SHAMIKO-project/SHAMIKO-board/docs/manual/images/PowerSeq.pdf

0ms | 8ms | 22ms

+1.0V FPGA Logic

+1.8V FPGA VCC AUX

+3.3V FPGA IO
