SHAMIKO-project/SHAMIKO-board/docs/manual/images/Clock.pdf

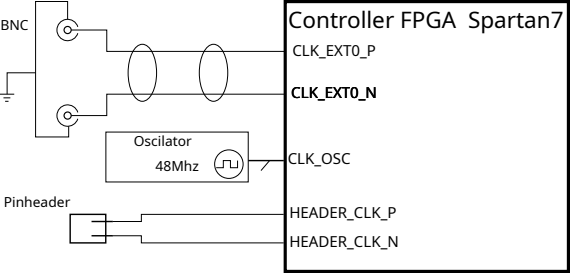
[picture p2: figure]
CLK_OSC; HEADER_CLK_P HEADER_CLK_N; Controller FPGA Spartan7; 48Mhz; Oscilator; BNC; Pinheader; CLK_EXT0_NCLK_EXT0_N CLK_EXT0_N; CLK_EXT0_P
