SHAMIKO-project/SHAMIKO-board/docs/manual/images/LT3071.pdf

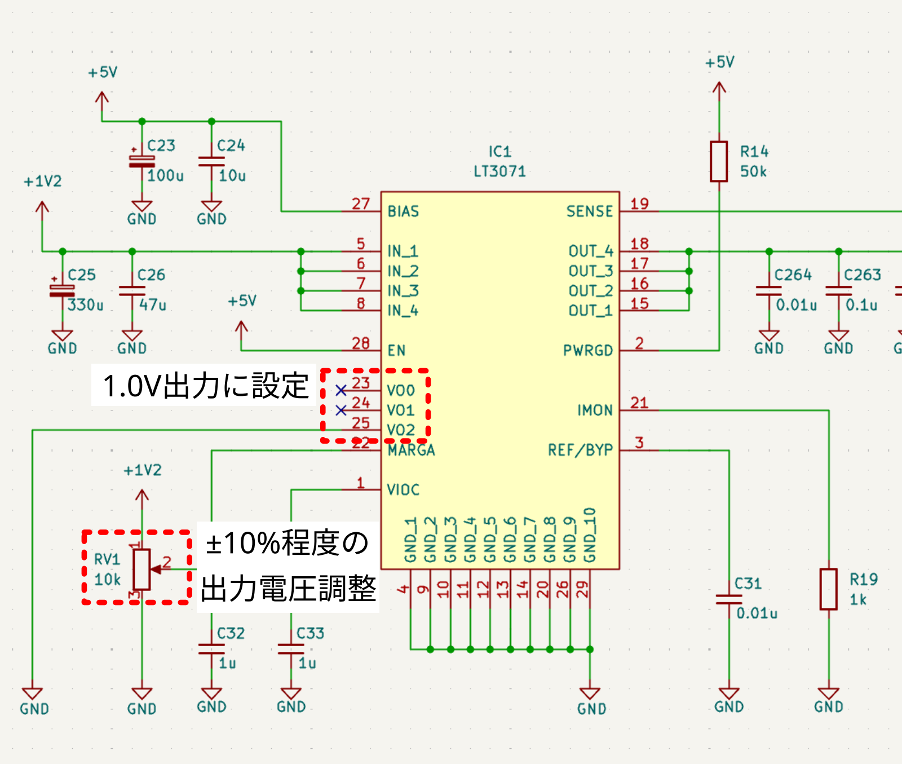
[picture p3: page 1]

1.0V出力に設定

±10%程度の
出力電圧調整
