SHAMIKO-project/SHAMIKO-board/docs/manual/images/System.pdf

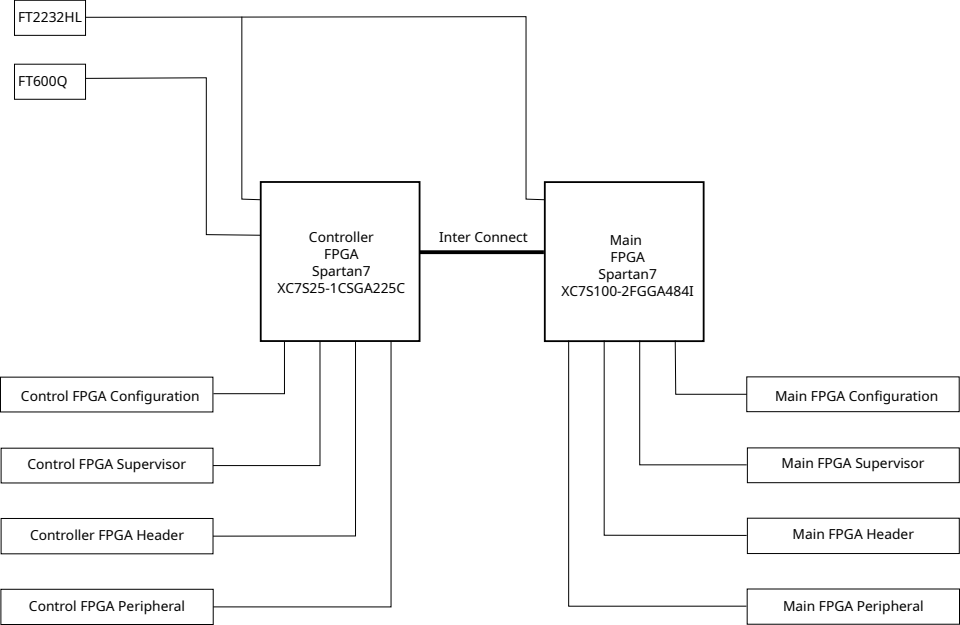
[picture p4: figure]
Controller FPGA Spartan7 XC7S25-1CSGA225C; Control FPGA Configuration; Control FPGA Supervisor; Controller FPGA Header; Control FPGA Peripheral; Main FPGA Configuration; Main FPGA Supervisor; Main FPGA Header; Main FPGA Peripheral; Main FPGA Spartan7 XC7S100-2FGGA484I; Inter Connect
