SHAMIKO-project/SHAMIKO-board/docs/manual/images/USB.pdf

# USB2

USB3 | FT600 | MainFPGA Controller
FPGA

~200 MB/s

~40 MB/s

FT2232 | ~40 MB/s
