SHAMIKO-project/SHAMIKO-board/docs/schematic.pdf

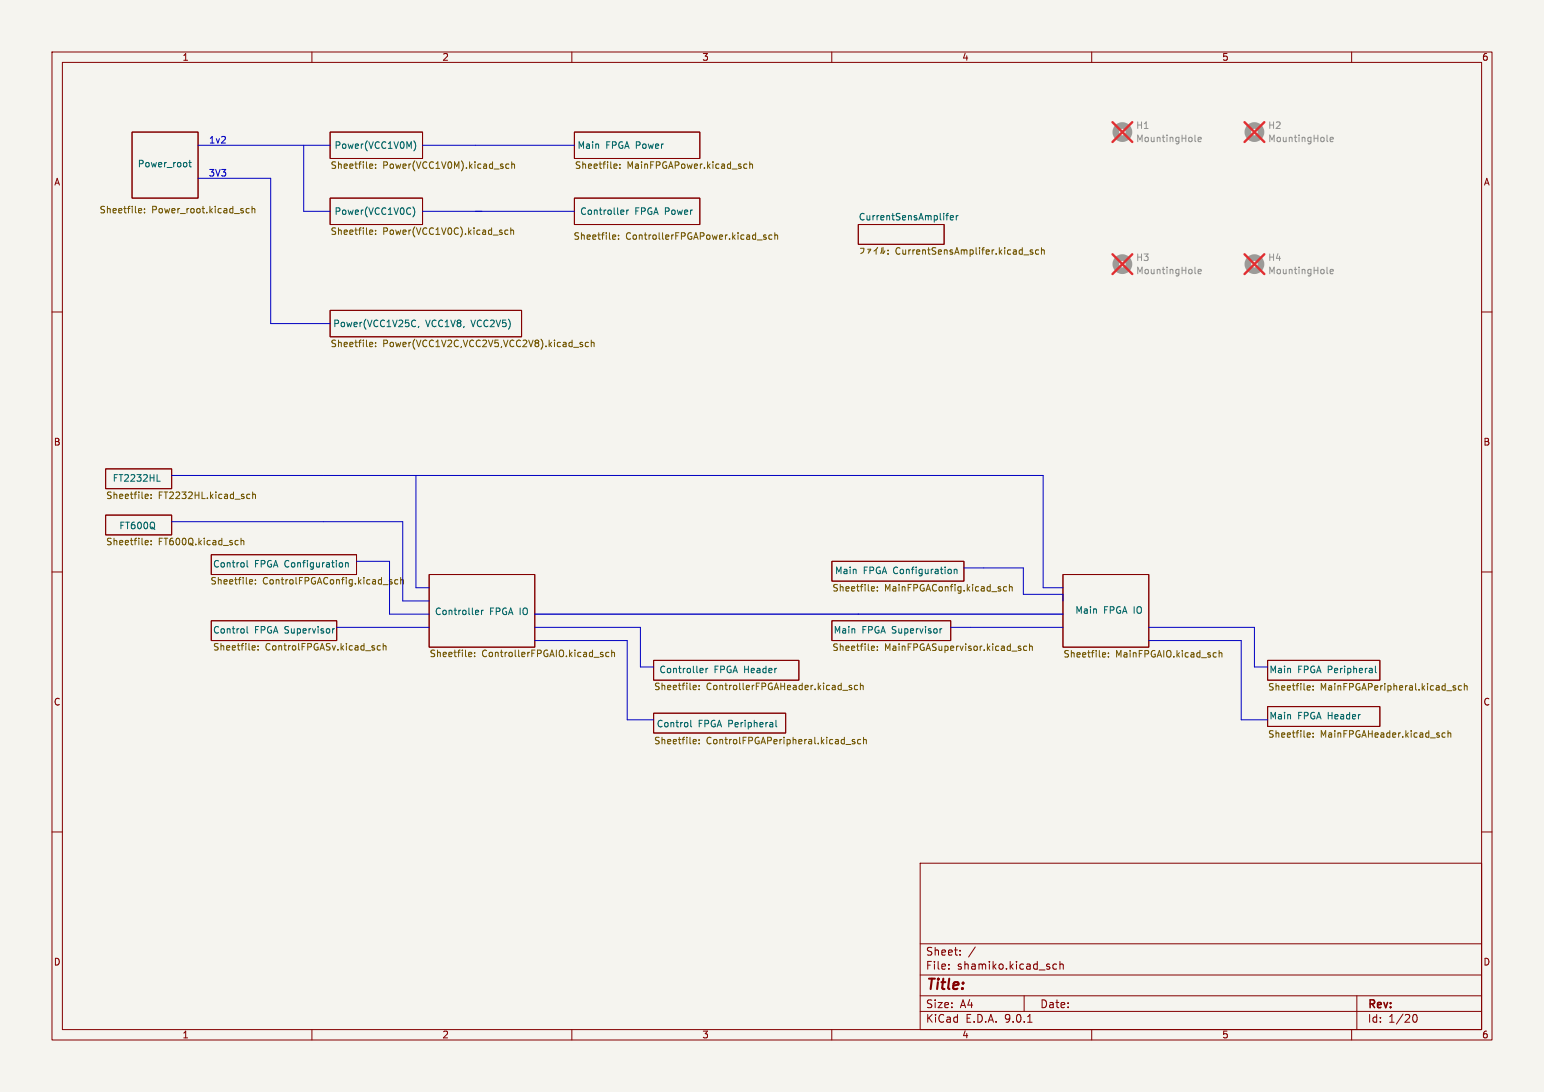
[picture p5: page 1]

Id: 1/20 Title: File: shamiko.kicad_sch Sheet: /

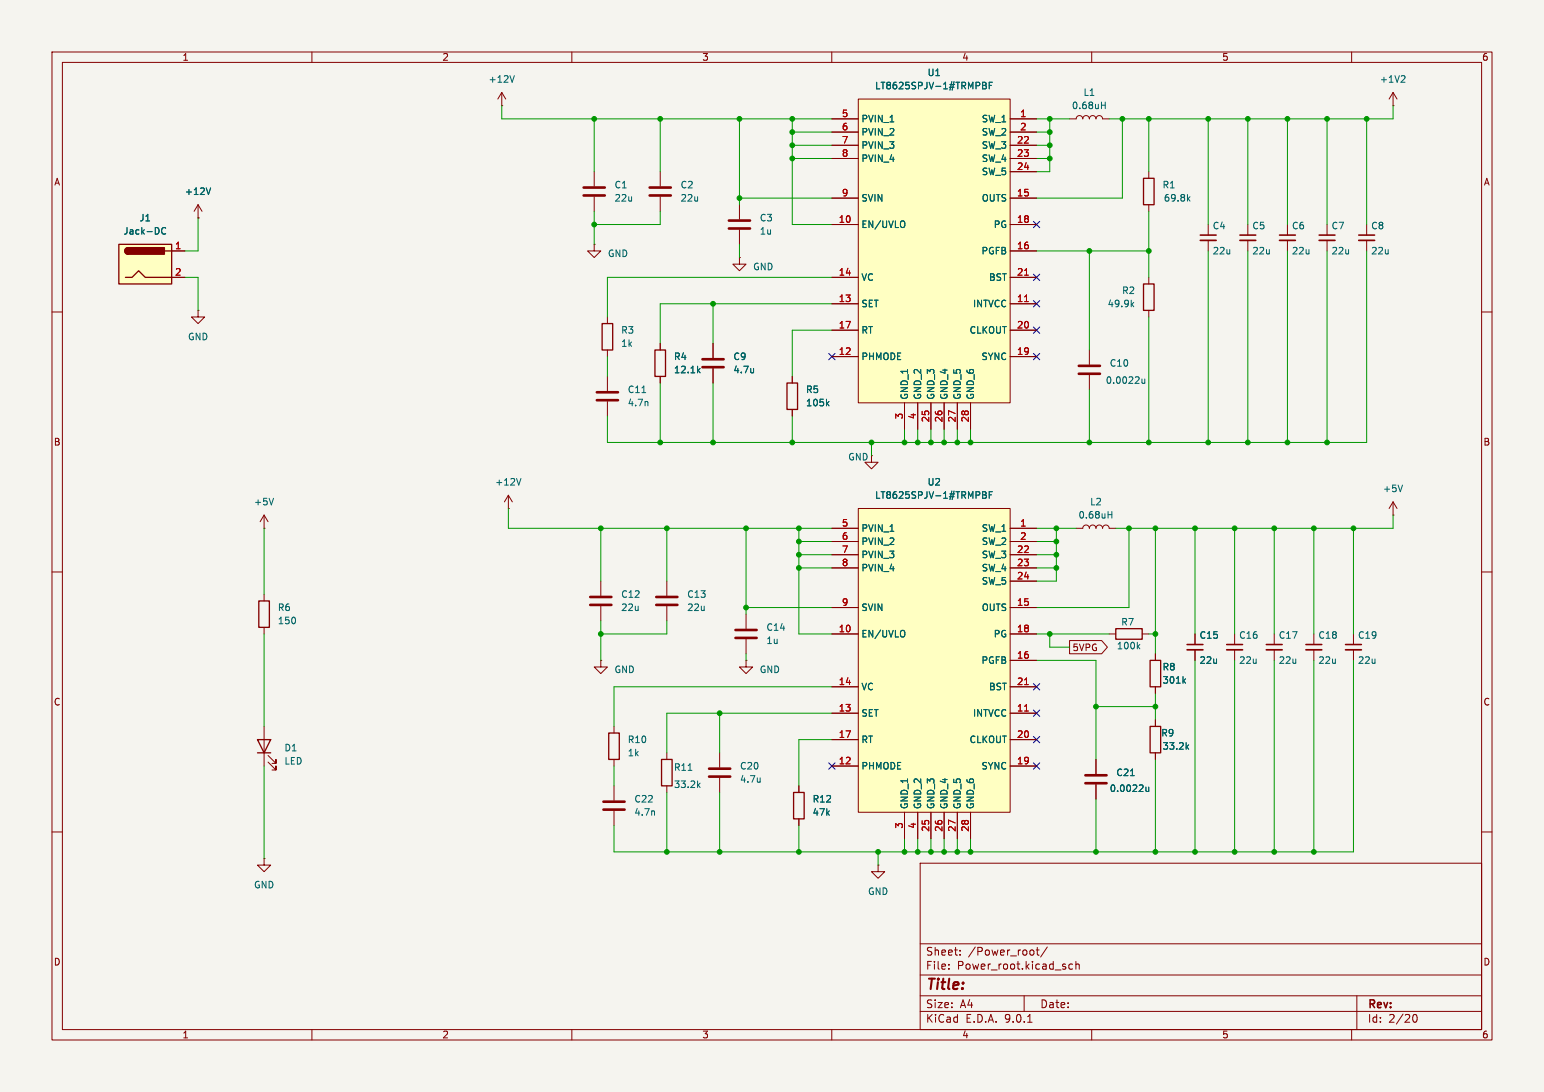
[picture p6: page 2]

Id: 2/20 Title: File: Power_root.kicad_sch Sheet: /Power_root/

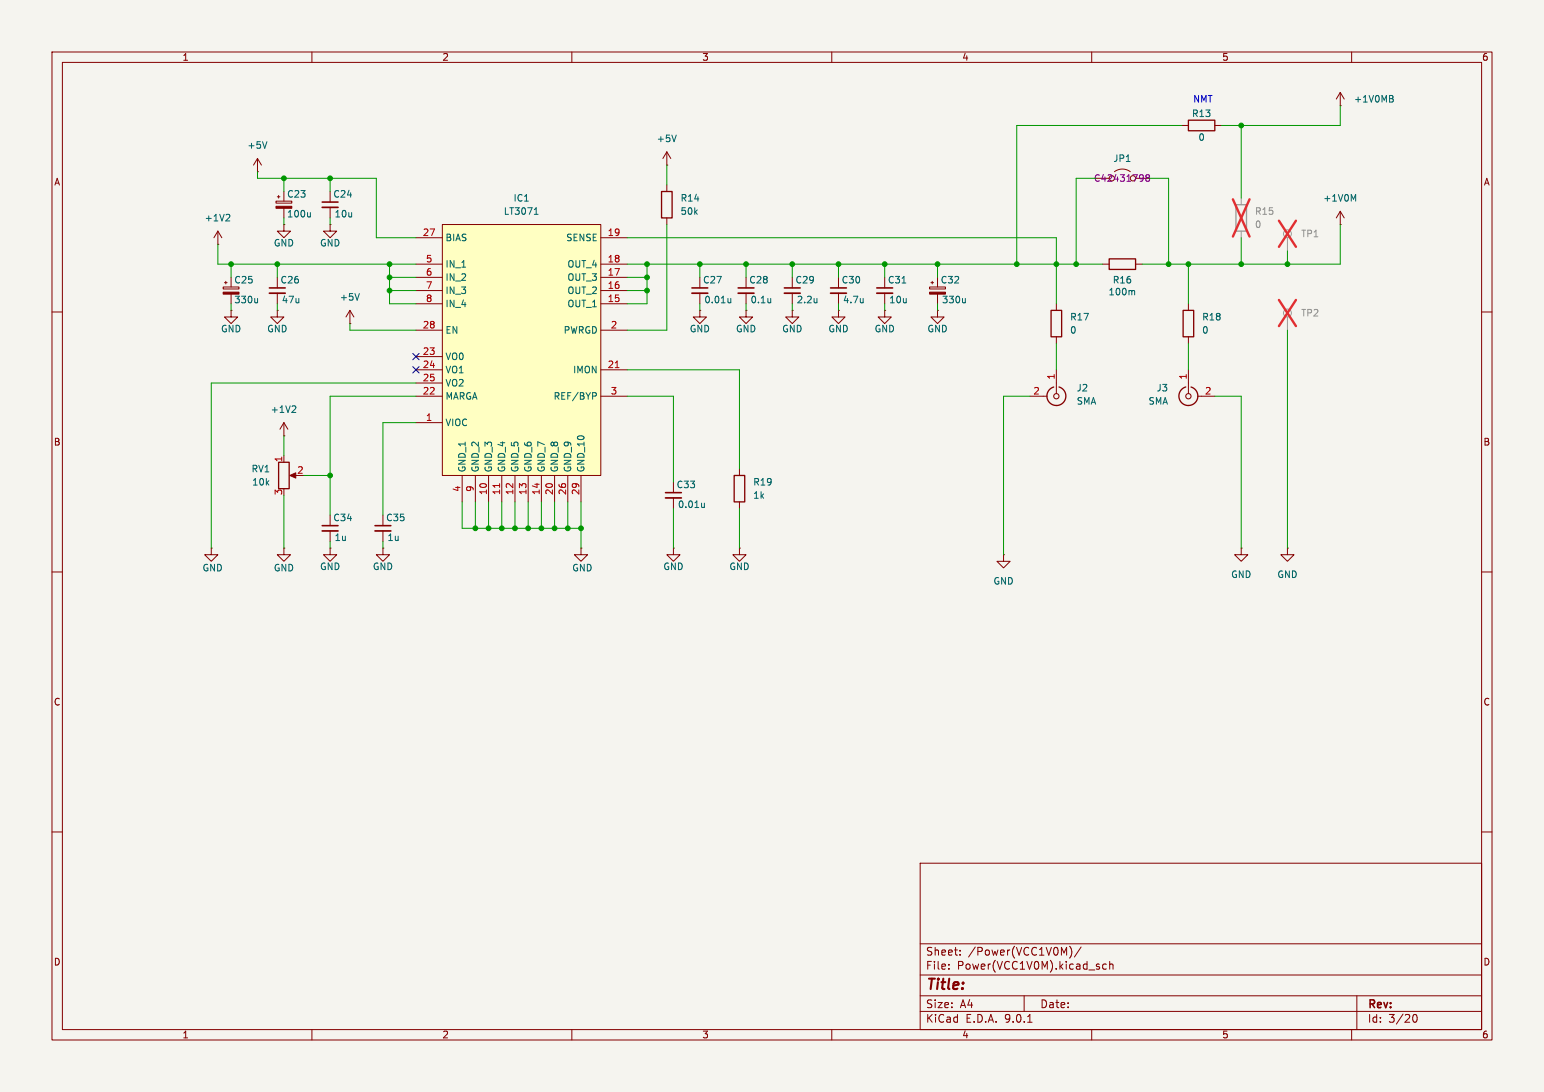
[picture p7: page 3]

Id: 3/20 Title: File: Power(VCC1V0M).kicad_sch Sheet: /Power(VCC1V0M)/

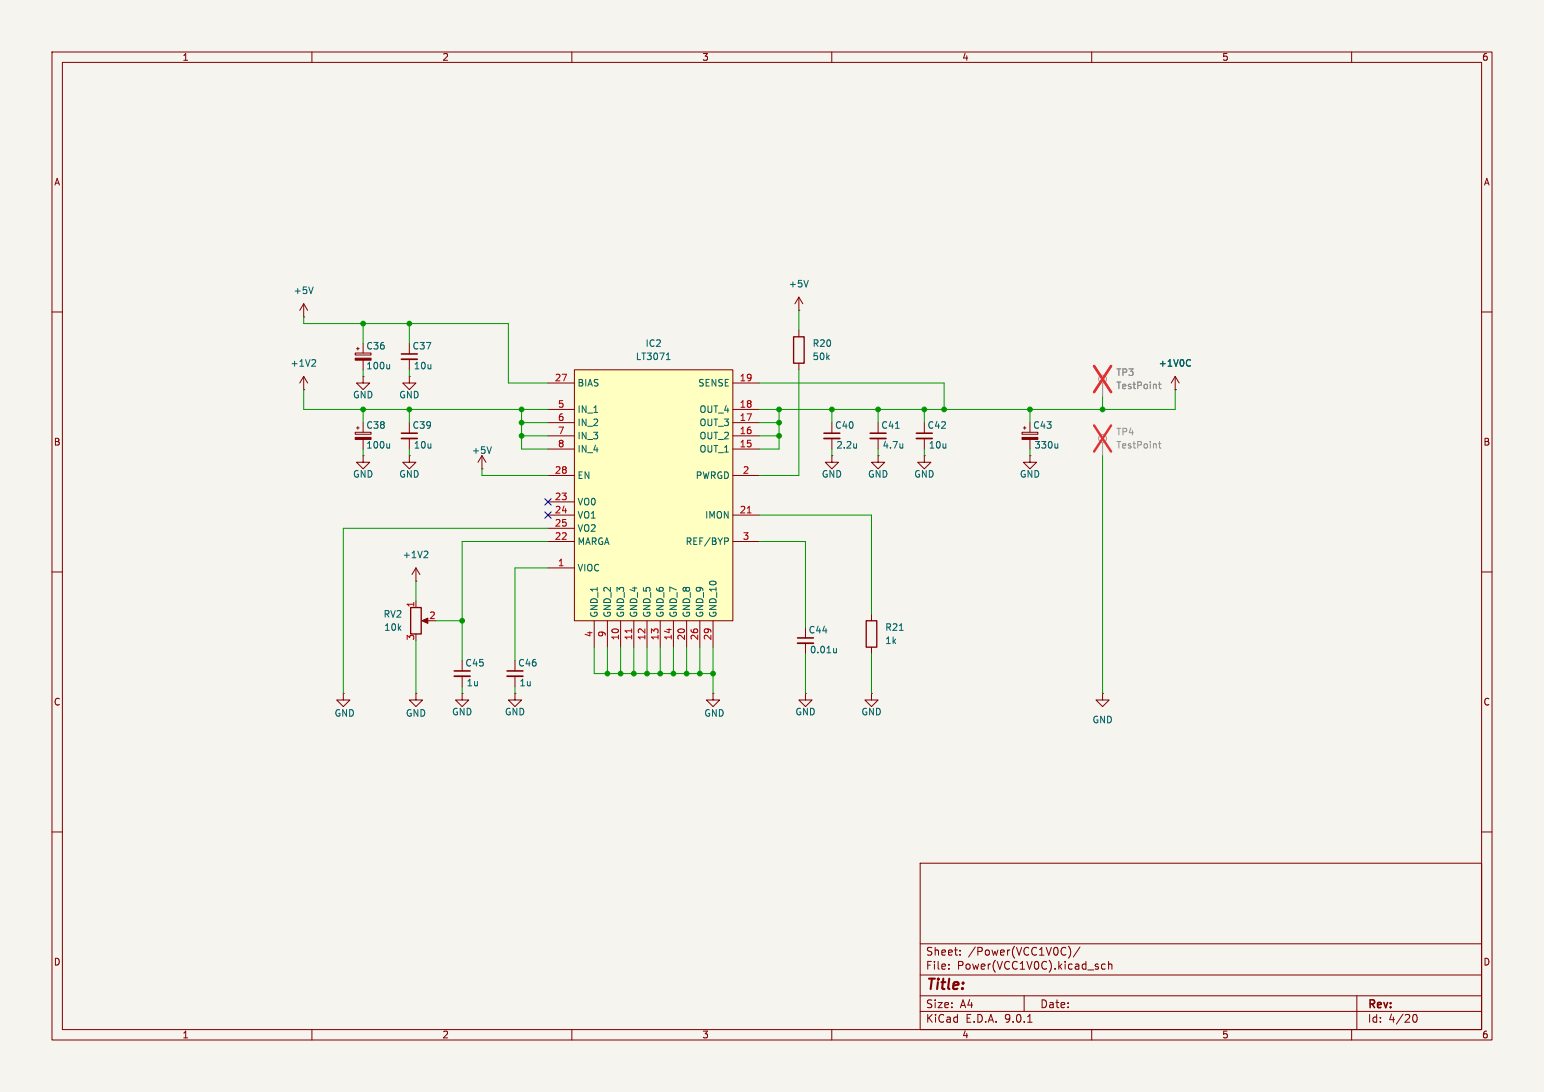
[picture p8: page 4]

Id: 4/20 Title: File: Power(VCC1V0C).kicad_sch Sheet: /Power(VCC1V0C)/ C44

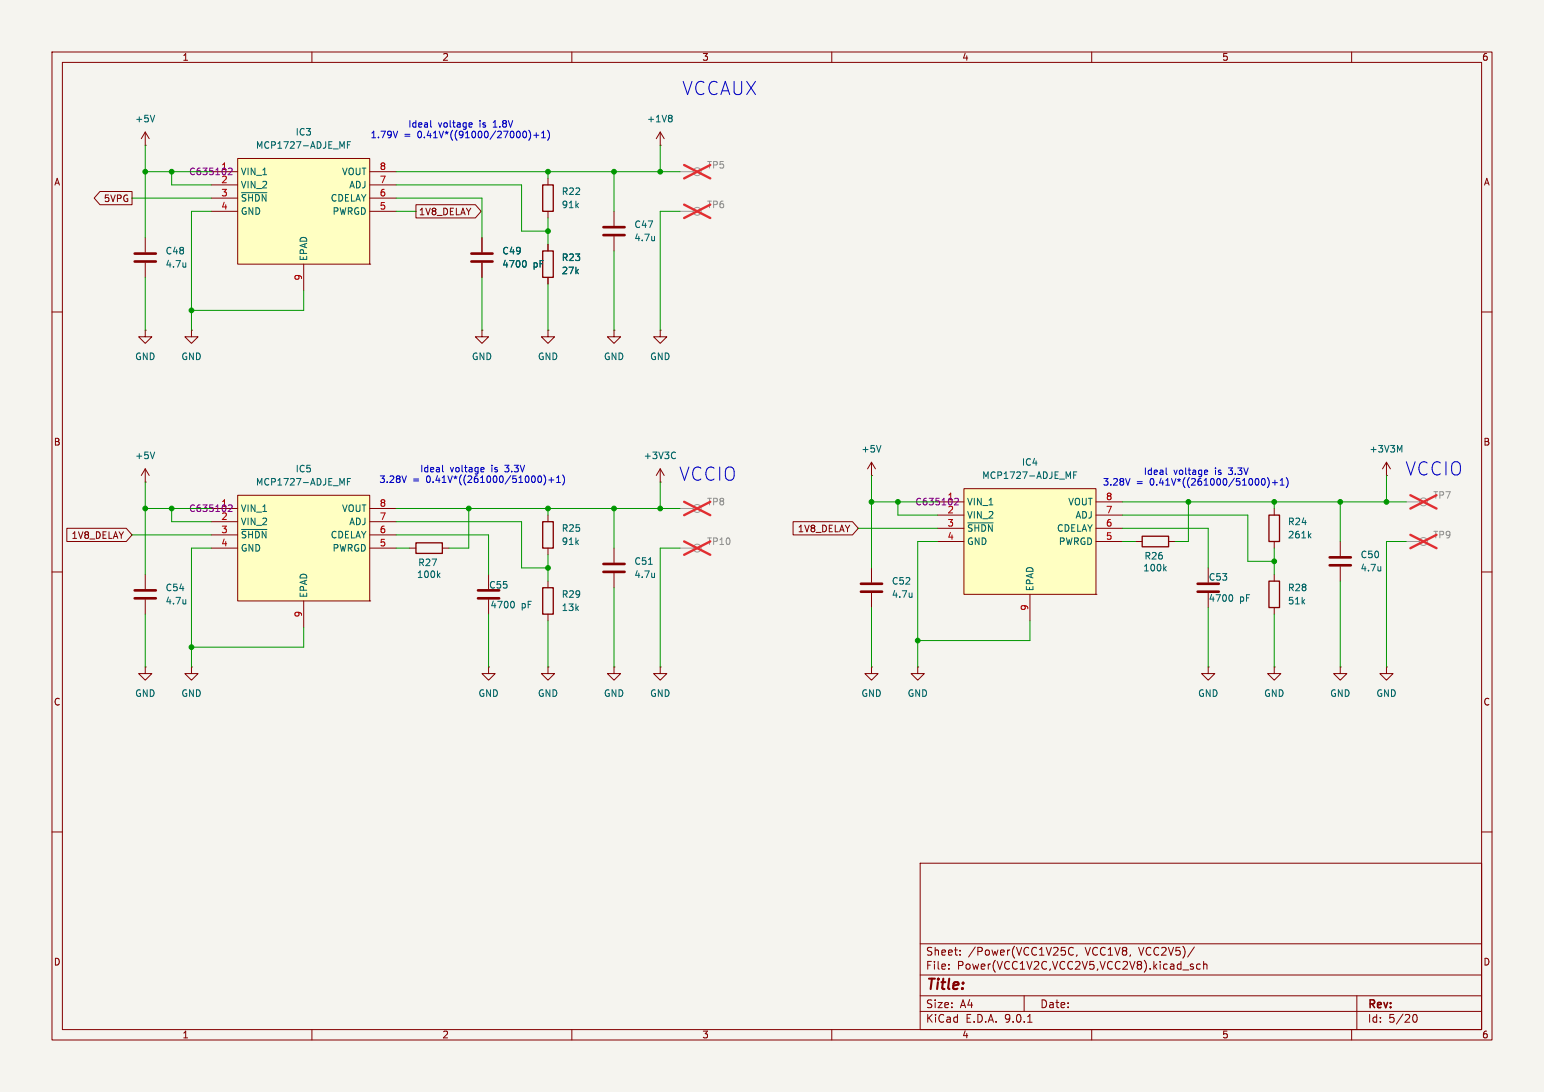
[picture p9: page 5]

9 VOUT 8 ADJ 7 CDELAY 6 PWRGD 5

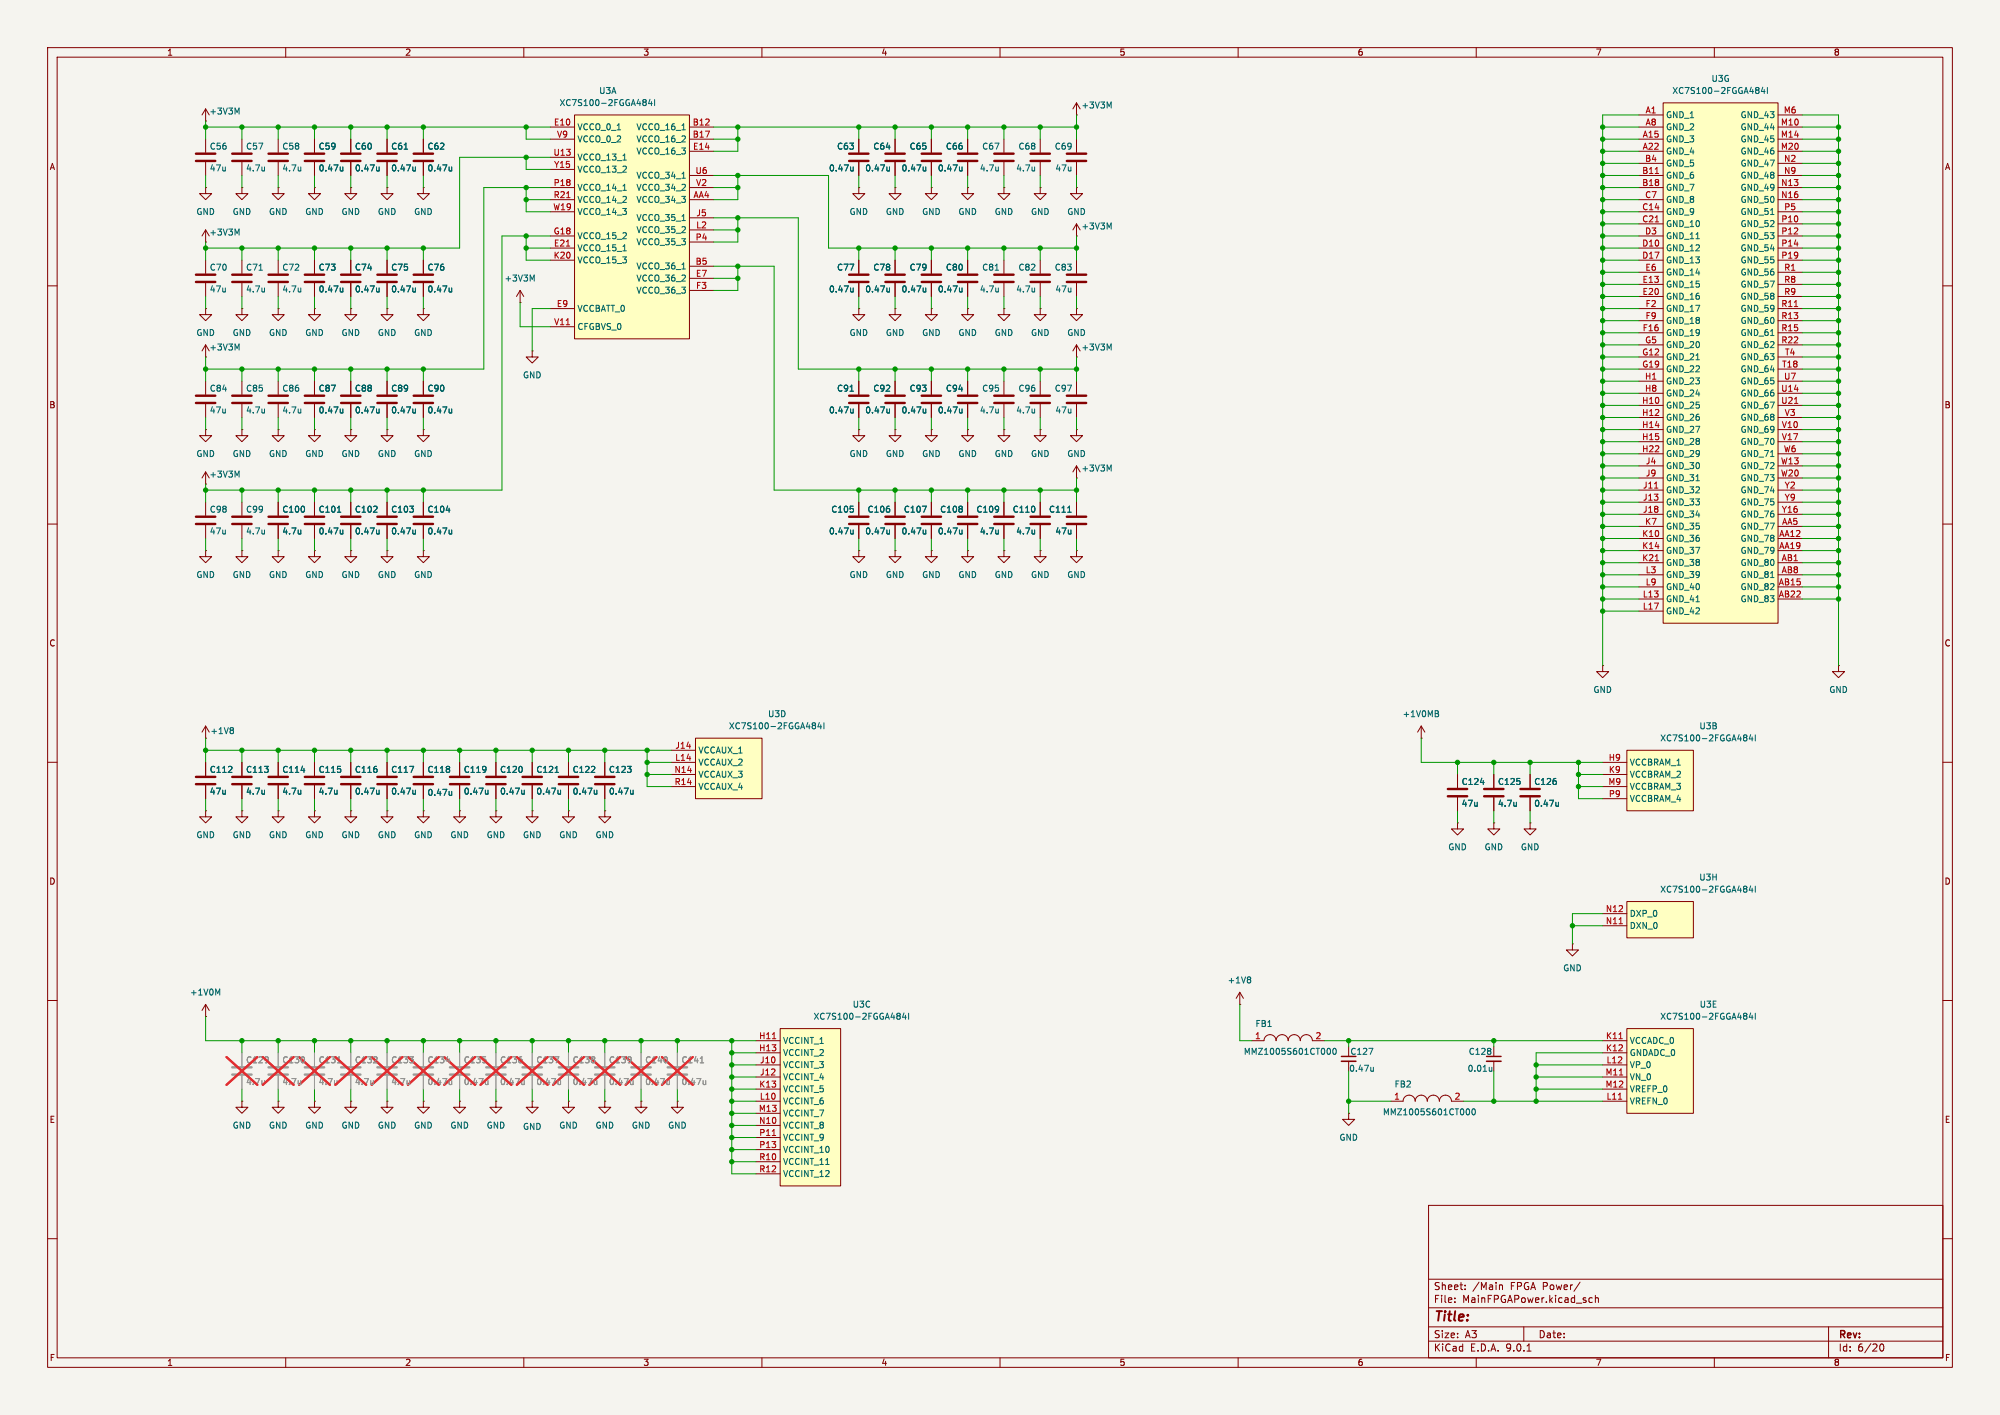
[picture p10: page 6]

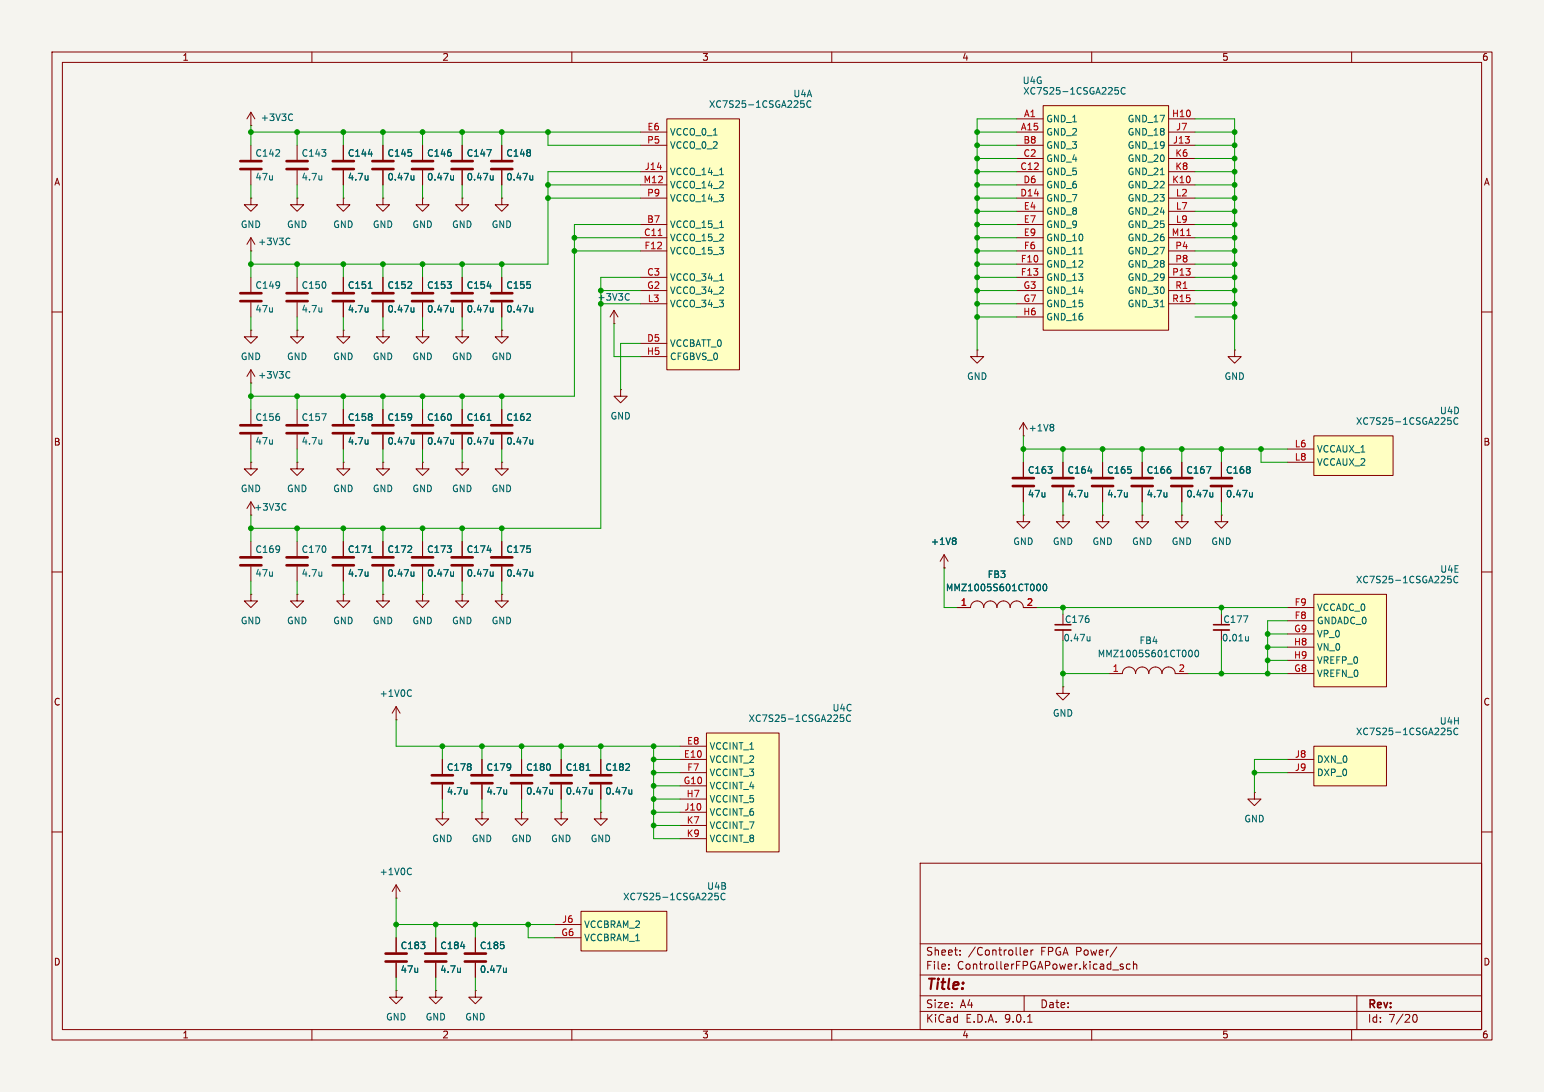
[picture p11: page 7]

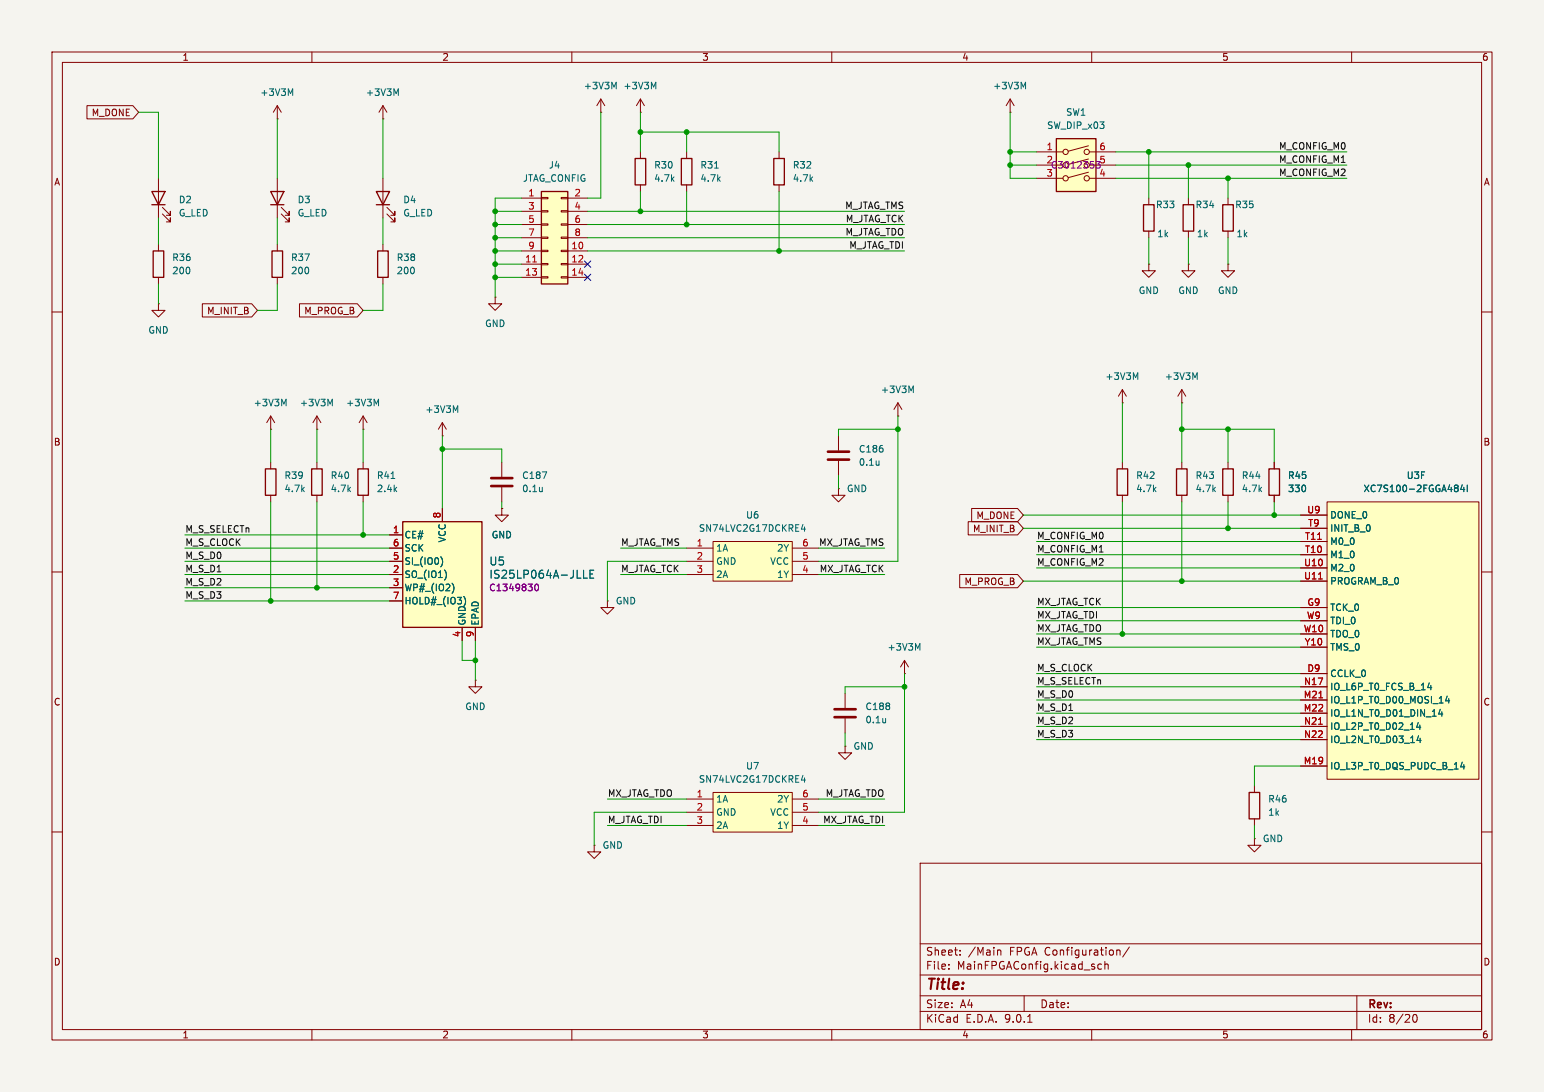
[picture p12: page 8]

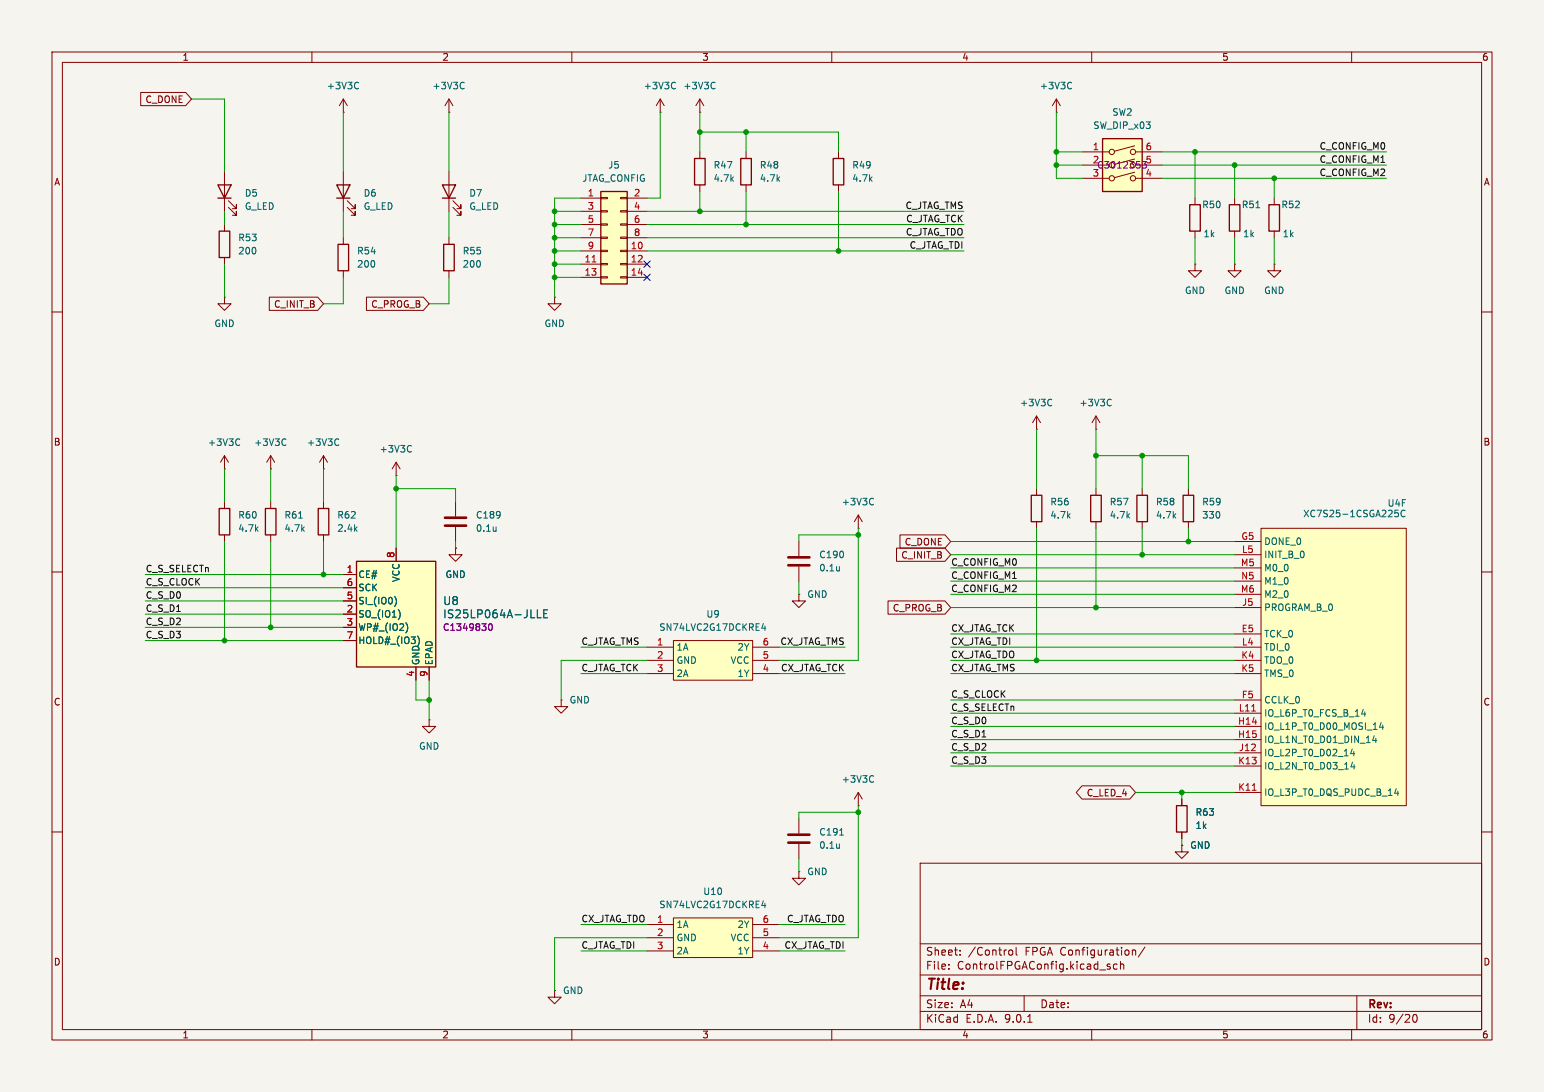
[picture p13: page 9]

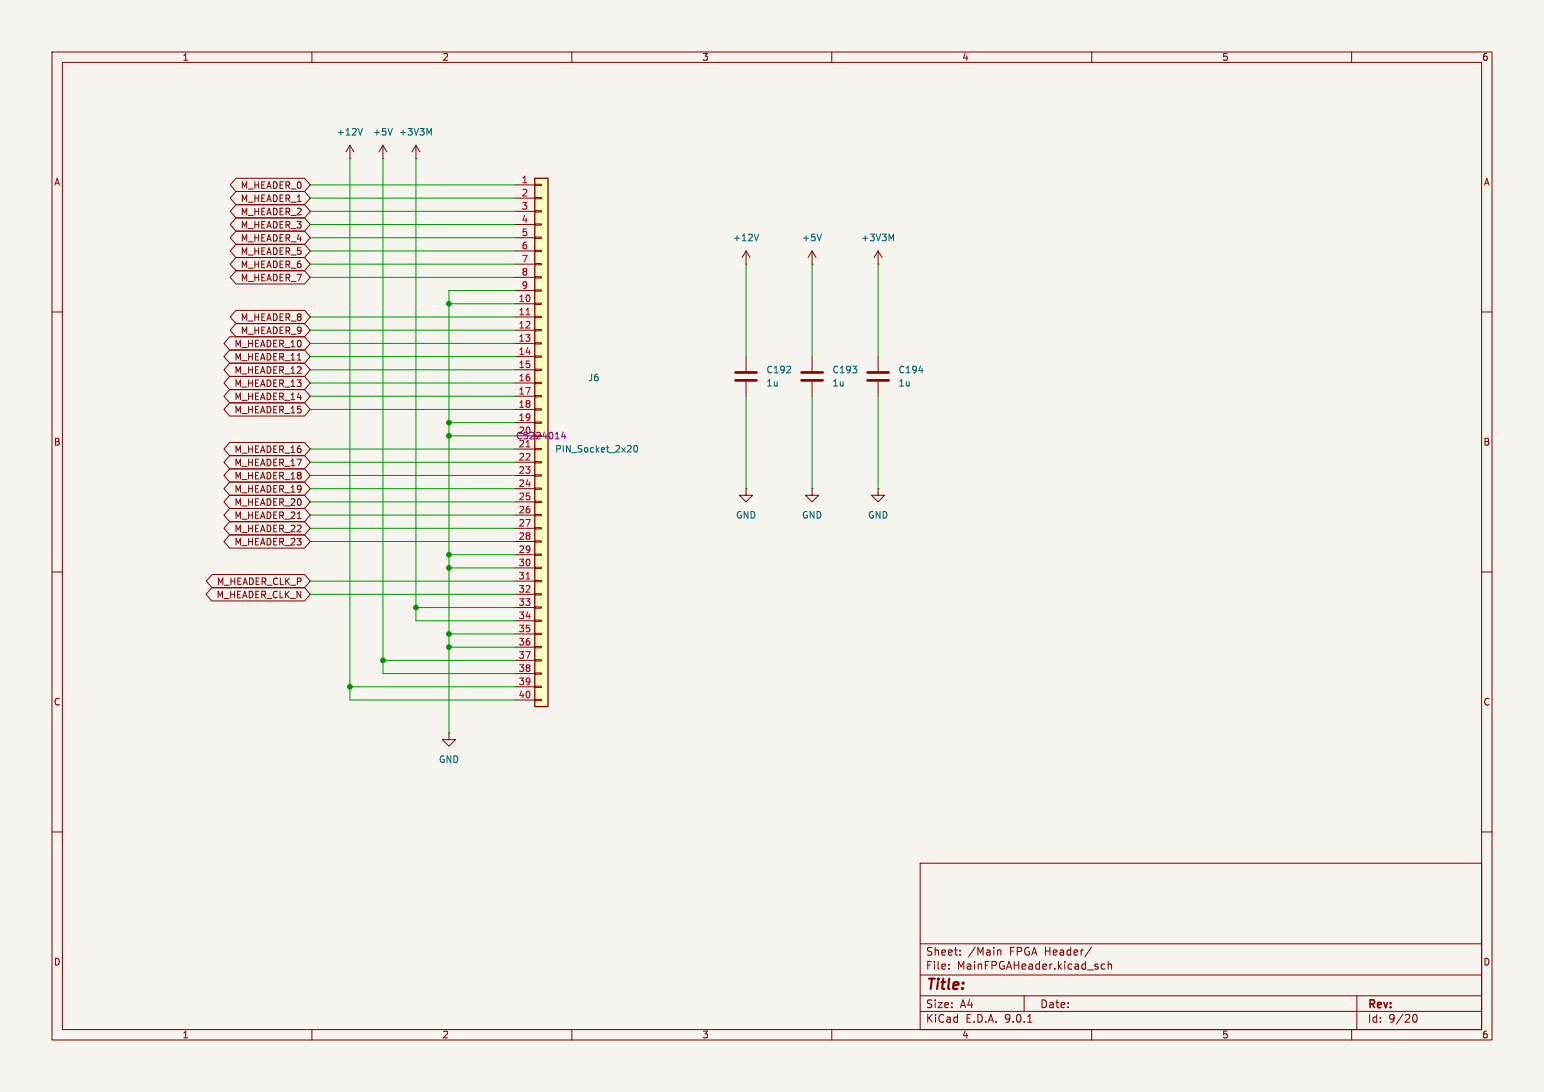
[picture p14: page 10]

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
26 | J6 PIN_Socket_2x20 C5224014 GND

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
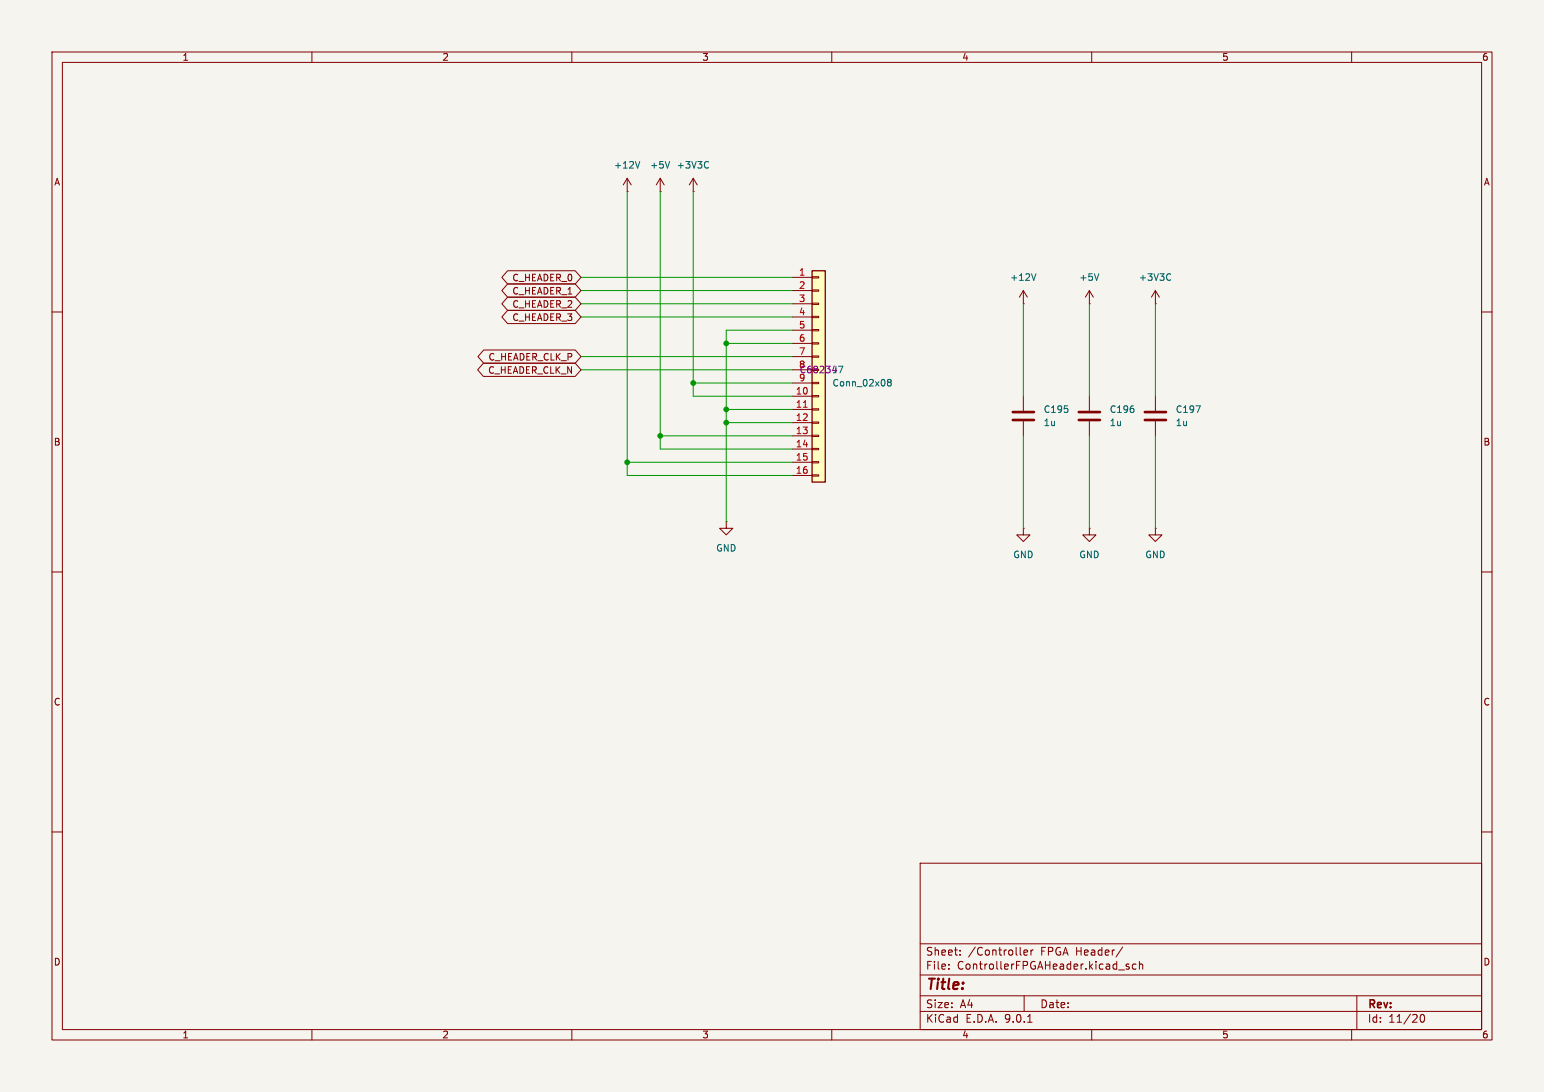
[picture p15: page 11]

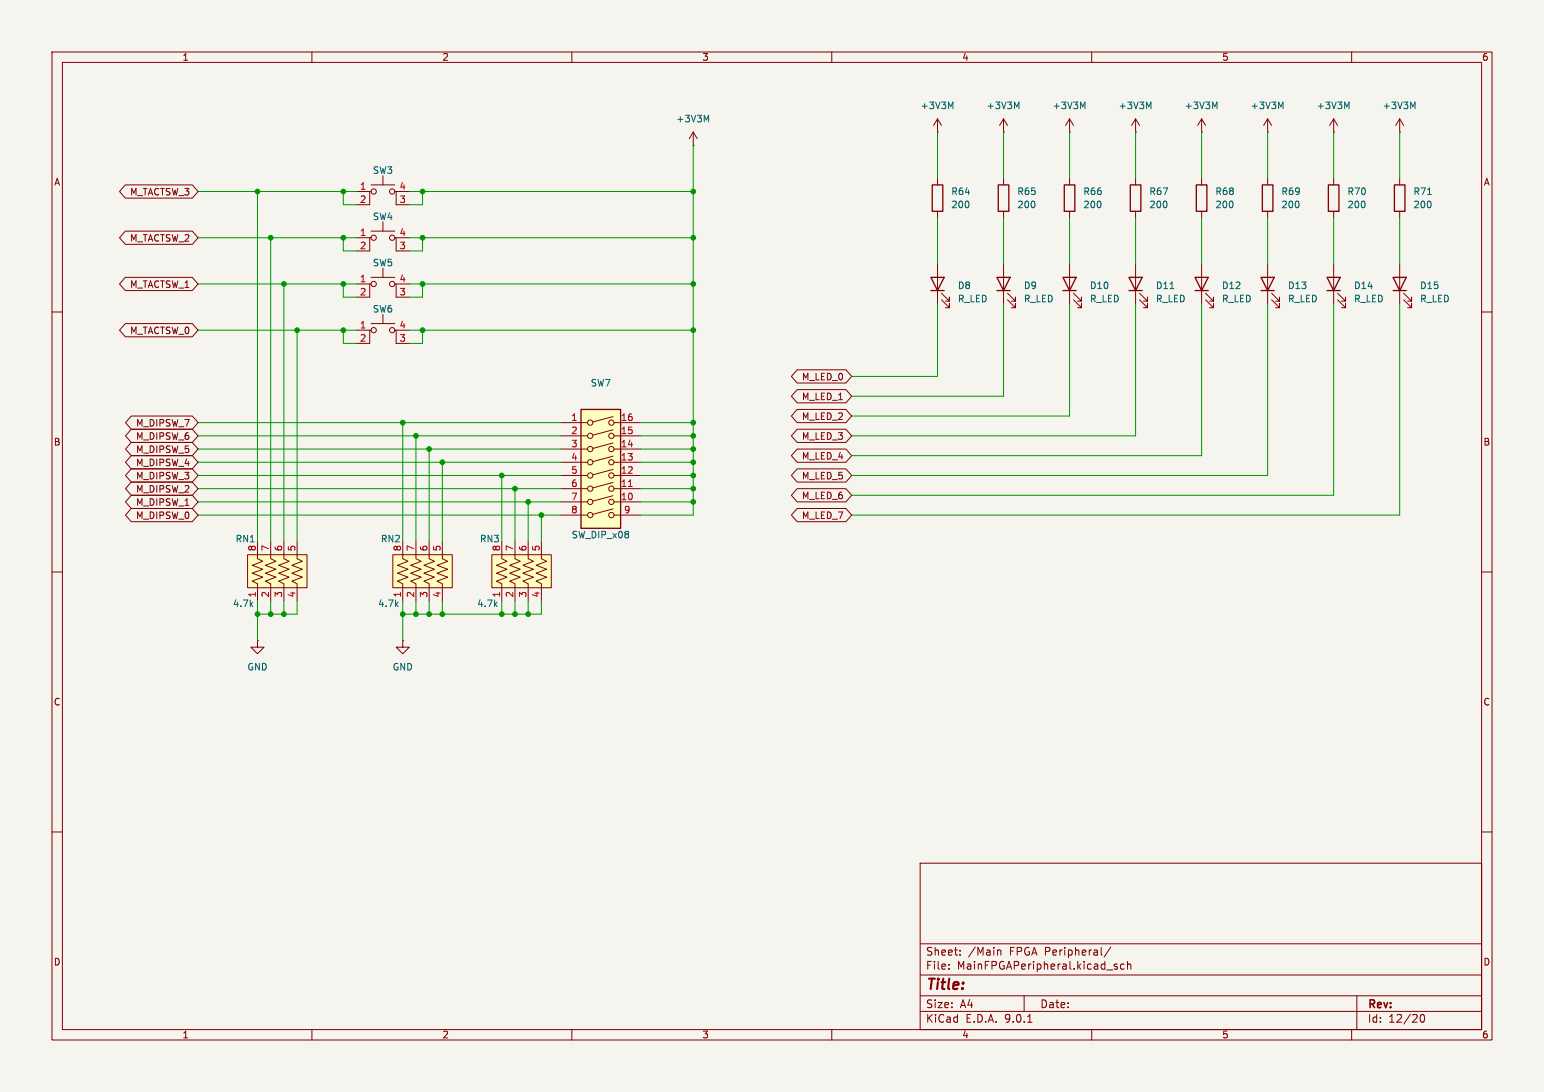
[picture p16: page 12]

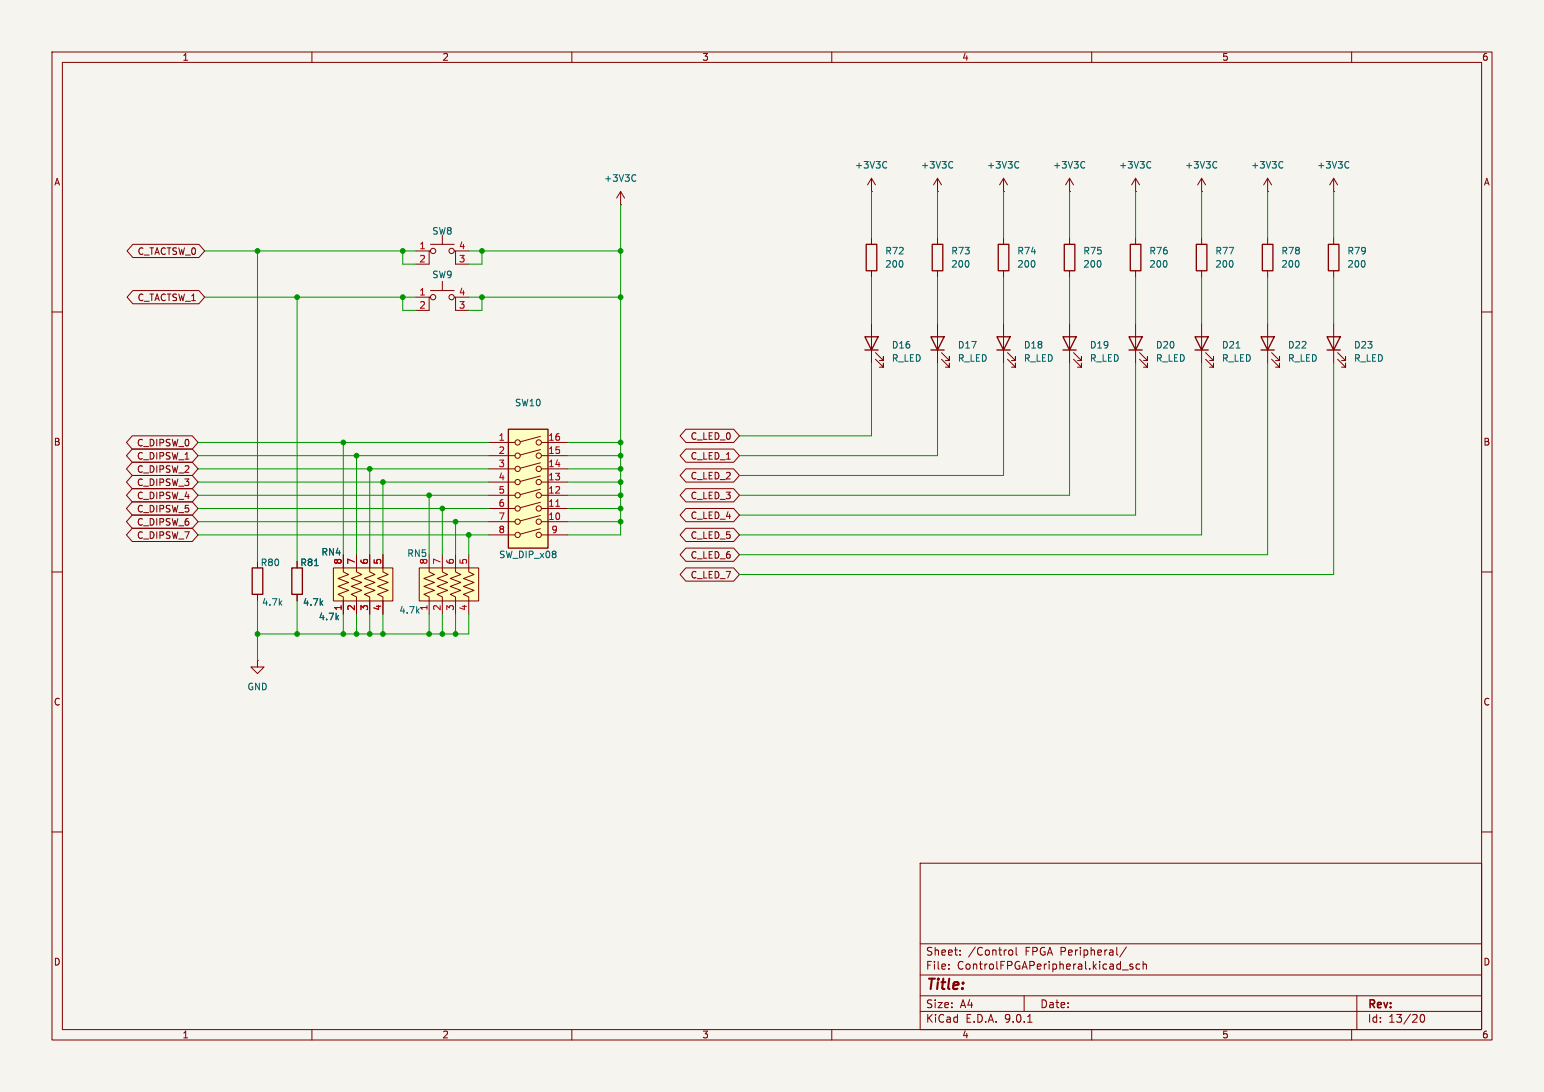
[picture p17: page 13]

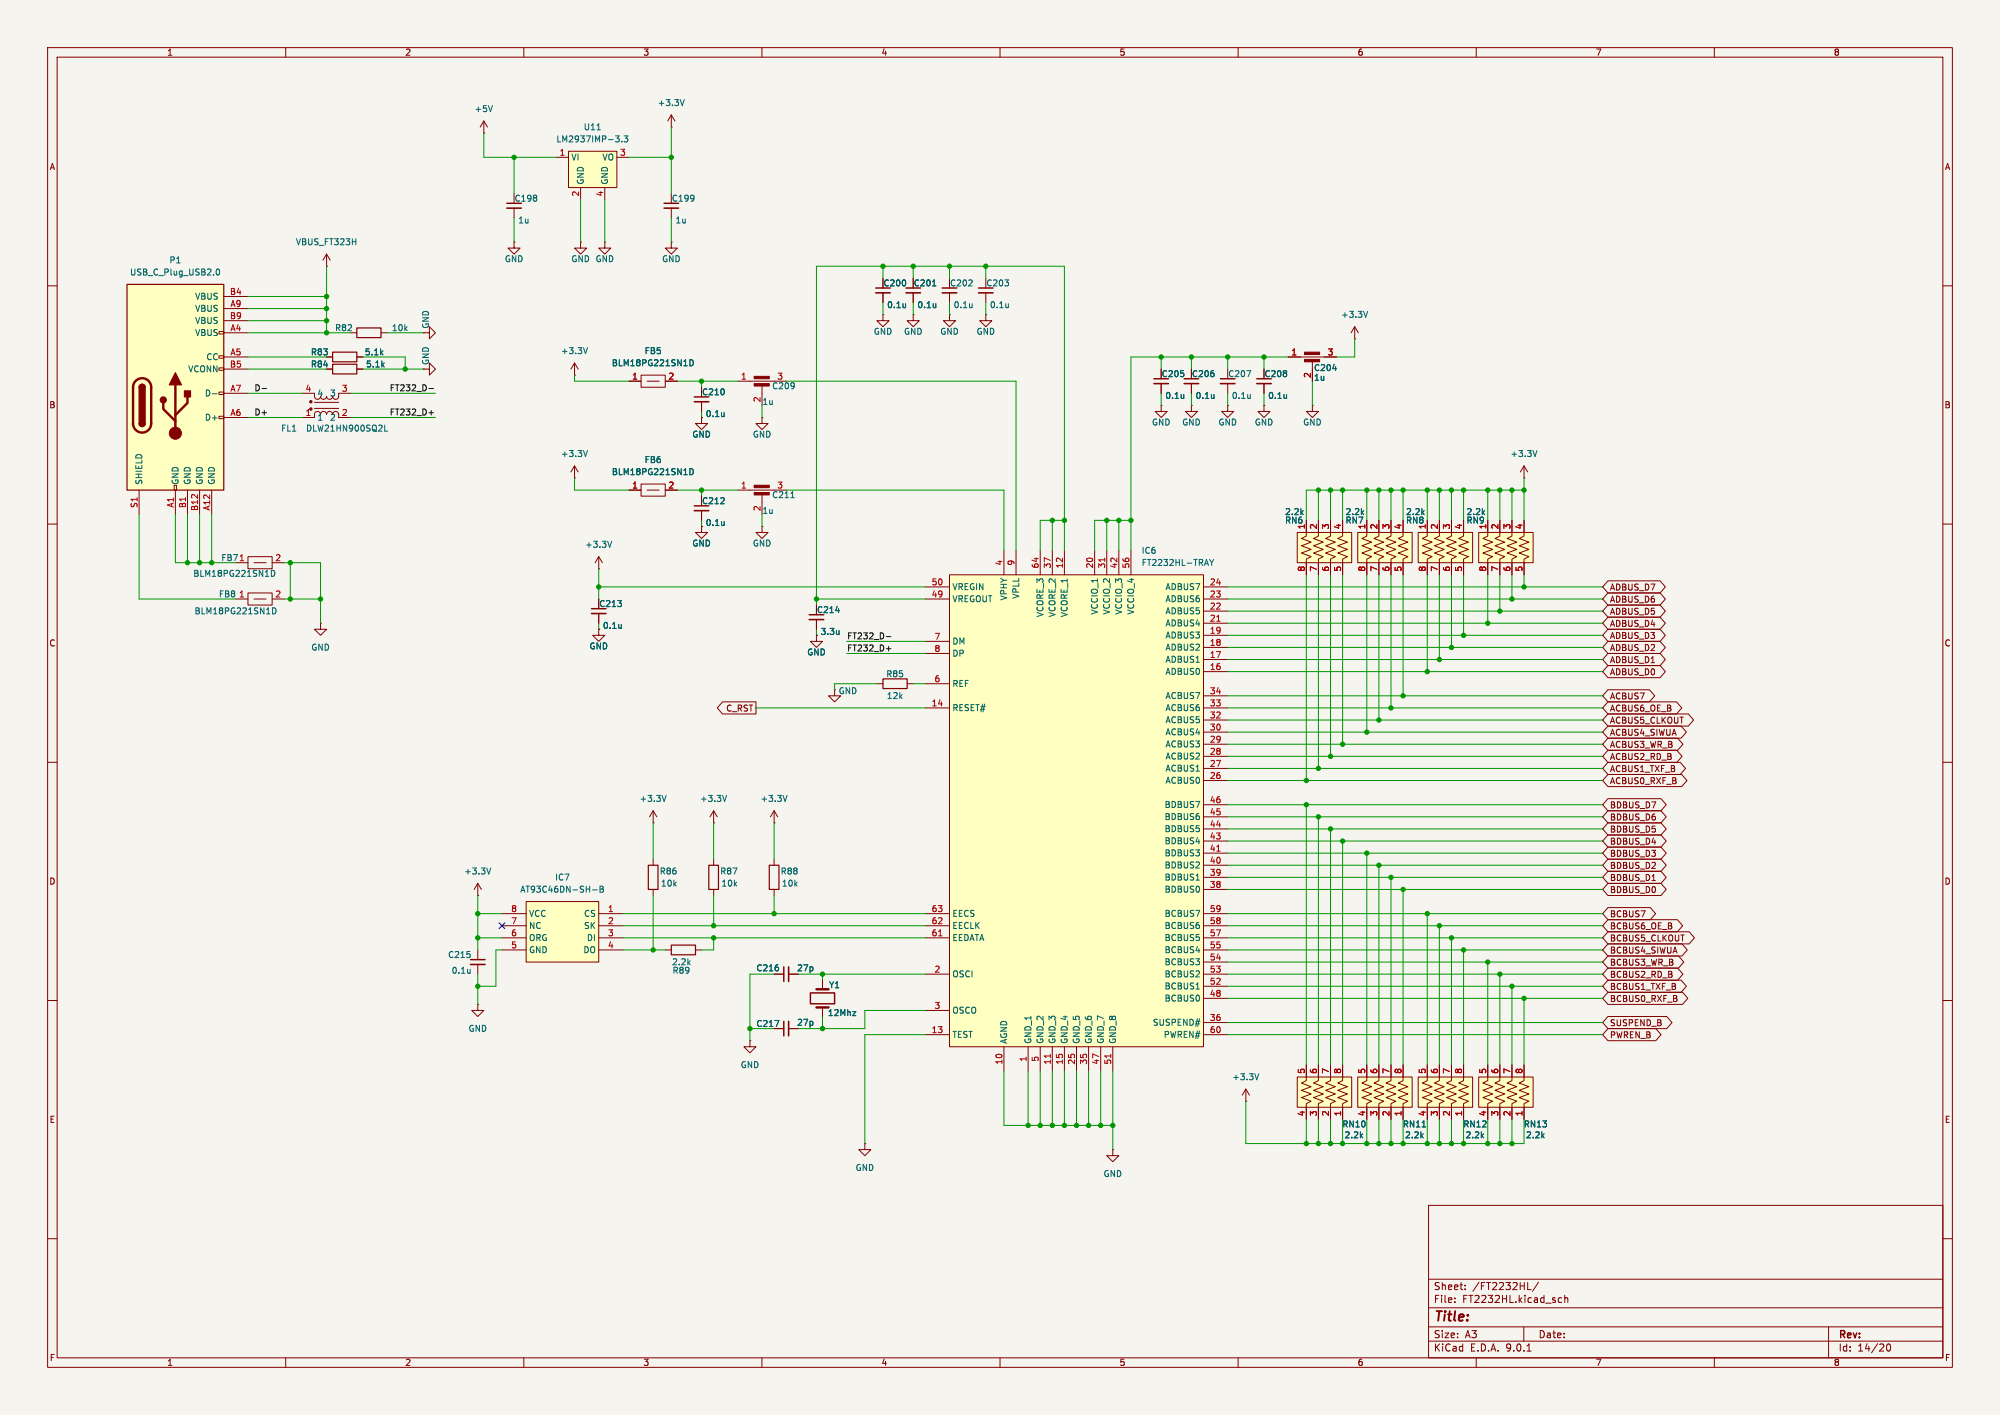
[picture p18: page 14]

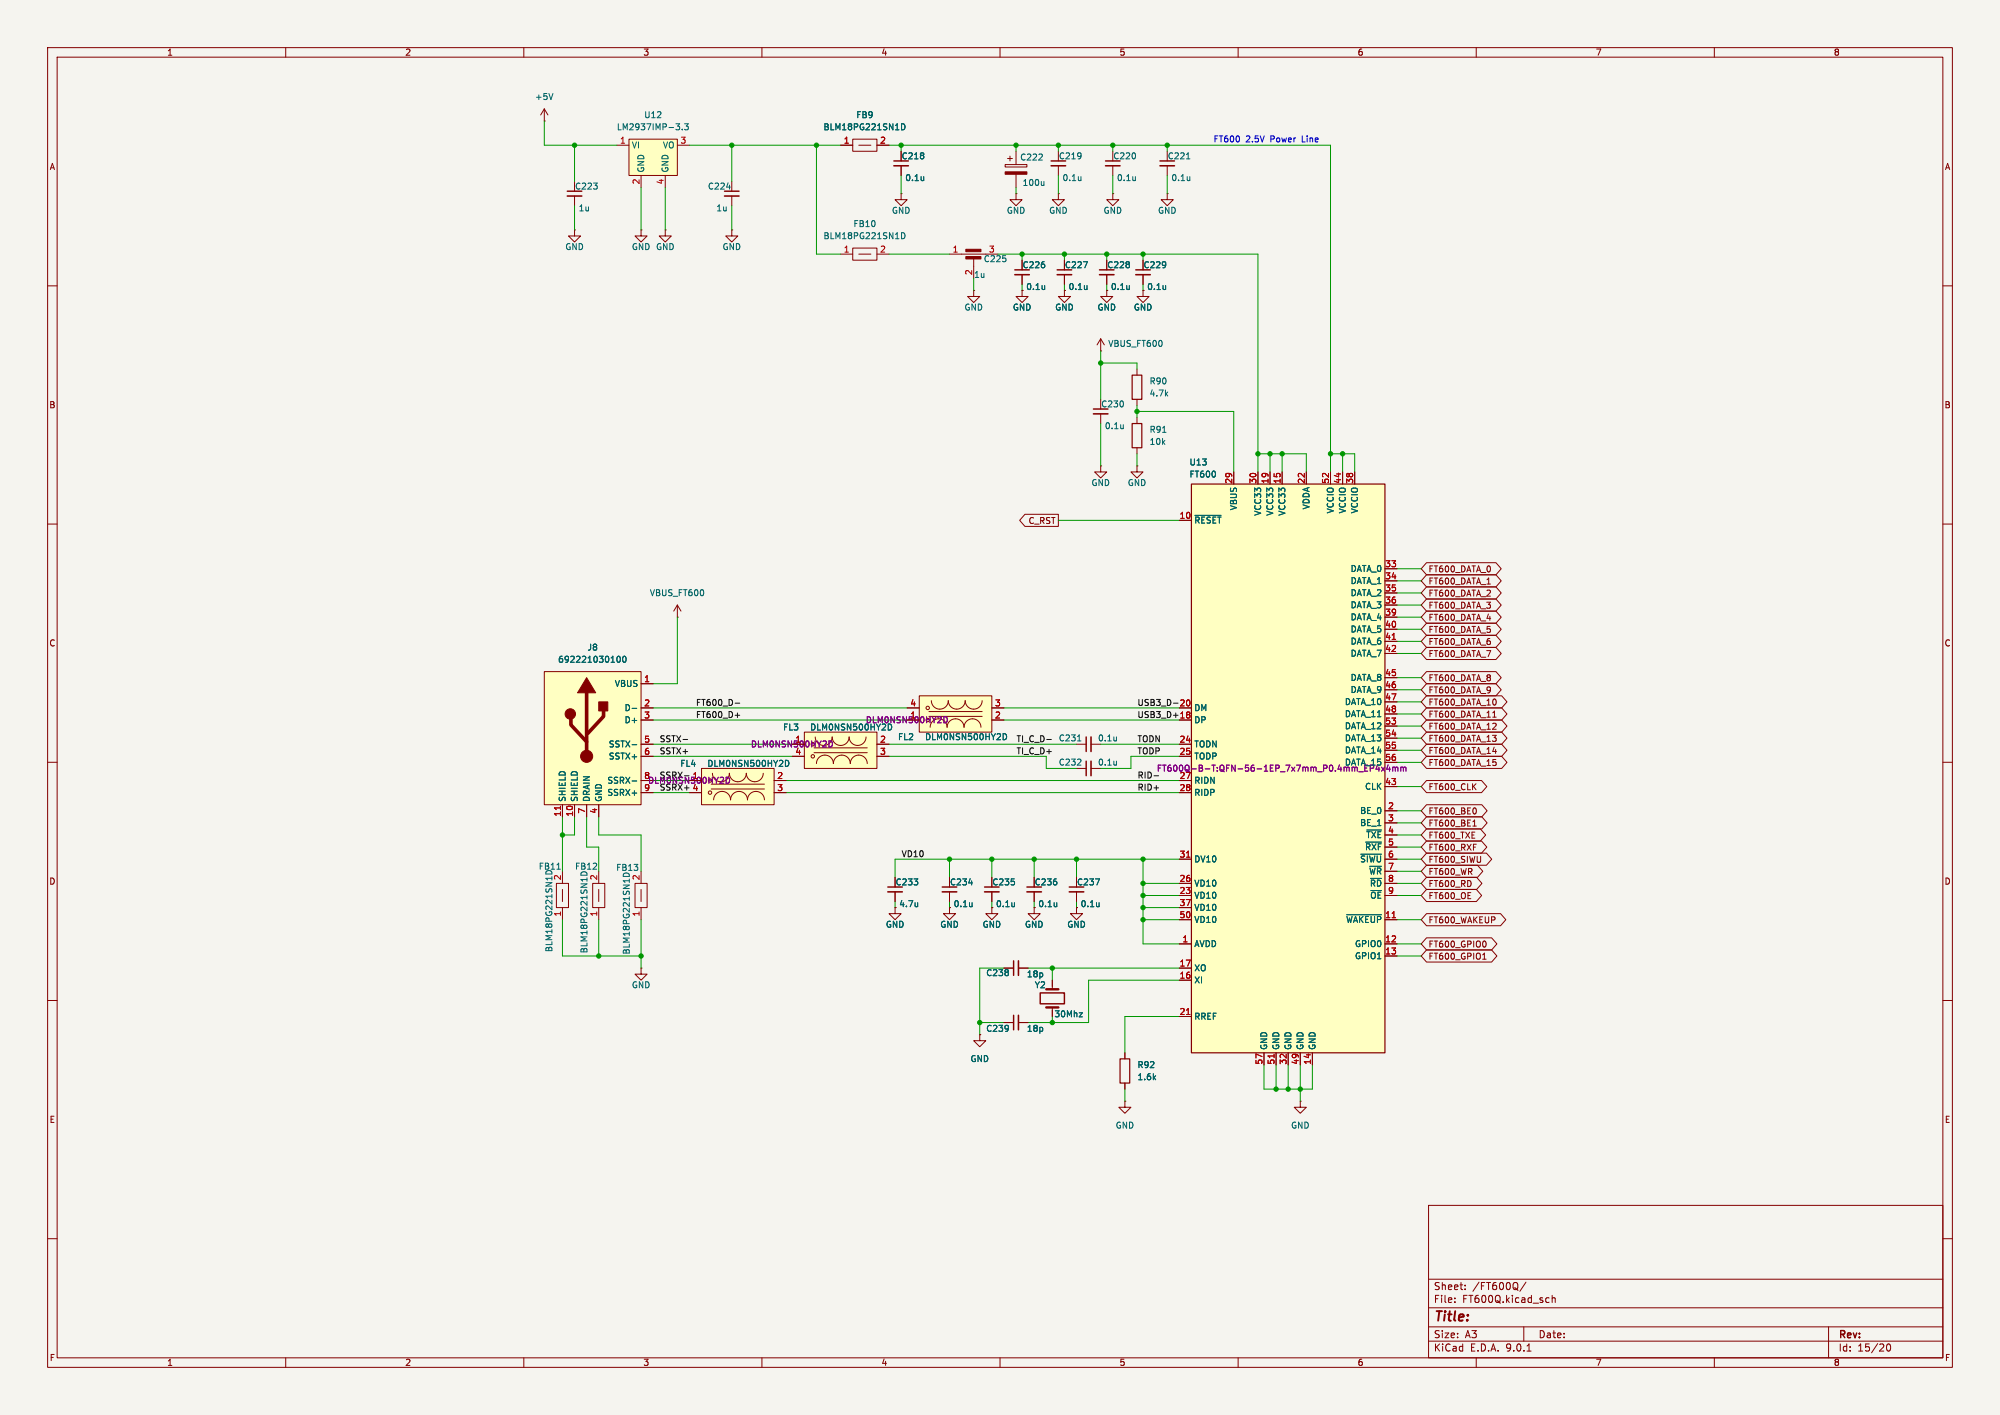
[picture p19: page 15]

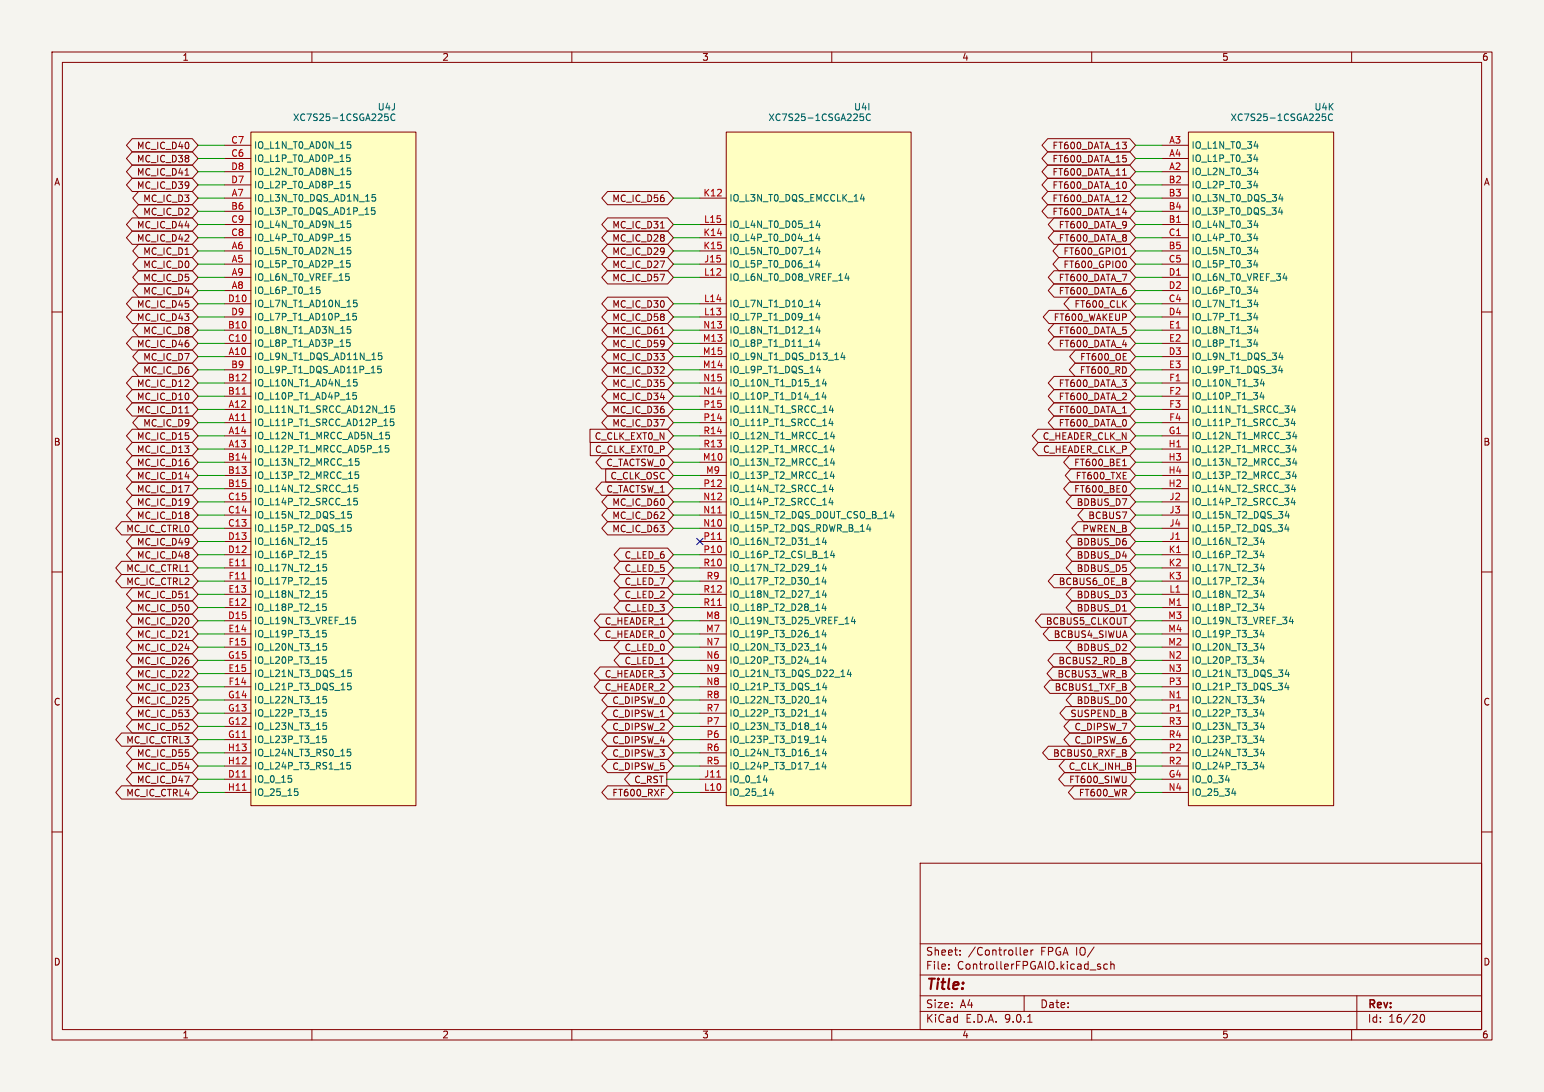
[picture p20: page 16]

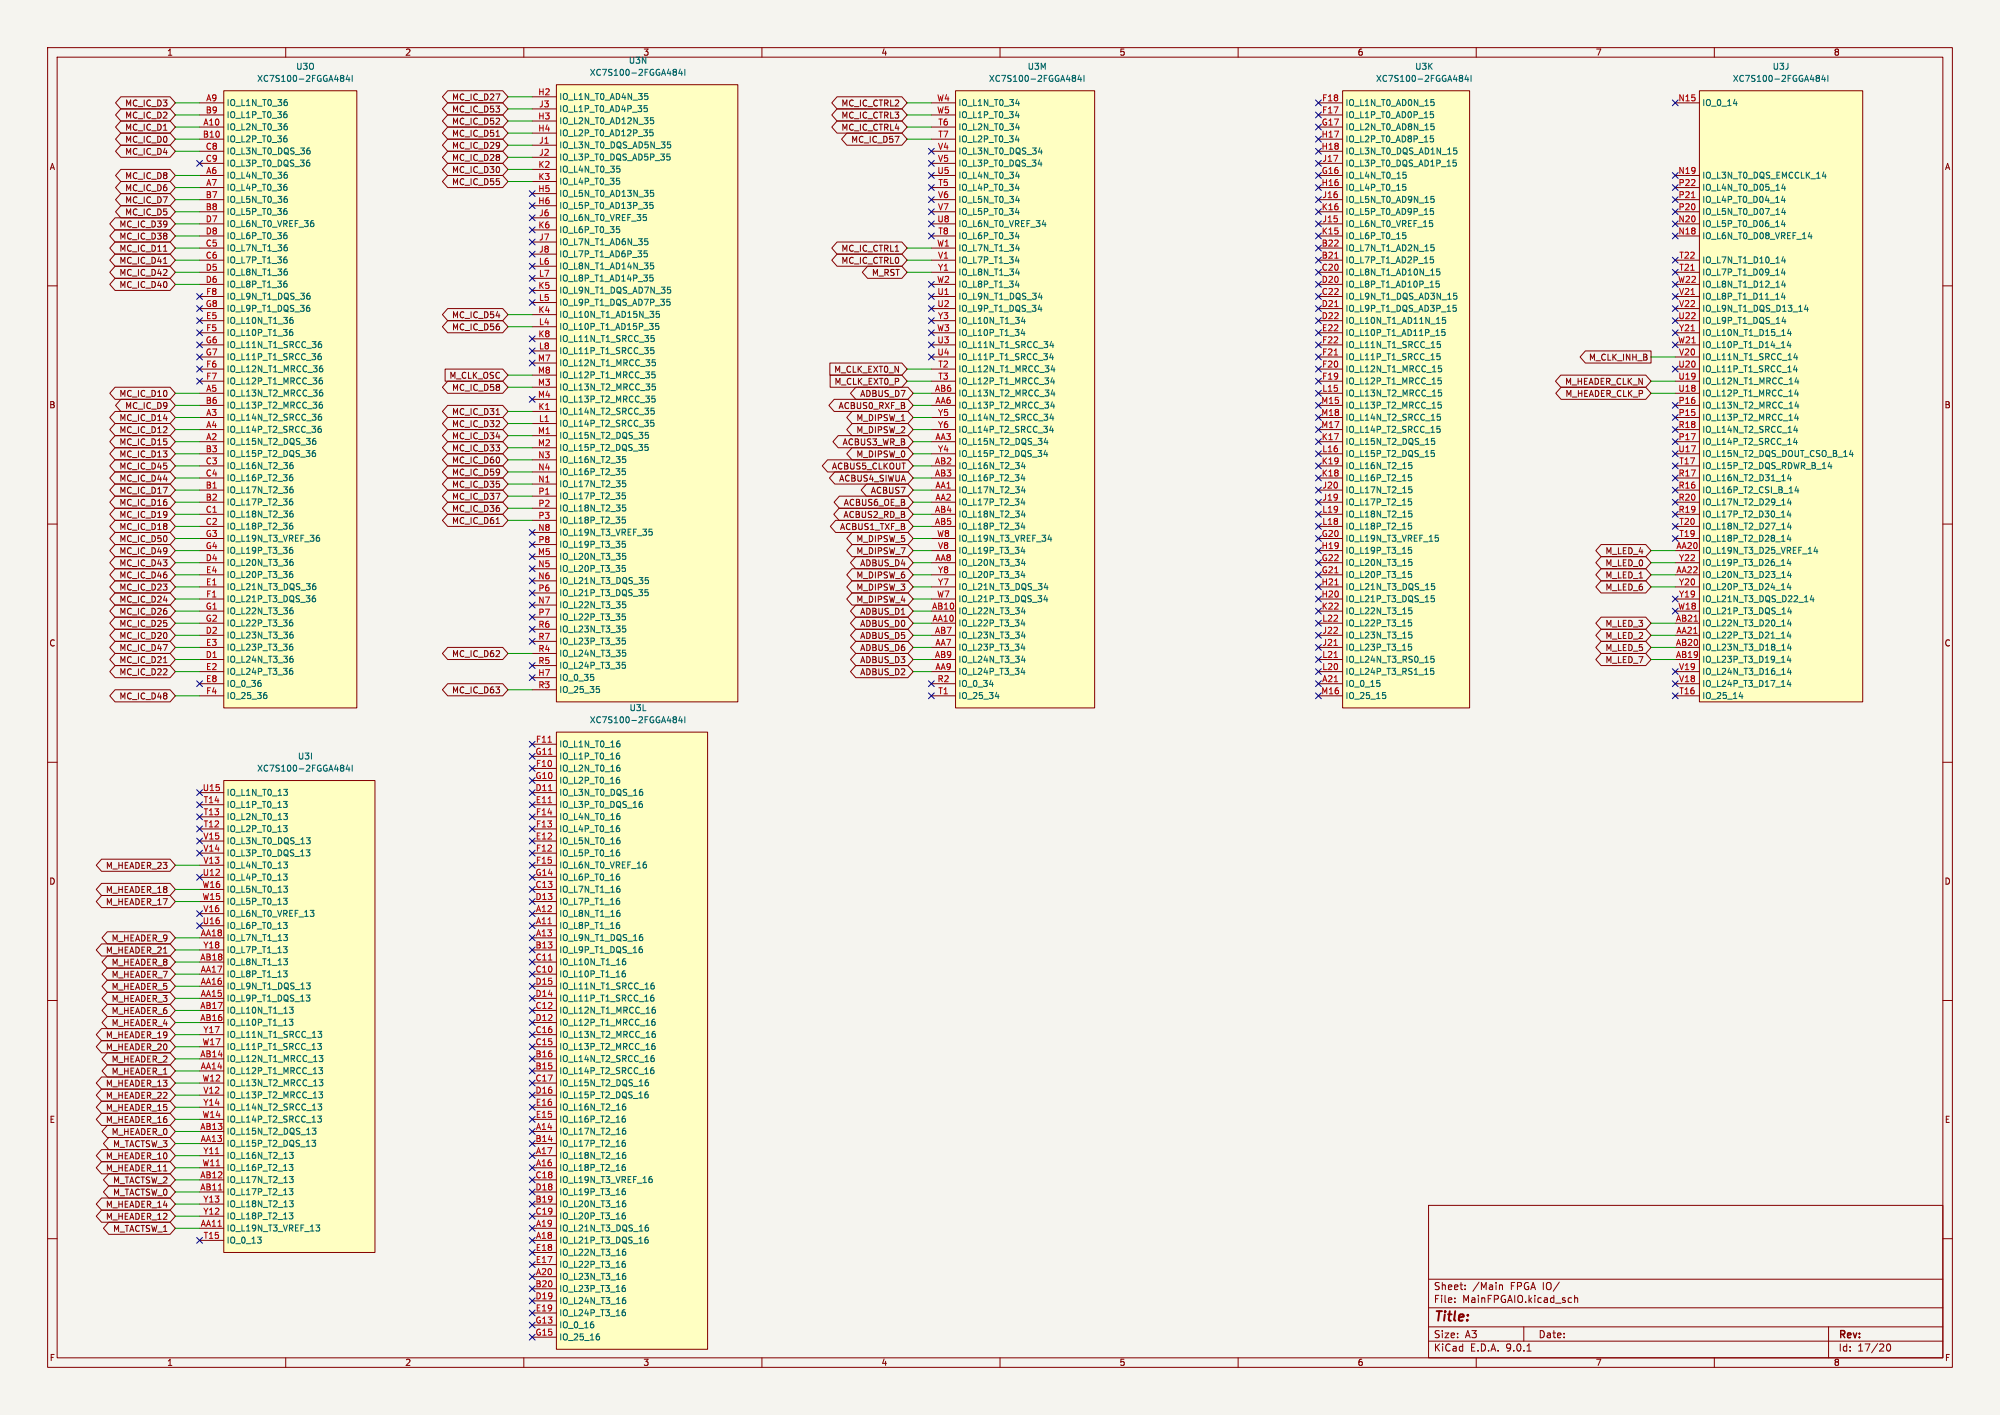
[picture p21: page 17]

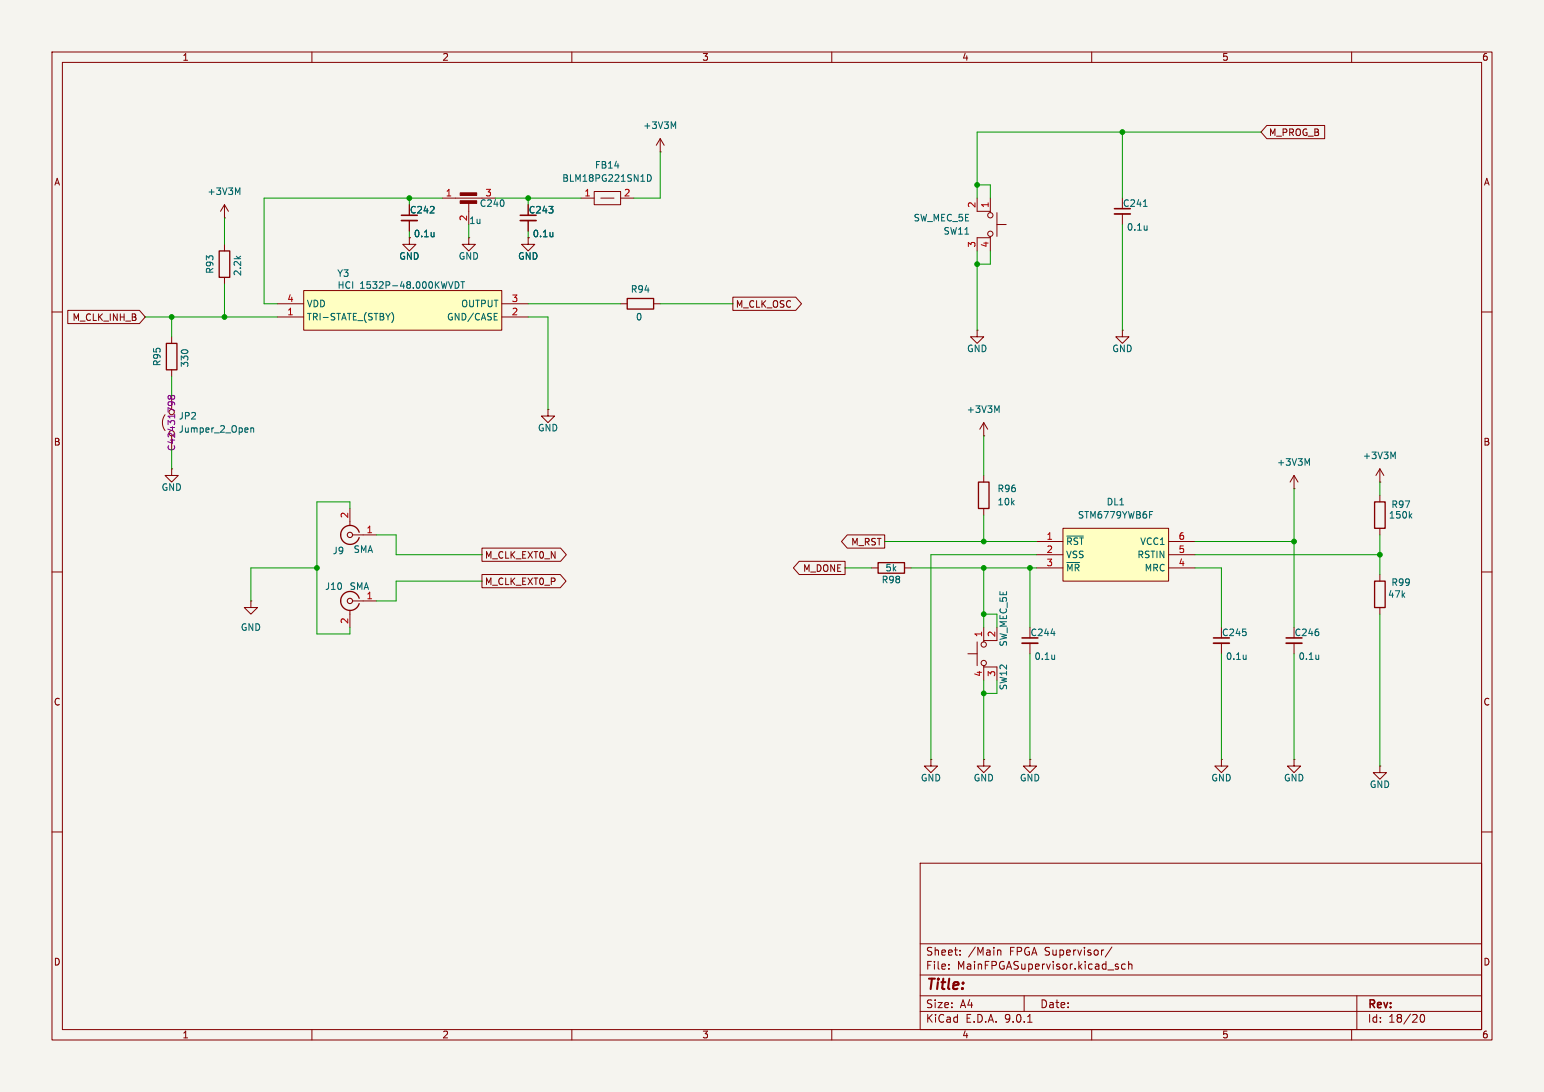
[picture p22: page 18]

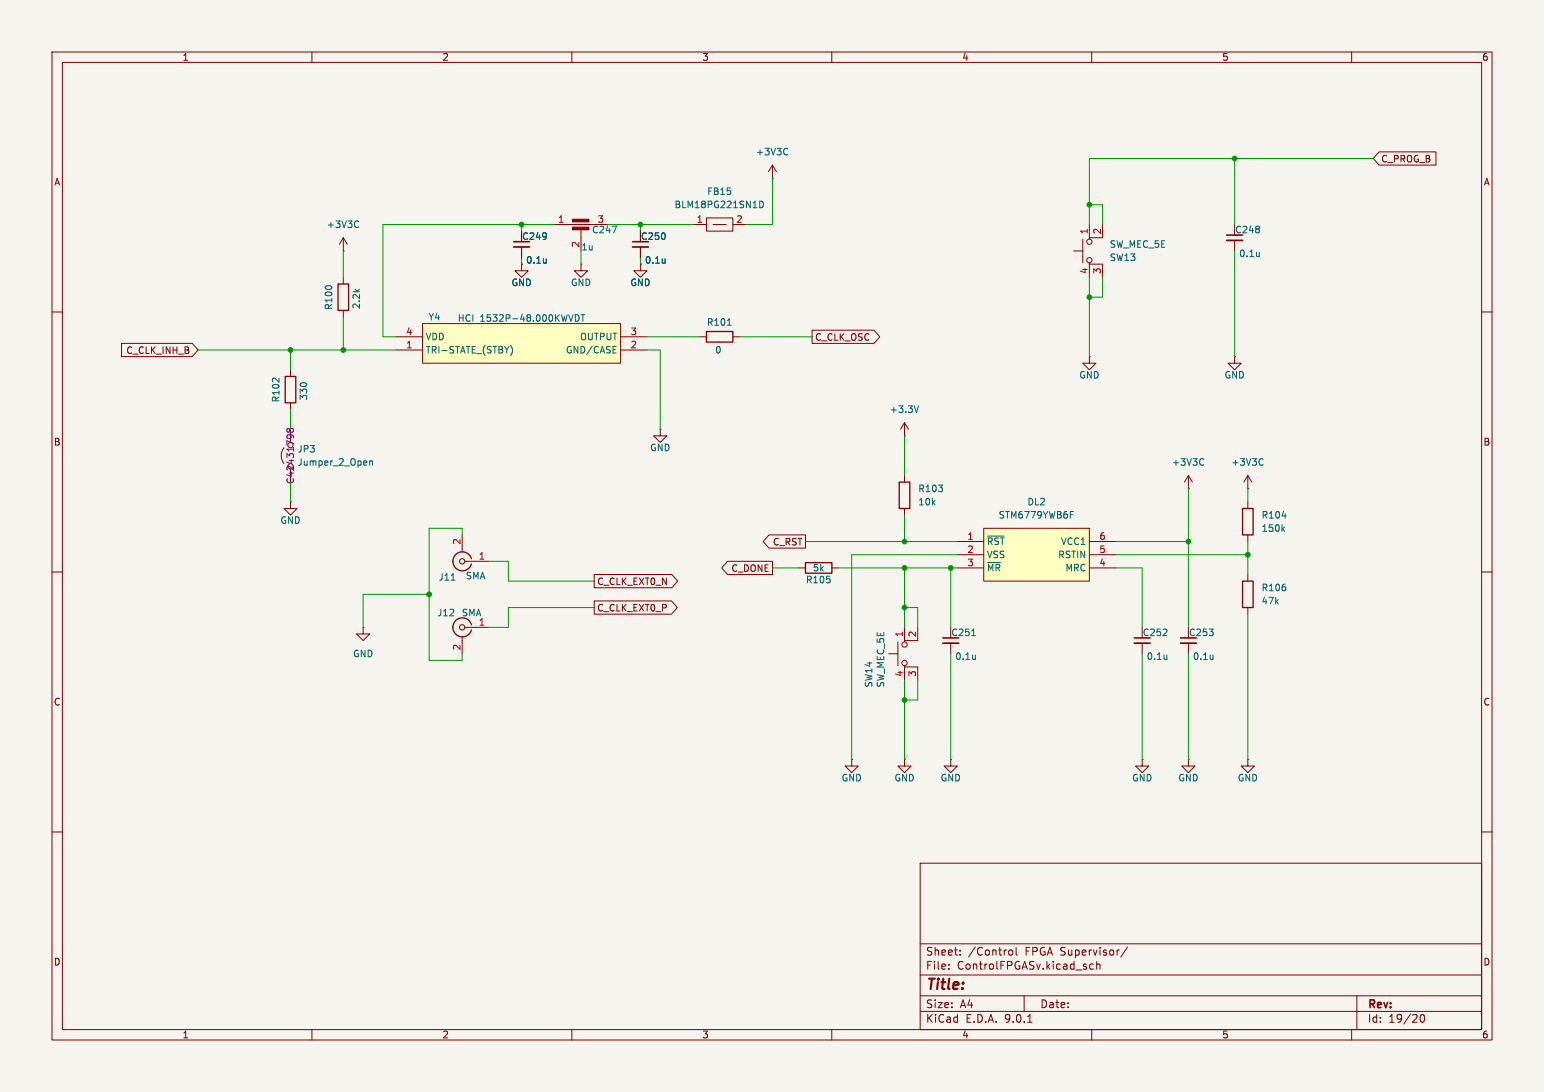
[picture p23: page 19]

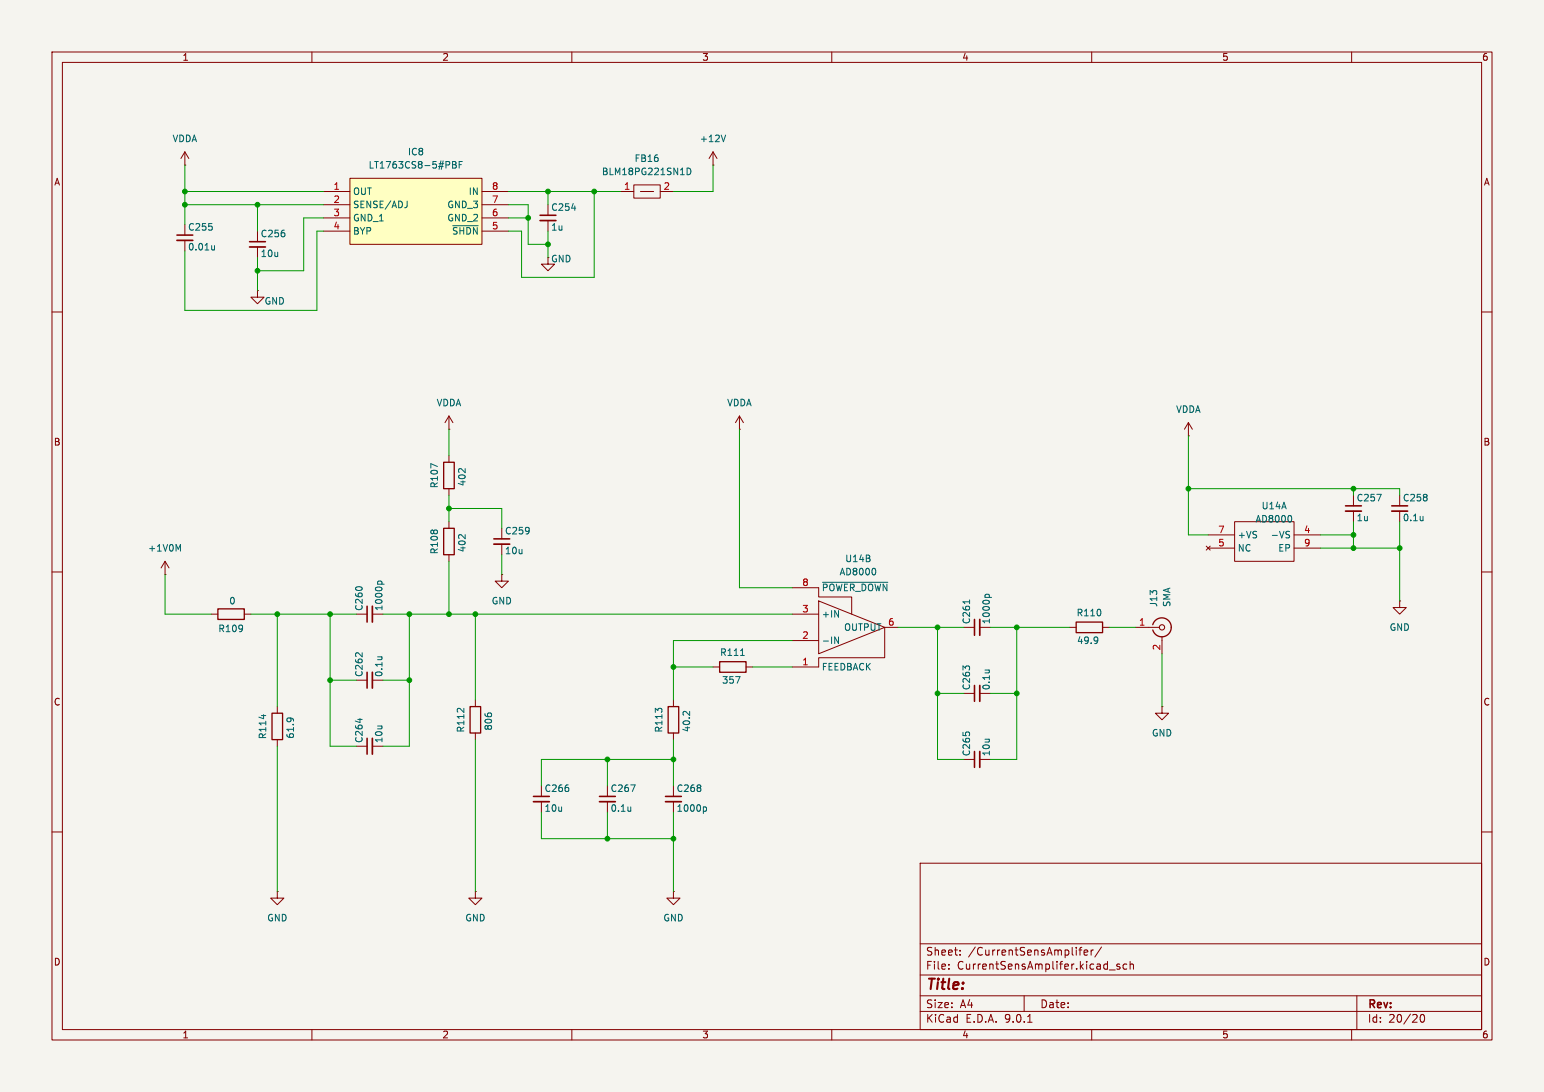
[picture p24: page 20]

Id: 20/20 Title: File: CurrentSensAmplifer.kicad_sch Sheet: /CurrentSensAmplifer/ C268
