SHAMIKO-project/SHAMIKO-board/docs/manual/images/Peripheral.pdf

# FPGA

# LED

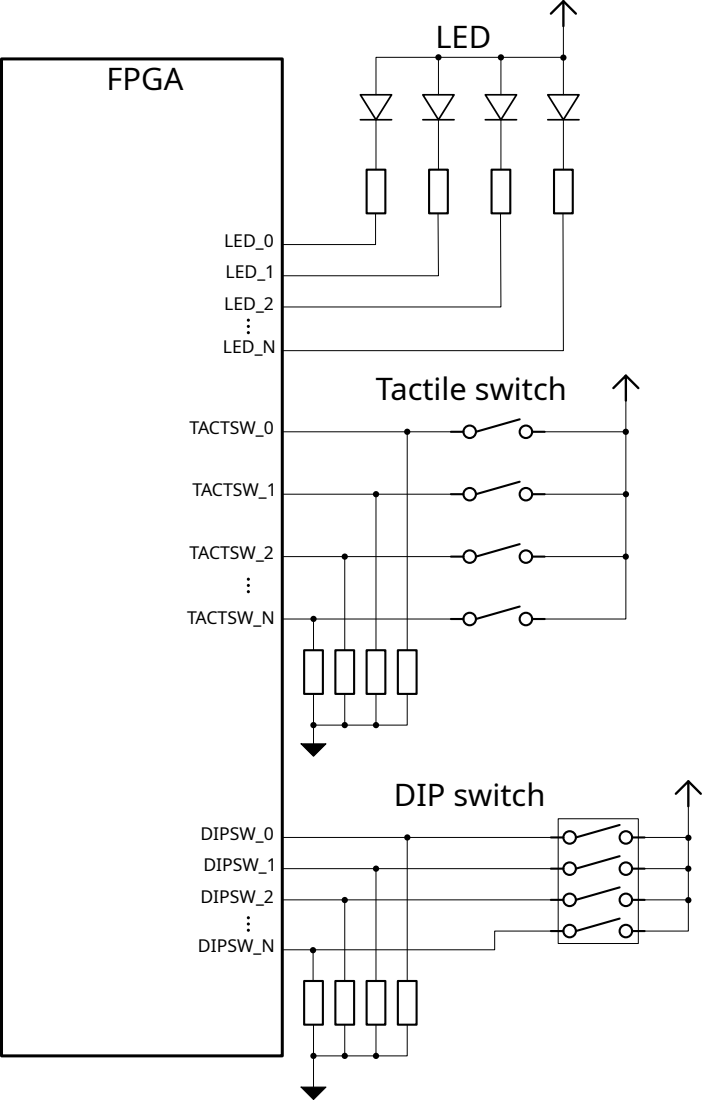
[picture p25: page 1]
TACTSW_0; TACTSW_1; TACTSW_2; TACTSW_N; DIPSW_0 DIPSW_1 DIPSW_2; DIPSW_N; LED_0 LED_1 LED_2; LED_N; Tactile switch; DIP switch
