SHAMIKO-project/SHAMIKO-board/docs/manual/images/Power.pdf

## DC/DC

## LDO

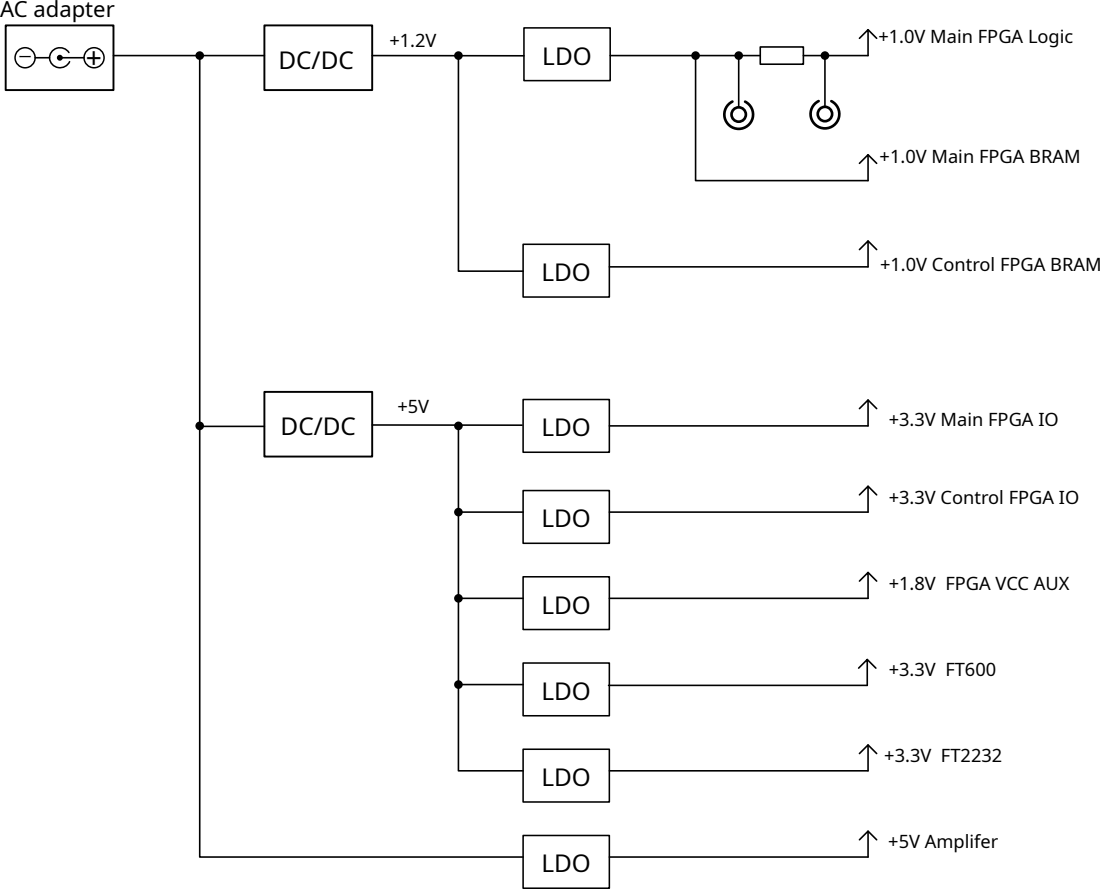
[picture p26: page 1]
AC adapter; LDO; +1.0V Main FPGA Logic; +5V Amplifer

+1.0V Main FPGA BRAM

+1.0V Control FPGA BRAM

+3.3V Main FPGA IO

+3.3V Control FPGA IO

+1.8V FPGA VCC AUX
