SHAMIKO-project/SHAMIKO-board/docs/manual/images/config.pdf

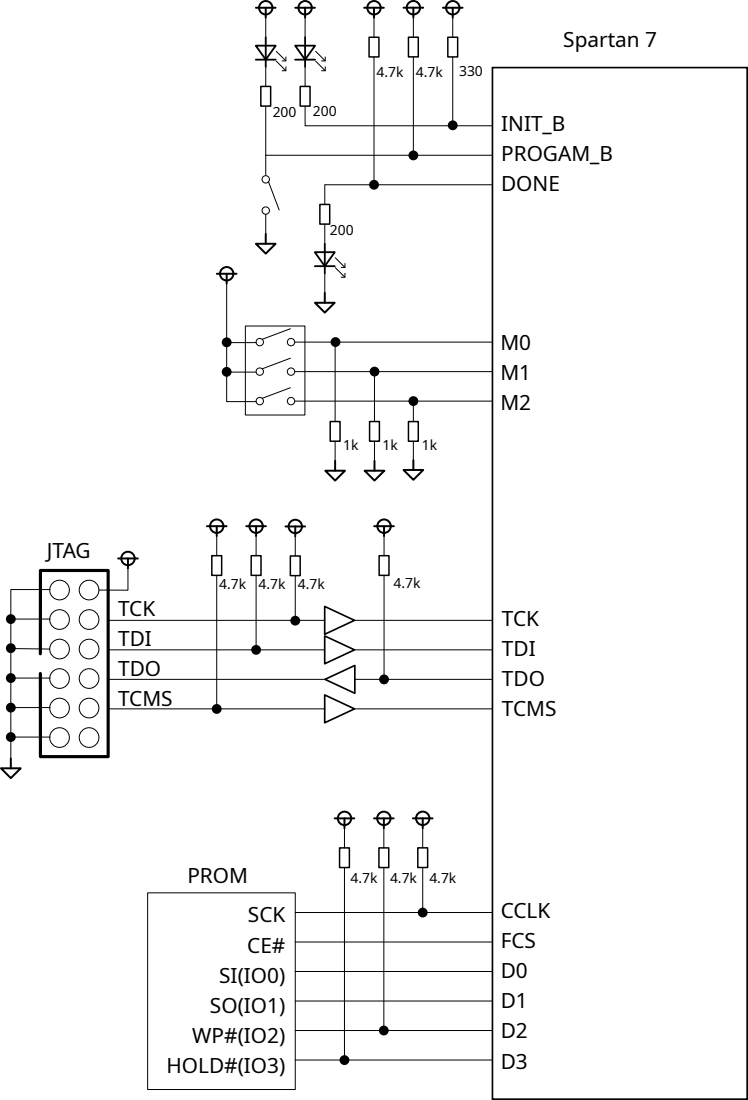
[picture p27: page 1]
INIT_B PROGAM_B DONE; TCK TDI TDO TCMS; CCLK FCS D0 D1 D2 D3; SCK CE# SI(IO0) SO(IO1) WP#(IO2) HOLD#(IO3); JTAG; Spartan 7; PROM
