SHAMIKO-project/SHAMIKO-board/docs/manual/images/Pinheader.pdf

Controller FPGA | Main FPGA

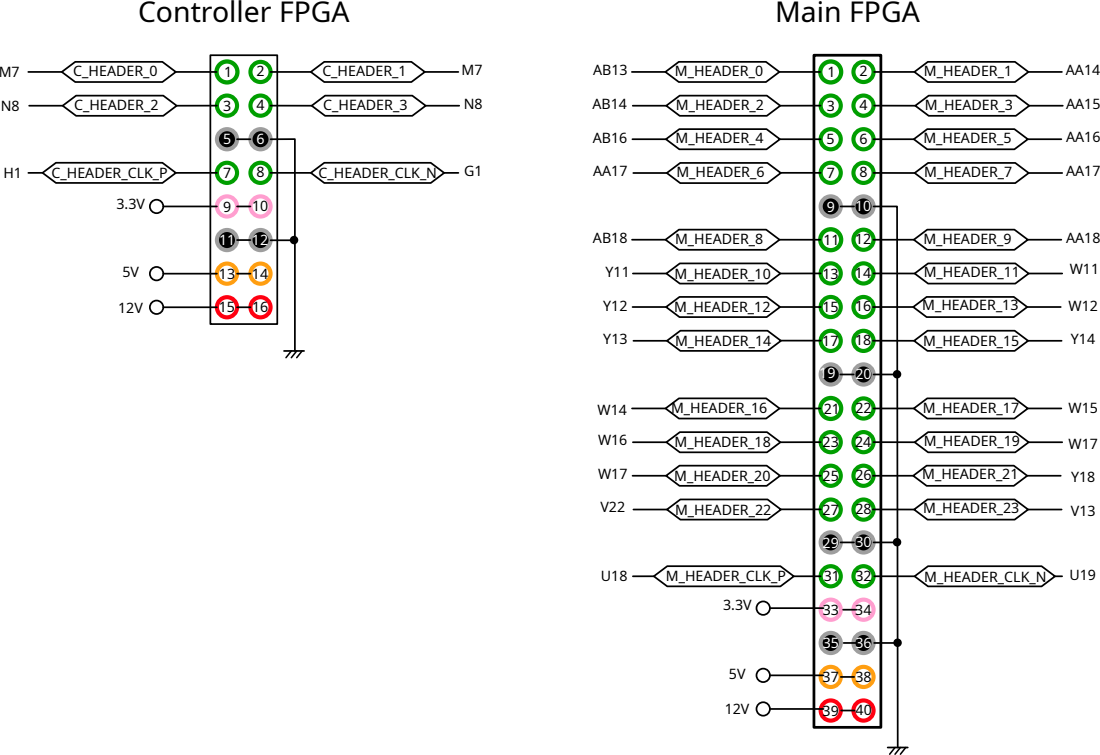
[picture p28: page 1]
C_HEADER_0; C_HEADER_2; C_HEADER_1; C_HEADER_3; C_HEADER_CLK_P; C_HEADER_CLK_N; M_HEADER_0; M_HEADER_2; M_HEADER_1; M_HEADER_3; M_HEADER_5; M_HEADER_7; M_HEADER_9; M_HEADER_11; M_HEADER_13; M_HEADER_15; M_HEADER_4; M_HEADER_6; M_HEADER_8; M_HEADER_10; M_HEADER_12; M_HEADER_14; M_HEADER_17; M_HEADER_19; M_HEADER_21; M_HEADER_23; M_HEADER_16; M_HEADER_18; M_HEADER_20; M_HEADER_22; M_HEADER_CLK_P; M_HEADER_CLK_N U19
