SHAMIKO-project/SHAMIKO-board/docs/manual/images/PowerMeasure.pdf

0Ω

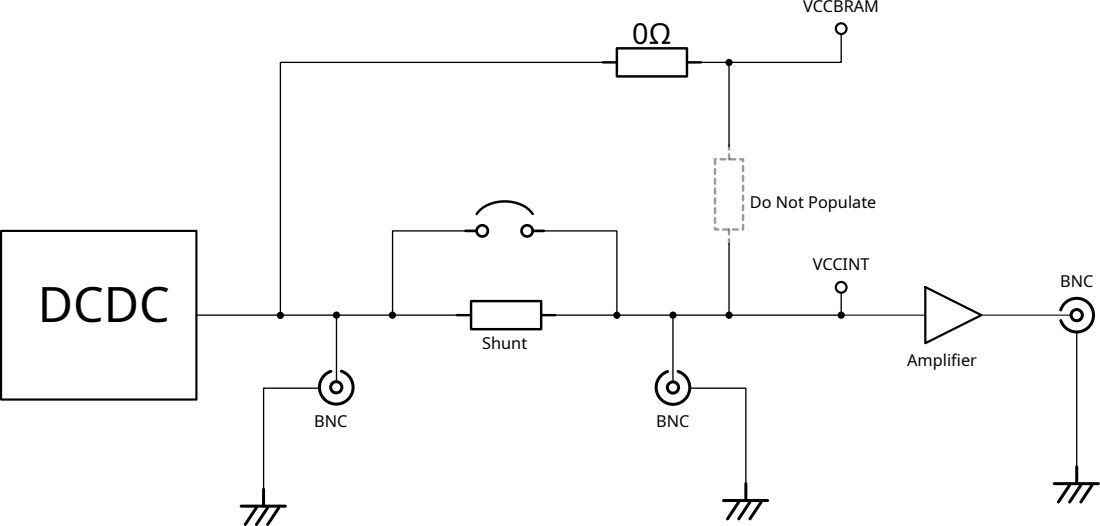
[picture p29: page 1]
DCDC; VCCBRAM; VCCINT; Amplifier; Shunt; BNC

Do Not Populate
