SHAMIKO-project/SHAMIKO-board/hardware/shamiko.kicad_pcb

## KiCad design hardware/shamiko.kicad_pcb (2026-10-07)

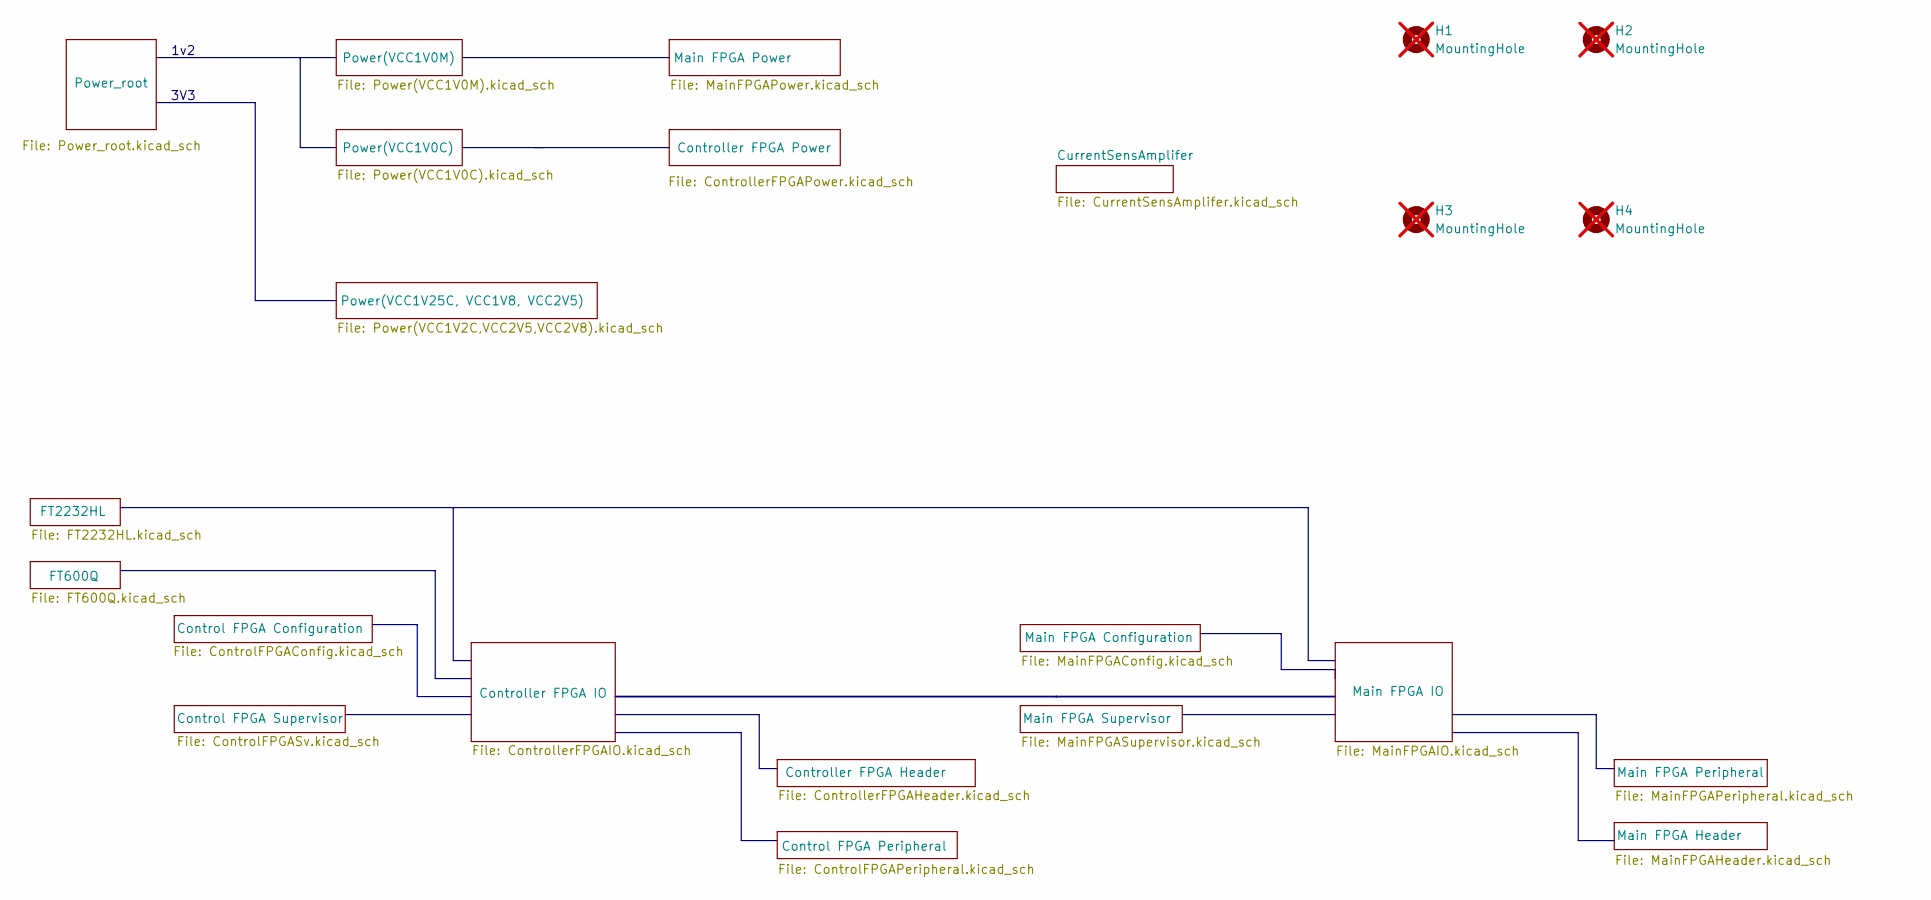
[picture p30: schematic shamiko.kicad_sch]

Parts:
H1, H2, H3, H4: MountingHole; MountingHole_3.2mm_M3; not fitted

Notes on the sheet:
3V3
1v2

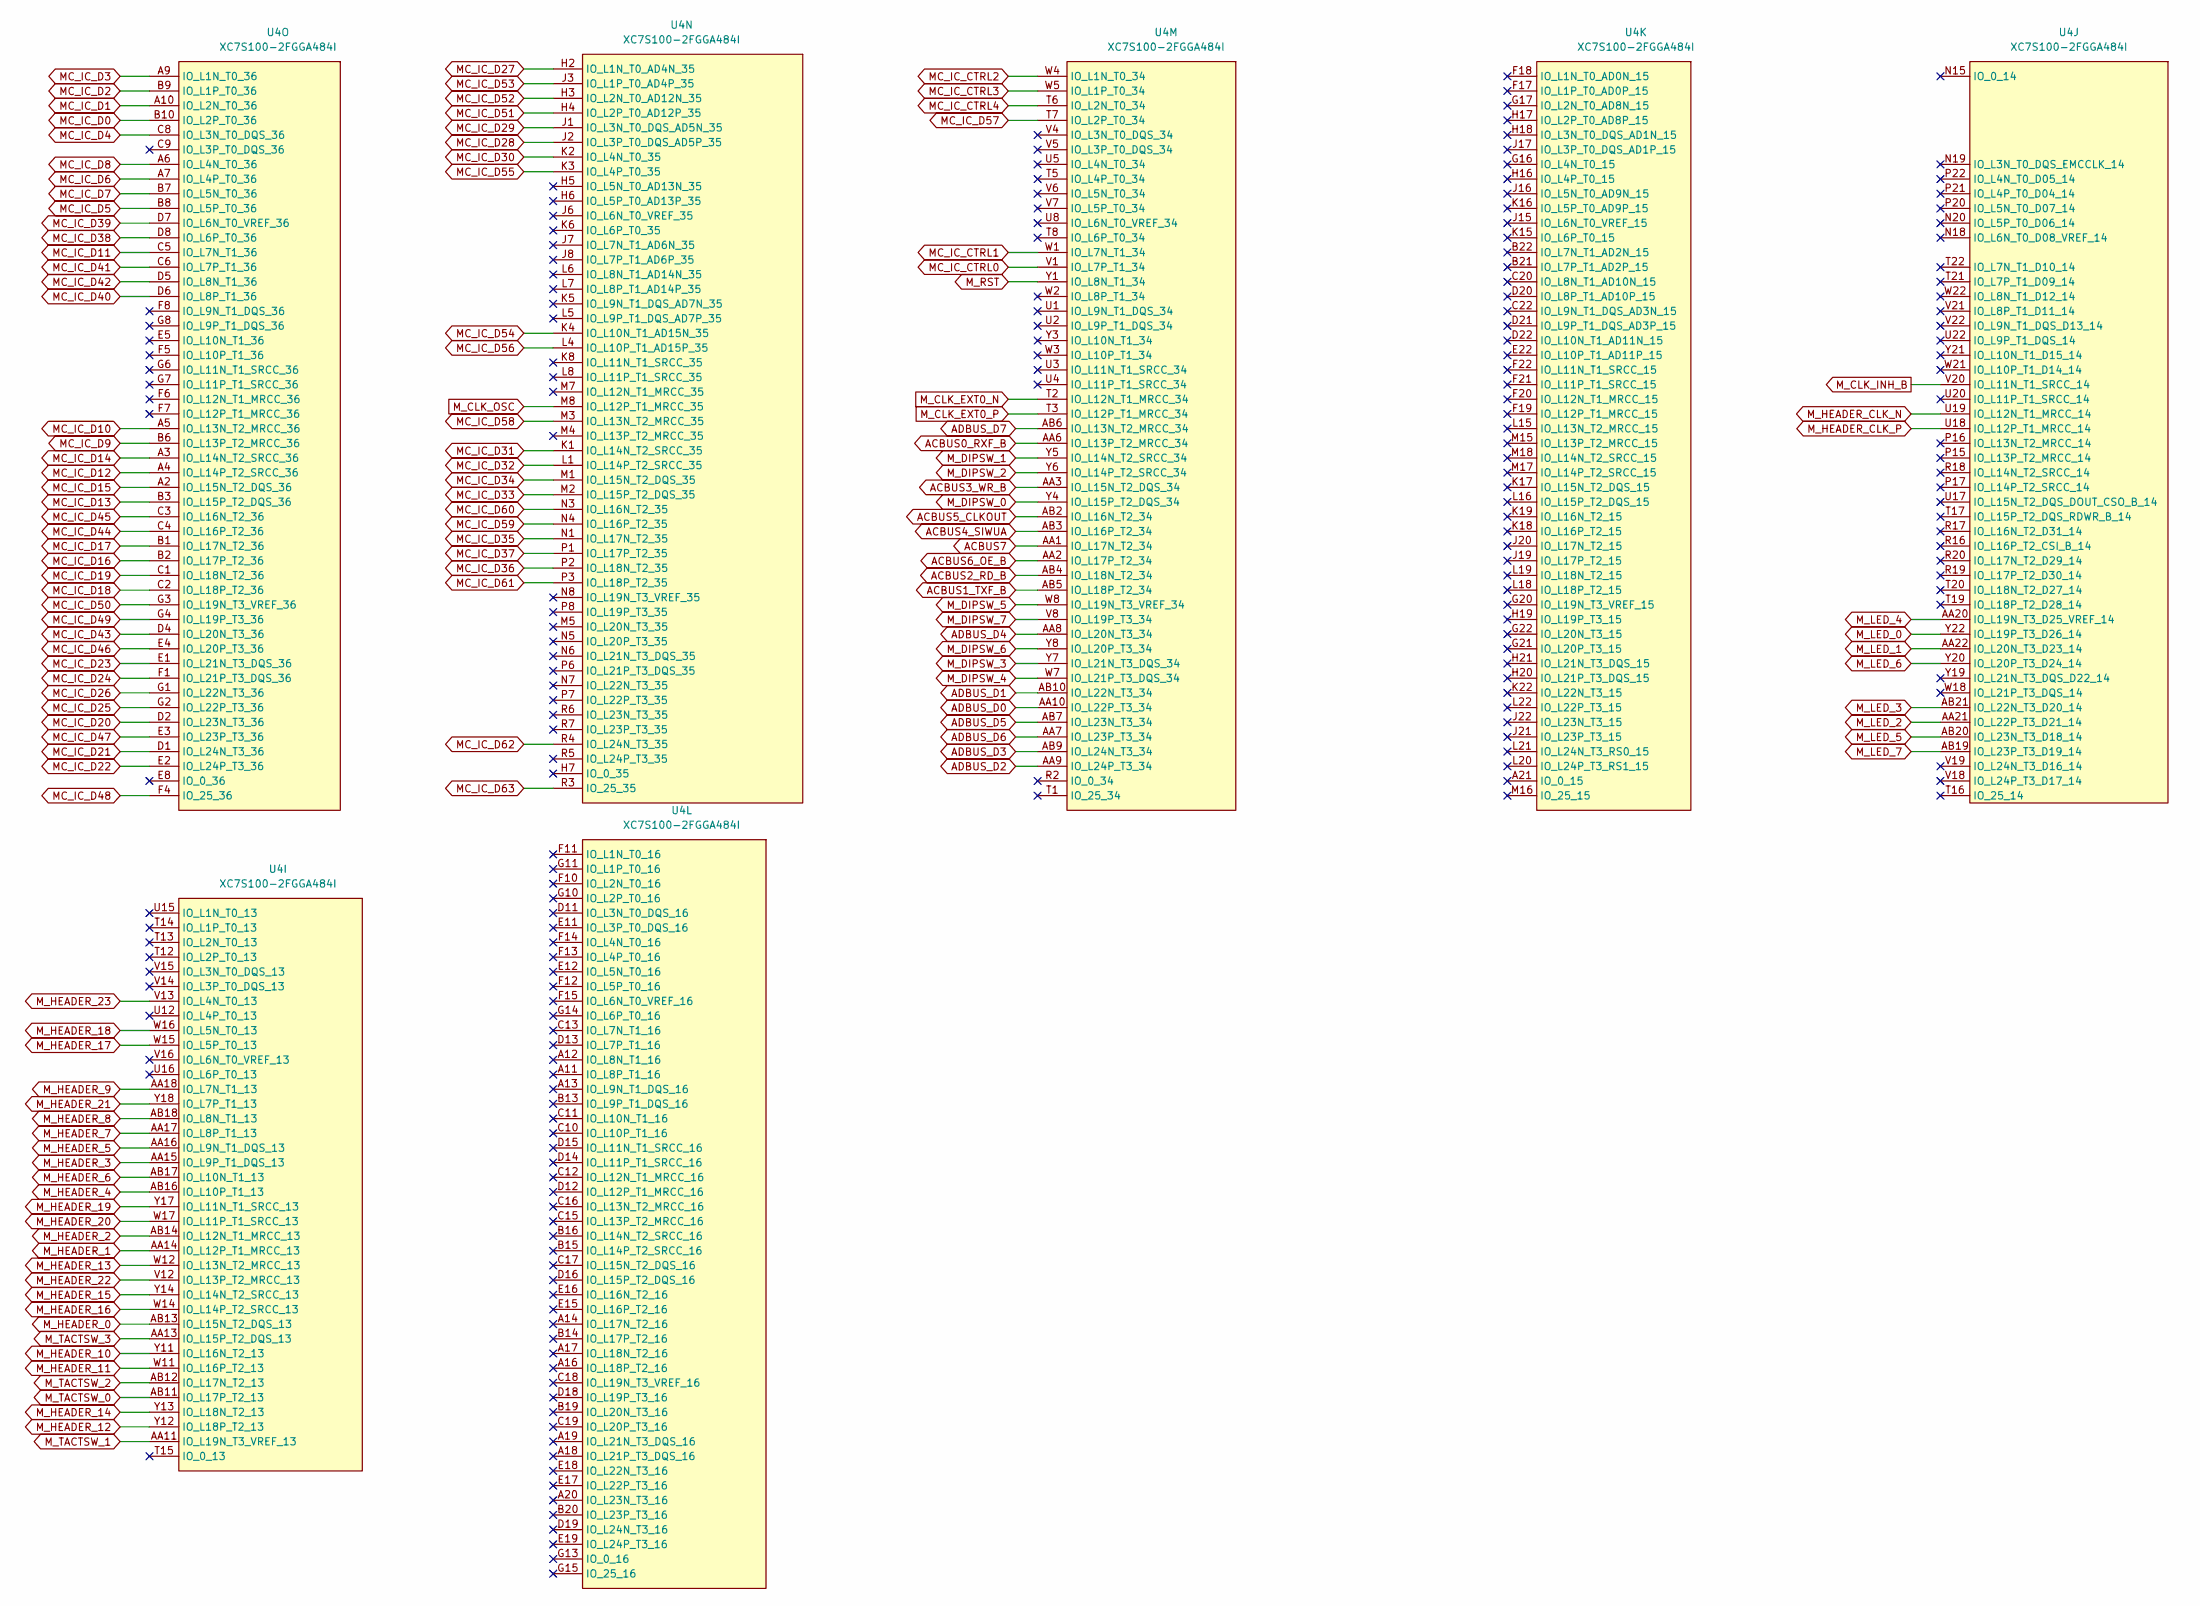
[picture p31: schematic MainFPGAIO.kicad_sch]

Parts:
U4: XC7S100-2FGGA484I; Xilinx_FBG484; LCSC C1521770

Connections:
ACBUS0_RXF_B: U4.AA6 (IO_L13P_T2_MRCC_34); also elsewhere on the board
ACBUS1_TXF_B: U4.AB5 (IO_L18P_T2_34); also elsewhere on the board
ACBUS2_RD_B: U4.AB4 (IO_L18N_T2_34); also elsewhere on the board
ACBUS3_WR_B: U4.AA3 (IO_L15N_T2_DQS_34); also elsewhere on the board
ACBUS4_SIWUA: U4.AB3 (IO_L16P_T2_34); also elsewhere on the board
ACBUS5_CLKOUT: U4.AB2 (IO_L16N_T2_34); also elsewhere on the board
ACBUS6_OE_B: U4.AA2 (IO_L17P_T2_34); also elsewhere on the board
ACBUS7: U4.AA1 (IO_L17N_T2_34); also elsewhere on the board
ADBUS_D0: U4.AA10 (IO_L22P_T3_34); also elsewhere on the board
ADBUS_D1: U4.AB10 (IO_L22N_T3_34); also elsewhere on the board
ADBUS_D2: U4.AA9 (IO_L24P_T3_34); also elsewhere on the board
ADBUS_D3: U4.AB9 (IO_L24N_T3_34); also elsewhere on the board
ADBUS_D4: U4.AA8 (IO_L20N_T3_34); also elsewhere on the board
ADBUS_D5: U4.AB7 (IO_L23N_T3_34); also elsewhere on the board
ADBUS_D6: U4.AA7 (IO_L23P_T3_34); also elsewhere on the board
ADBUS_D7: U4.AB6 (IO_L13N_T2_MRCC_34); also elsewhere on the board
MC_IC_CTRL0: U4.V1 (IO_L7P_T1_34); also elsewhere on the board
MC_IC_CTRL1: U4.W1 (IO_L7N_T1_34); also elsewhere on the board
MC_IC_CTRL2: U4.W4 (IO_L1N_T0_34); also elsewhere on the board
MC_IC_CTRL3: U4.W5 (IO_L1P_T0_34); also elsewhere on the board
MC_IC_CTRL4: U4.T6 (IO_L2N_T0_34); also elsewhere on the board
MC_IC_D0: U4.B10 (IO_L2P_T0_36); also elsewhere on the board
MC_IC_D1: U4.A10 (IO_L2N_T0_36); also elsewhere on the board
MC_IC_D2: U4.B9 (IO_L1P_T0_36); also elsewhere on the board
MC_IC_D3: U4.A9 (IO_L1N_T0_36); also elsewhere on the board
MC_IC_D4: U4.C8 (IO_L3N_T0_DQS_36); also elsewhere on the board
MC_IC_D5: U4.B8 (IO_L5P_T0_36); also elsewhere on the board
MC_IC_D6: U4.A7 (IO_L4P_T0_36); also elsewhere on the board
MC_IC_D7: U4.B7 (IO_L5N_T0_36); also elsewhere on the board
MC_IC_D8: U4.A6 (IO_L4N_T0_36); also elsewhere on the board
MC_IC_D9: U4.B6 (IO_L13P_T2_MRCC_36); also elsewhere on the board
MC_IC_D10: U4.A5 (IO_L13N_T2_MRCC_36); also elsewhere on the board
MC_IC_D11: U4.C5 (IO_L7N_T1_36); also elsewhere on the board
MC_IC_D12: U4.A4 (IO_L14P_T2_SRCC_36); also elsewhere on the board
MC_IC_D13: U4.B3 (IO_L15P_T2_DQS_36); also elsewhere on the board
MC_IC_D14: U4.A3 (IO_L14N_T2_SRCC_36); also elsewhere on the board
MC_IC_D15: U4.A2 (IO_L15N_T2_DQS_36); also elsewhere on the board
MC_IC_D16: U4.B2 (IO_L17P_T2_36); also elsewhere on the board
MC_IC_D17: U4.B1 (IO_L17N_T2_36); also elsewhere on the board
MC_IC_D18: U4.C2 (IO_L18P_T2_36); also elsewhere on the board
MC_IC_D19: U4.C1 (IO_L18N_T2_36); also elsewhere on the board
MC_IC_D20: U4.D2 (IO_L23N_T3_36); also elsewhere on the board
MC_IC_D21: U4.D1 (IO_L24N_T3_36); also elsewhere on the board
MC_IC_D22: U4.E2 (IO_L24P_T3_36); also elsewhere on the board
MC_IC_D23: U4.E1 (IO_L21N_T3_DQS_36); also elsewhere on the board
MC_IC_D24: U4.F1 (IO_L21P_T3_DQS_36); also elsewhere on the board
MC_IC_D25: U4.G2 (IO_L22P_T3_36); also elsewhere on the board
MC_IC_D26: U4.G1 (IO_L22N_T3_36); also elsewhere on the board
MC_IC_D27: U4.H2 (IO_L1N_T0_AD4N_35); also elsewhere on the board
MC_IC_D28: U4.J2 (IO_L3P_T0_DQS_AD5P_35); also elsewhere on the board
MC_IC_D29: U4.J1 (IO_L3N_T0_DQS_AD5N_35); also elsewhere on the board
MC_IC_D30: U4.K2 (IO_L4N_T0_35); also elsewhere on the board
MC_IC_D31: U4.K1 (IO_L14N_T2_SRCC_35); also elsewhere on the board
MC_IC_D32: U4.L1 (IO_L14P_T2_SRCC_35); also elsewhere on the board
MC_IC_D33: U4.M2 (IO_L15P_T2_DQS_35); also elsewhere on the board
MC_IC_D34: U4.M1 (IO_L15N_T2_DQS_35); also elsewhere on the board
MC_IC_D35: U4.N1 (IO_L17N_T2_35); also elsewhere on the board
MC_IC_D36: U4.P2 (IO_L18N_T2_35); also elsewhere on the board
MC_IC_D37: U4.P1 (IO_L17P_T2_35); also elsewhere on the board
MC_IC_D38: U4.D8 (IO_L6P_T0_36); also elsewhere on the board
MC_IC_D39: U4.D7 (IO_L6N_T0_VREF_36); also elsewhere on the board
MC_IC_D40: U4.D6 (IO_L8P_T1_36); also elsewhere on the board
MC_IC_D41: U4.C6 (IO_L7P_T1_36); also elsewhere on the board
MC_IC_D42: U4.D5 (IO_L8N_T1_36); also elsewhere on the board
MC_IC_D43: U4.D4 (IO_L20N_T3_36); also elsewhere on the board
MC_IC_D44: U4.C4 (IO_L16P_T2_36); also elsewhere on the board
MC_IC_D45: U4.C3 (IO_L16N_T2_36); also elsewhere on the board
MC_IC_D46: U4.E4 (IO_L20P_T3_36); also elsewhere on the board
MC_IC_D47: U4.E3 (IO_L23P_T3_36); also elsewhere on the board
MC_IC_D48: U4.F4 (IO_25_36); also elsewhere on the board
MC_IC_D49: U4.G4 (IO_L19P_T3_36); also elsewhere on the board
MC_IC_D50: U4.G3 (IO_L19N_T3_VREF_36); also elsewhere on the board
MC_IC_D51: U4.H4 (IO_L2P_T0_AD12P_35); also elsewhere on the board
MC_IC_D52: U4.H3 (IO_L2N_T0_AD12N_35); also elsewhere on the board
MC_IC_D53: U4.J3 (IO_L1P_T0_AD4P_35); also elsewhere on the board
MC_IC_D54: U4.K4 (IO_L10N_T1_AD15N_35); also elsewhere on the board
MC_IC_D55: U4.K3 (IO_L4P_T0_35); also elsewhere on the board
MC_IC_D56: U4.L4 (IO_L10P_T1_AD15P_35); also elsewhere on the board
MC_IC_D57: U4.T7 (IO_L2P_T0_34); also elsewhere on the board
MC_IC_D58: U4.M3 (IO_L13N_T2_MRCC_35); also elsewhere on the board
MC_IC_D59: U4.N4 (IO_L16P_T2_35); also elsewhere on the board
MC_IC_D60: U4.N3 (IO_L16N_T2_35); also elsewhere on the board
MC_IC_D61: U4.P3 (IO_L18P_T2_35); also elsewhere on the board
MC_IC_D62: U4.R4 (IO_L24N_T3_35); also elsewhere on the board
MC_IC_D63: U4.R3 (IO_25_35); also elsewhere on the board
M_CLK_EXT0_N: U4.T2 (IO_L12N_T1_MRCC_34); also elsewhere on the board
M_CLK_EXT0_P: U4.T3 (IO_L12P_T1_MRCC_34); also elsewhere on the board
M_CLK_INH_B: U4.V20 (IO_L11N_T1_SRCC_14); also elsewhere on the board
M_CLK_OSC: U4.M8 (IO_L12P_T1_MRCC_35); also elsewhere on the board
M_DIPSW_0: U4.Y4 (IO_L15P_T2_DQS_34); also elsewhere on the board
M_DIPSW_1: U4.Y5 (IO_L14N_T2_SRCC_34); also elsewhere on the board
M_DIPSW_2: U4.Y6 (IO_L14P_T2_SRCC_34); also elsewhere on the board
M_DIPSW_3: U4.Y7 (IO_L21N_T3_DQS_34); also elsewhere on the board
M_DIPSW_4: U4.W7 (IO_L21P_T3_DQS_34); also elsewhere on the board
M_DIPSW_5: U4.W8 (IO_L19N_T3_VREF_34); also elsewhere on the board
M_DIPSW_6: U4.Y8 (IO_L20P_T3_34); also elsewhere on the board
M_DIPSW_7: U4.V8 (IO_L19P_T3_34); also elsewhere on the board
M_HEADER_0: U4.AB13 (IO_L15N_T2_DQS_13); also elsewhere on the board
M_HEADER_1: U4.AA14 (IO_L12P_T1_MRCC_13); also elsewhere on the board
M_HEADER_2: U4.AB14 (IO_L12N_T1_MRCC_13); also elsewhere on the board
M_HEADER_3: U4.AA15 (IO_L9P_T1_DQS_13); also elsewhere on the board
M_HEADER_4: U4.AB16 (IO_L10P_T1_13); also elsewhere on the board
M_HEADER_5: U4.AA16 (IO_L9N_T1_DQS_13); also elsewhere on the board
M_HEADER_6: U4.AB17 (IO_L10N_T1_13); also elsewhere on the board
M_HEADER_7: U4.AA17 (IO_L8P_T1_13); also elsewhere on the board
M_HEADER_8: U4.AB18 (IO_L8N_T1_13); also elsewhere on the board
M_HEADER_9: U4.AA18 (IO_L7N_T1_13); also elsewhere on the board
M_HEADER_10: U4.Y11 (IO_L16N_T2_13); also elsewhere on the board
M_HEADER_11: U4.W11 (IO_L16P_T2_13); also elsewhere on the board
M_HEADER_12: U4.Y12 (IO_L18P_T2_13); also elsewhere on the board
M_HEADER_13: U4.W12 (IO_L13N_T2_MRCC_13); also elsewhere on the board
M_HEADER_14: U4.Y13 (IO_L18N_T2_13); also elsewhere on the board
M_HEADER_15: U4.Y14 (IO_L14N_T2_SRCC_13); also elsewhere on the board
M_HEADER_16: U4.W14 (IO_L14P_T2_SRCC_13); also elsewhere on the board
M_HEADER_17: U4.W15 (IO_L5P_T0_13); also elsewhere on the board
M_HEADER_18: U4.W16 (IO_L5N_T0_13); also elsewhere on the board
M_HEADER_19: U4.Y17 (IO_L11N_T1_SRCC_13); also elsewhere on the board
M_HEADER_20: U4.W17 (IO_L11P_T1_SRCC_13); also elsewhere on the board
M_HEADER_21: U4.Y18 (IO_L7P_T1_13); also elsewhere on the board
M_HEADER_22: U4.V12 (IO_L13P_T2_MRCC_13); also elsewhere on the board
M_HEADER_23: U4.V13 (IO_L4N_T0_13); also elsewhere on the board
M_HEADER_CLK_N: U4.U19 (IO_L12N_T1_MRCC_14); also elsewhere on the board
M_HEADER_CLK_P: U4.U18 (IO_L12P_T1_MRCC_14); also elsewhere on the board
M_LED_0: U4.Y22 (IO_L19P_T3_D26_14); also elsewhere on the board
M_LED_1: U4.AA22 (IO_L20N_T3_D23_14); also elsewhere on the board
M_LED_2: U4.AA21 (IO_L22P_T3_D21_14); also elsewhere on the board
M_LED_3: U4.AB21 (IO_L22N_T3_D20_14); also elsewhere on the board
M_LED_4: U4.AA20 (IO_L19N_T3_D25_VREF_14); also elsewhere on the board
M_LED_5: U4.AB20 (IO_L23N_T3_D18_14); also elsewhere on the board
M_LED_6: U4.Y20 (IO_L20P_T3_D24_14); also elsewhere on the board
M_LED_7: U4.AB19 (IO_L23P_T3_D19_14); also elsewhere on the board
M_RST: U4.Y1 (IO_L8N_T1_34); also elsewhere on the board
M_TACTSW_0: U4.AB11 (IO_L17P_T2_13); also elsewhere on the board
M_TACTSW_1: U4.AA11 (IO_L19N_T3_VREF_13); also elsewhere on the board
M_TACTSW_2: U4.AB12 (IO_L17N_T2_13); also elsewhere on the board
M_TACTSW_3: U4.AA13 (IO_L15P_T2_DQS_13); also elsewhere on the board

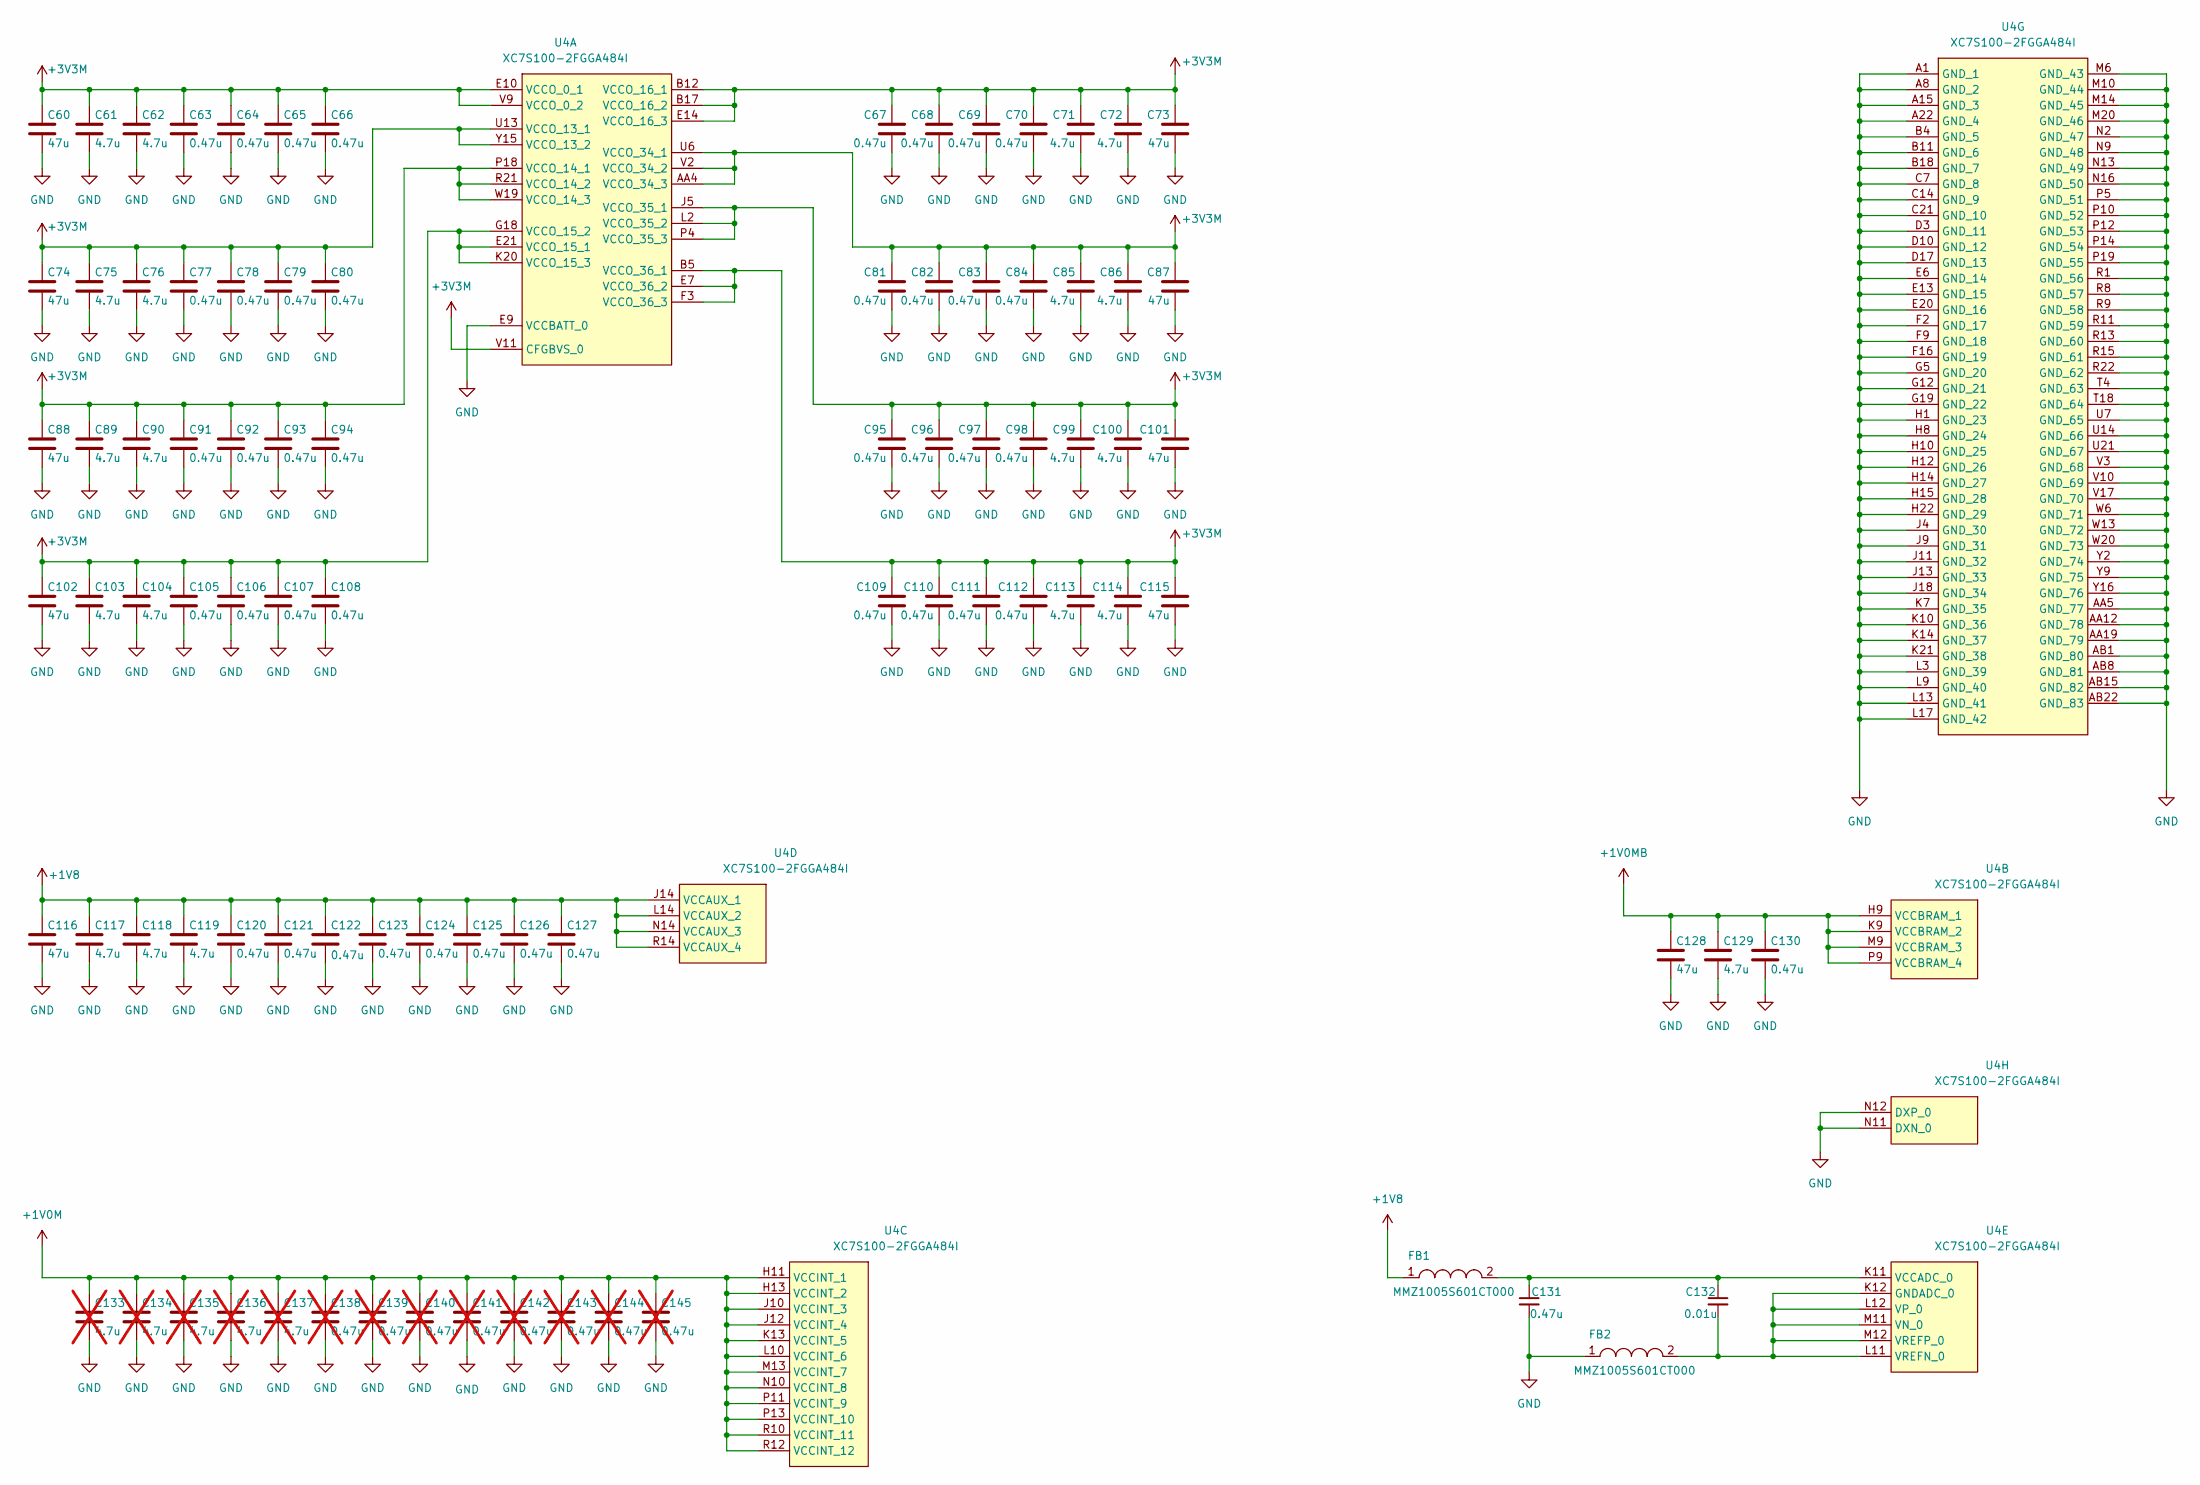
[picture p32: schematic MainFPGAPower.kicad_sch]

Parts:
C60, C73, C74, C87, C88, C101, C102, C115, C116, C128: 47u; C_0805_2012Metric; LCSC C124129
C61, C62, C71, C72, C75, C76, C85, C86, C89, C90, C99, C100, C103, C104, C113, C114, C117, C118, C119, C129: 4.7u; C_0603_1608Metric; LCSC C90057
C63, C64, C65, C66, C67, C68, C69, C70, C77, C78, C79, C80, C81, C82, C83, C84, C91, C92, C93, C94, C95, C96, C97, C98, C105, C106, C107, C108, C130, C131: 0.47u; C_0402_1005Metric; LCSC C77003
C109, C110, C111, C112, C120, C121, C122, C123, C124, C125, C126, C127: 0.47u; C_0402_1005Metric_Pad0.74x0.62mm_HandSolder; LCSC C77003
C132: 0.01u; C_0402_1005Metric; LCSC C15195
C133, C134, C135, C136, C137: 4.7u; C_0603_1608Metric_Pad1.08x0.95mm_HandSolder; LCSC C90057; not fitted
C138, C139, C140, C141, C142, C143, C144, C145: 0.47u; C_0402_1005Metric_Pad0.74x0.62mm_HandSolder; LCSC C77003; not fitted
FB1, FB2: MMZ1005S601CT000; LCSC C76804
U4: XC7S100-2FGGA484I; Xilinx_FBG484; LCSC C1521770

Connections:
+1V0M: C133.1, C134.1, C135.1, C136.1, C137.1, C138.1, C139.1, C140.1, C141.1, C142.1, C143.1, C144.1, C145.1, U4.H11 (VCCINT_1), U4.H13 (VCCINT_2), U4.J10 (VCCINT_3), U4.J12 (VCCINT_4), U4.K13 (VCCINT_5), U4.L10 (VCCINT_6), U4.M13 (VCCINT_7), U4.N10 (VCCINT_8), U4.P11 (VCCINT_9), U4.P13 (VCCINT_10), U4.R10 (VCCINT_11), U4.R12 (VCCINT_12); also elsewhere on the board
+1V0MB: C128.1, C129.1, C130.1, U4.H9 (VCCBRAM_1), U4.K9 (VCCBRAM_2), U4.M9 (VCCBRAM_3), U4.P9 (VCCBRAM_4); also elsewhere on the board
+1V8: C116.1, C117.1, C118.1, C119.1, C120.1, C121.1, C122.1, C123.1, C124.1, C125.1, C126.1, C127.1, FB1.1, U4.J14 (VCCAUX_1), U4.L14 (VCCAUX_2), U4.N14 (VCCAUX_3), U4.R14 (VCCAUX_4); also elsewhere on the board
+3V3M: C60.1, C61.1, C62.1, C63.1, C64.1, C65.1, C66.1, C67.1, C68.1, C69.1, C70.1, C71.1, C72.1, C73.1, C74.1, C75.1, C76.1, C77.1, C78.1, C79.1, C80.1, C81.1, C82.1, C83.1, C84.1, C85.1, C86.1, C87.1, C88.1, C89.1, C90.1, C91.1, C92.1, C93.1, C94.1, C95.1, C96.1, C97.1, C98.1, C99.1, C100.1, C101.1, C102.1, C103.1, C104.1, C105.1, C106.1, C107.1, C108.1, C109.1, C110.1, C111.1, C112.1, C113.1, C114.1, C115.1, U4.AA4 (VCCO_34_3), U4.B5 (VCCO_36_1), U4.B12 (VCCO_16_1), U4.B17 (VCCO_16_2), U4.E7 (VCCO_36_2), U4.E10 (VCCO_0_1), U4.E14 (VCCO_16_3), U4.E21 (VCCO_15_1), U4.F3 (VCCO_36_3), U4.G18 (VCCO_15_2), U4.J5 (VCCO_35_1), U4.K20 (VCCO_15_3), U4.L2 (VCCO_35_2), U4.P4 (VCCO_35_3), U4.P18 (VCCO_14_1), U4.R21 (VCCO_14_2), U4.U6 (VCCO_34_1), U4.U13 (VCCO_13_1), U4.V2 (VCCO_34_2), U4.V9 (VCCO_0_2), U4.V11 (CFGBVS_0), U4.W19 (VCCO_14_3), U4.Y15 (VCCO_13_2); also elsewhere on the board
GND: C60.2, C61.2, C62.2, C63.2, C64.2, C65.2, C66.2, C67.2, C68.2, C69.2, C70.2, C71.2, C72.2, C73.2, C74.2, C75.2, C76.2, C77.2, C78.2, C79.2, C80.2, C81.2, C82.2, C83.2, C84.2, C85.2, C86.2, C87.2, C88.2, C89.2, C90.2, C91.2, C92.2, C93.2, C94.2, C95.2, C96.2, C97.2, C98.2, C99.2, C100.2, C101.2, C102.2, C103.2, C104.2, C105.2, C106.2, C107.2, C108.2, C109.2, C110.2, C111.2, C112.2, C113.2, C114.2, C115.2, C116.2, C117.2, C118.2, C119.2, C120.2, C121.2, C122.2, C123.2, C124.2, C125.2, C126.2, C127.2, C128.2, C129.2, C130.2, C131.2, C133.2, C134.2, C135.2, C136.2, C137.2, C138.2, C139.2, C140.2, C141.2, C142.2, C143.2, C144.2, C145.2, FB2.1, U4.A1 (GND_1), U4.A8 (GND_2), U4.A15 (GND_3), U4.A22 (GND_4), U4.AA5 (GND_77), U4.AA12 (GND_78), U4.AA19 (GND_79), U4.AB1 (GND_80), U4.AB8 (GND_81), U4.AB15 (GND_82), U4.AB22 (GND_83), U4.B4 (GND_5), U4.B11 (GND_6), U4.B18 (GND_7), U4.C7 (GND_8), U4.C14 (GND_9), U4.C21 (GND_10), U4.D3 (GND_11), U4.D10 (GND_12), U4.D17 (GND_13), U4.E6 (GND_14), U4.E9 (VCCBATT_0), U4.E13 (GND_15), U4.E20 (GND_16), U4.F2 (GND_17), U4.F9 (GND_18), U4.F16 (GND_19), U4.G5 (GND_20), U4.G12 (GND_21), U4.G19 (GND_22), U4.H1 (GND_23), U4.H8 (GND_24), U4.H10 (GND_25), U4.H12 (GND_26), U4.H14 (GND_27), U4.H15 (GND_28), U4.H22 (GND_29), U4.J4 (GND_30), U4.J9 (GND_31), U4.J11 (GND_32), U4.J13 (GND_33), U4.J18 (GND_34), U4.K7 (GND_35), U4.K10 (GND_36), U4.K14 (GND_37), U4.K21 (GND_38), U4.L3 (GND_39), U4.L9 (GND_40), U4.L13 (GND_41), U4.L17 (GND_42), U4.M6 (GND_43), U4.M10 (GND_44), U4.M14 (GND_45), U4.M20 (GND_46), U4.N2 (GND_47), U4.N9 (GND_48), U4.N11 (DXN_0), U4.N12 (DXP_0), U4.N13 (GND_49), U4.N16 (GND_50), U4.P5 (GND_51), U4.P10 (GND_52), U4.P12 (GND_53), U4.P14 (GND_54), U4.P19 (GND_55), U4.R1 (GND_56), U4.R8 (GND_57), U4.R9 (GND_58), U4.R11 (GND_59), U4.R13 (GND_60), U4.R15 (GND_61), U4.R22 (GND_62), U4.T4 (GND_63), U4.T18 (GND_64), U4.U7 (GND_65), U4.U14 (GND_66), U4.U21 (GND_67), U4.V3 (GND_68), U4.V10 (GND_69), U4.V17 (GND_70), U4.W6 (GND_71), U4.W13 (GND_72), U4.W20 (GND_73), U4.Y2 (GND_74), U4.Y9 (GND_75), U4.Y16 (GND_76); also elsewhere on the board
unnamed: C132.2, FB2.2, U4.K12 (GNDADC_0), U4.L11 (VREFN_0), U4.L12 (VP_0), U4.M11 (VN_0), U4.M12 (VREFP_0)
unnamed: C131.1, C132.1, FB1.2, U4.K11 (VCCADC_0)

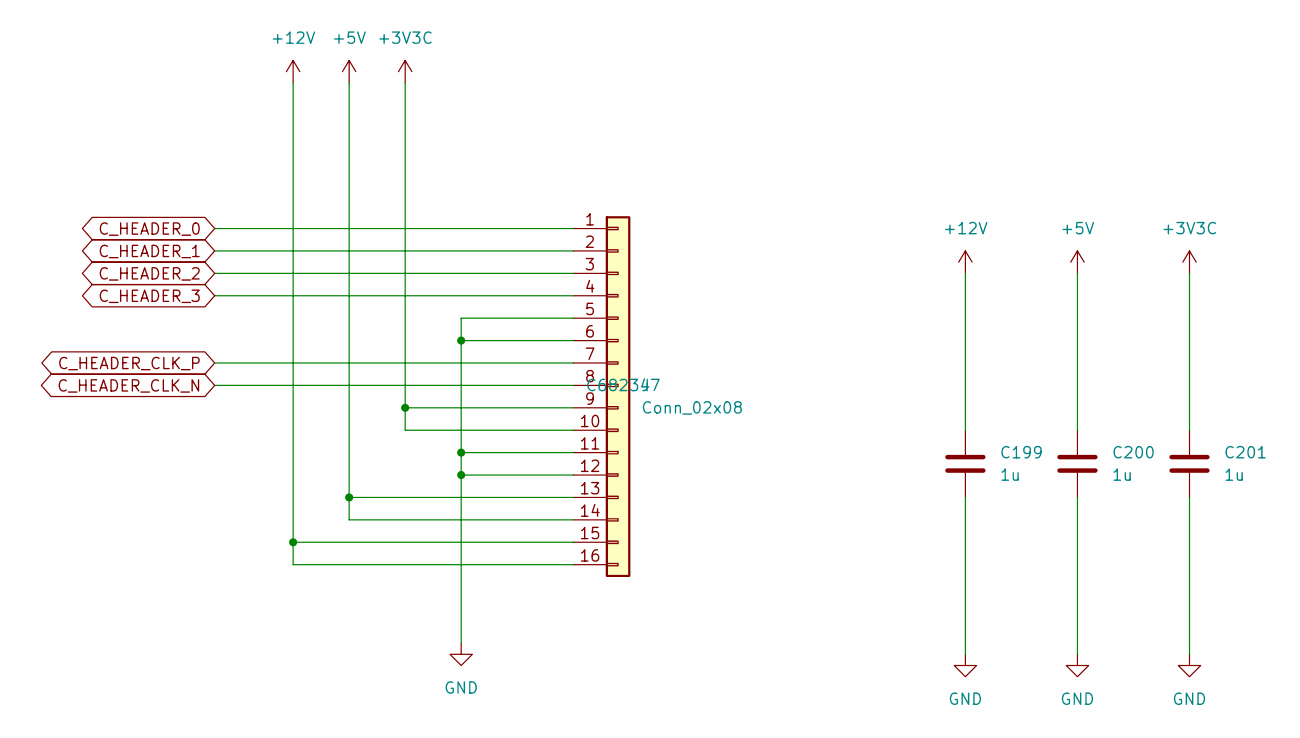
[picture p33: schematic ControllerFPGAHeader.kicad_sch]

Parts:
C199: 1u; C_0805_2012Metric; LCSC C126592
C200, C201: 1u; C_0603_1608Metric; LCSC C77386
J7: Conn_02x08; LCSC C68234

Connections:
+3V3C: C201.1, J7.9, J7.10; also elsewhere on the board
+5V: C200.1, J7.13, J7.14; also elsewhere on the board
+12V: C199.1, J7.15, J7.16; also elsewhere on the board
C_HEADER_0: J7.1; also elsewhere on the board
C_HEADER_1: J7.2; also elsewhere on the board
C_HEADER_2: J7.3; also elsewhere on the board
C_HEADER_3: J7.4; also elsewhere on the board
C_HEADER_CLK_N: J7.8; also elsewhere on the board
C_HEADER_CLK_P: J7.7; also elsewhere on the board
GND: C199.2, C200.2, C201.2, J7.5, J7.6, J7.11, J7.12; also elsewhere on the board

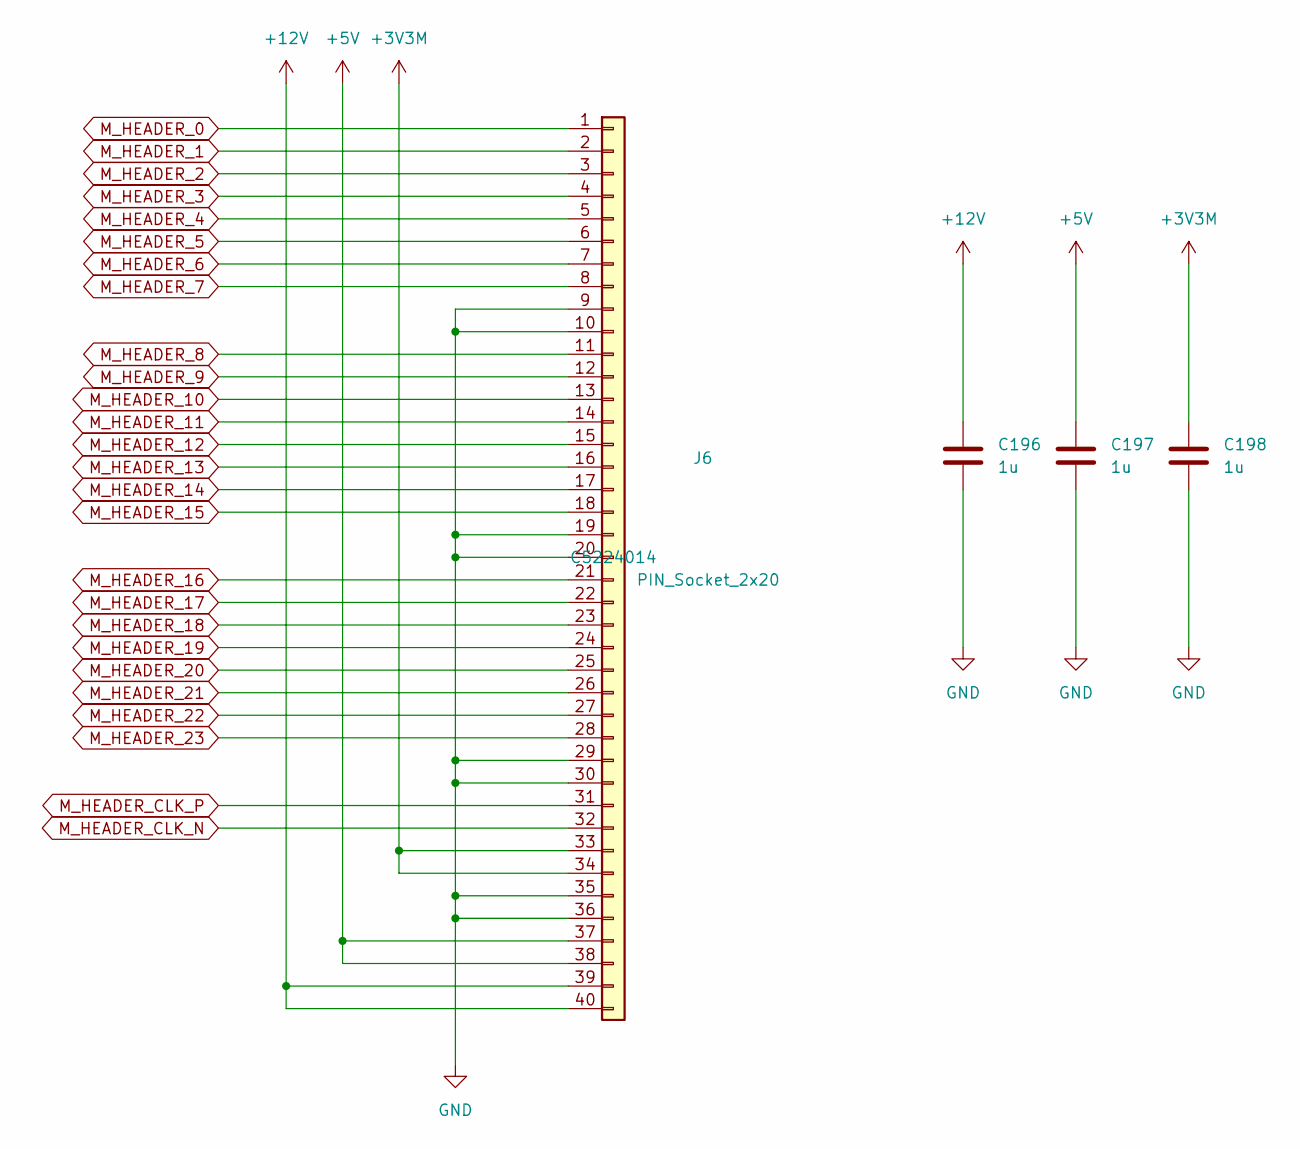
[picture p34: schematic MainFPGAHeader.kicad_sch]

Parts:
C196: 1u; C_0805_2012Metric; LCSC C126592
C197, C198: 1u; C_0603_1608Metric; LCSC C77386
J6: PIN_Socket_2x20; ZHOURI PZ2.54-2_20; LCSC C5224014

Connections:
+3V3M: C198.1, J6.33, J6.34; also elsewhere on the board
+5V: C197.1, J6.37, J6.38; also elsewhere on the board
+12V: C196.1, J6.39, J6.40; also elsewhere on the board
GND: C196.2, C197.2, C198.2, J6.9, J6.10, J6.19, J6.20, J6.29, J6.30, J6.35, J6.36; also elsewhere on the board
M_HEADER_0: J6.1; also elsewhere on the board
M_HEADER_1: J6.2; also elsewhere on the board
M_HEADER_2: J6.3; also elsewhere on the board
M_HEADER_3: J6.4; also elsewhere on the board
M_HEADER_4: J6.5; also elsewhere on the board
M_HEADER_5: J6.6; also elsewhere on the board
M_HEADER_6: J6.7; also elsewhere on the board
M_HEADER_7: J6.8; also elsewhere on the board
M_HEADER_8: J6.11; also elsewhere on the board
M_HEADER_9: J6.12; also elsewhere on the board
M_HEADER_10: J6.13; also elsewhere on the board
M_HEADER_11: J6.14; also elsewhere on the board
M_HEADER_12: J6.15; also elsewhere on the board
M_HEADER_13: J6.16; also elsewhere on the board
M_HEADER_14: J6.17; also elsewhere on the board
M_HEADER_15: J6.18; also elsewhere on the board
M_HEADER_16: J6.21; also elsewhere on the board
M_HEADER_17: J6.22; also elsewhere on the board
M_HEADER_18: J6.23; also elsewhere on the board
M_HEADER_19: J6.24; also elsewhere on the board
M_HEADER_20: J6.25; also elsewhere on the board
M_HEADER_21: J6.26; also elsewhere on the board
M_HEADER_22: J6.27; also elsewhere on the board
M_HEADER_23: J6.28; also elsewhere on the board
M_HEADER_CLK_N: J6.32; also elsewhere on the board
M_HEADER_CLK_P: J6.31; also elsewhere on the board

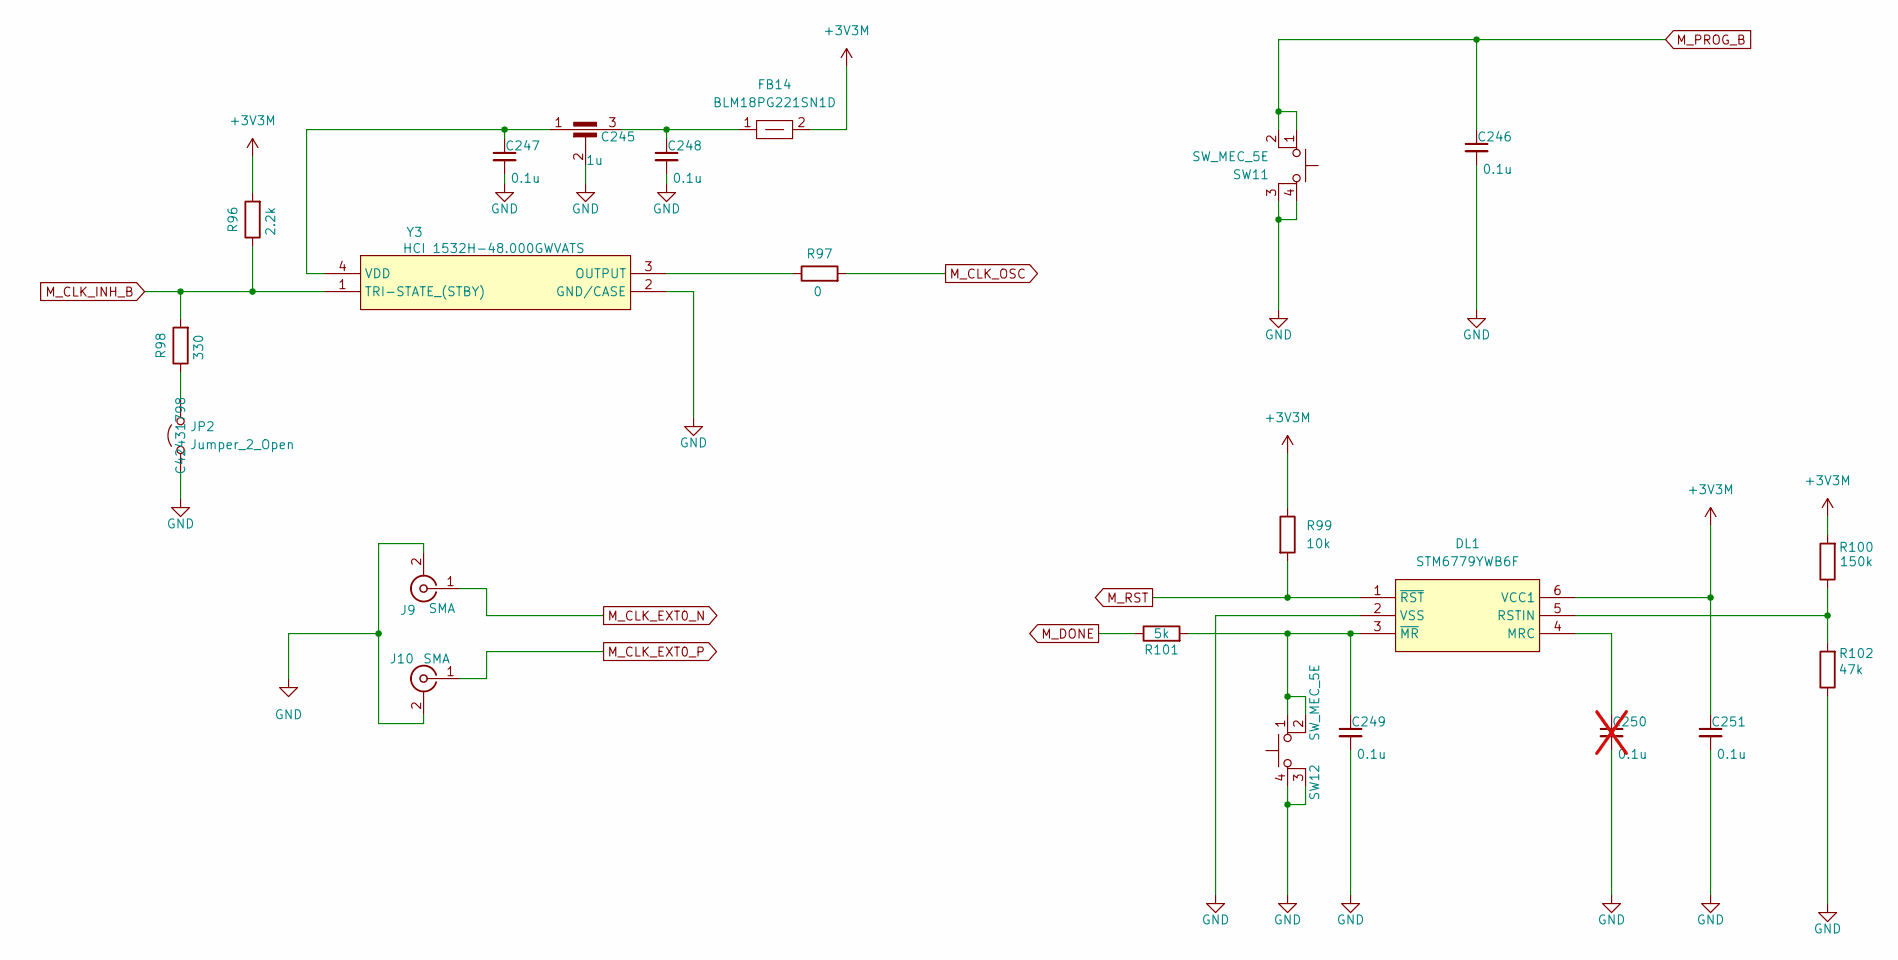
[picture p35: schematic MainFPGASupervisor.kicad_sch]

Parts:
C245: 1u; NFM31HK103R1H3L; LCSC C92518
C246, C247, C248, C249, C251: 0.1u; C_0603_1608Metric; LCSC C77055
C250: 0.1u; C_0603_1608Metric; LCSC C77055; not fitted
DL1: STM6779YWB6F; TSOT-23-6; LCSC C2802536
FB14: BLM18PG221SN1D; BLM18SP221SN1B; LCSC C80165
J9, J10: SMA; SMA_Amphenol_132134-14_Vertical; LCSC C3174425
JP2: Jumper_2_Open; PinHeader_1x02_P2.54mm_Vertical; LCSC C42431798
R96: 2.2k; R_0603_1608Metric; LCSC C114662
R97: 0; R_0603_1608Metric; LCSC C100044
R98: 330; R_0603_1608Metric; LCSC C105881
R99: 10k; R_0603_1608Metric; LCSC C95204
R100: 150k; R_0603_1608Metric; LCSC C2906993
R101: 5k; R_0603_1608Metric; LCSC C862232
R102: 47k; R_0603_1608Metric; LCSC C105579
SW11, SW12: SW_MEC_5E; MySW_PUSH_6mm_H5mm; LCSC C393938
Y3: HCI 1532H-48.000GWVATS; 1532H-48_000GWVATS; LCSC C51822787

Connections:
+3V3M: C251.1, DL1.6 (VCC1), FB14.2, R96.2, R99.1, R100.2; also elsewhere on the board
GND: C245.2, C246.2, C247.2, C248.2, C249.2, C250.2, C251.2, DL1.2 (VSS), J9.2 (Ext), J10.2 (Ext), JP2.1 (A), R102.1, SW11.3 (K), SW11.4 (A), SW12.3 (K), SW12.4 (A), Y3.2 (GND/CASE); also elsewhere on the board
M_CLK_EXT0_N: J9.1 (In); also elsewhere on the board
M_CLK_EXT0_P: J10.1 (In); also elsewhere on the board
M_CLK_INH_B: R96.1, R98.2, Y3.1 (TRI-STATE_(STBY)); also elsewhere on the board
M_CLK_OSC: R97.2; also elsewhere on the board
M_DONE: R101.1; also elsewhere on the board
M_PROG_B: C246.1, SW11.1, SW11.2; also elsewhere on the board
M_RST: DL1.1 (~RST), R99.2; also elsewhere on the board
unnamed: C245.3, C248.1, FB14.1
unnamed: C250.1, DL1.4 (MRC)
unnamed: DL1.5 (RSTIN), R100.1, R102.2
unnamed: C249.1, DL1.3 (~MR), R101.2, SW12.1, SW12.2
unnamed: JP2.2 (B), R98.1
unnamed: R97.1, Y3.3 (OUTPUT)
unnamed: C245.1, C247.1, Y3.4 (VDD)
