SHAMIKO-project/SHAMIKO-board/hardware/shamiko.kicad_pcb

## KiCad design hardware/shamiko.kicad_pcb (continued)

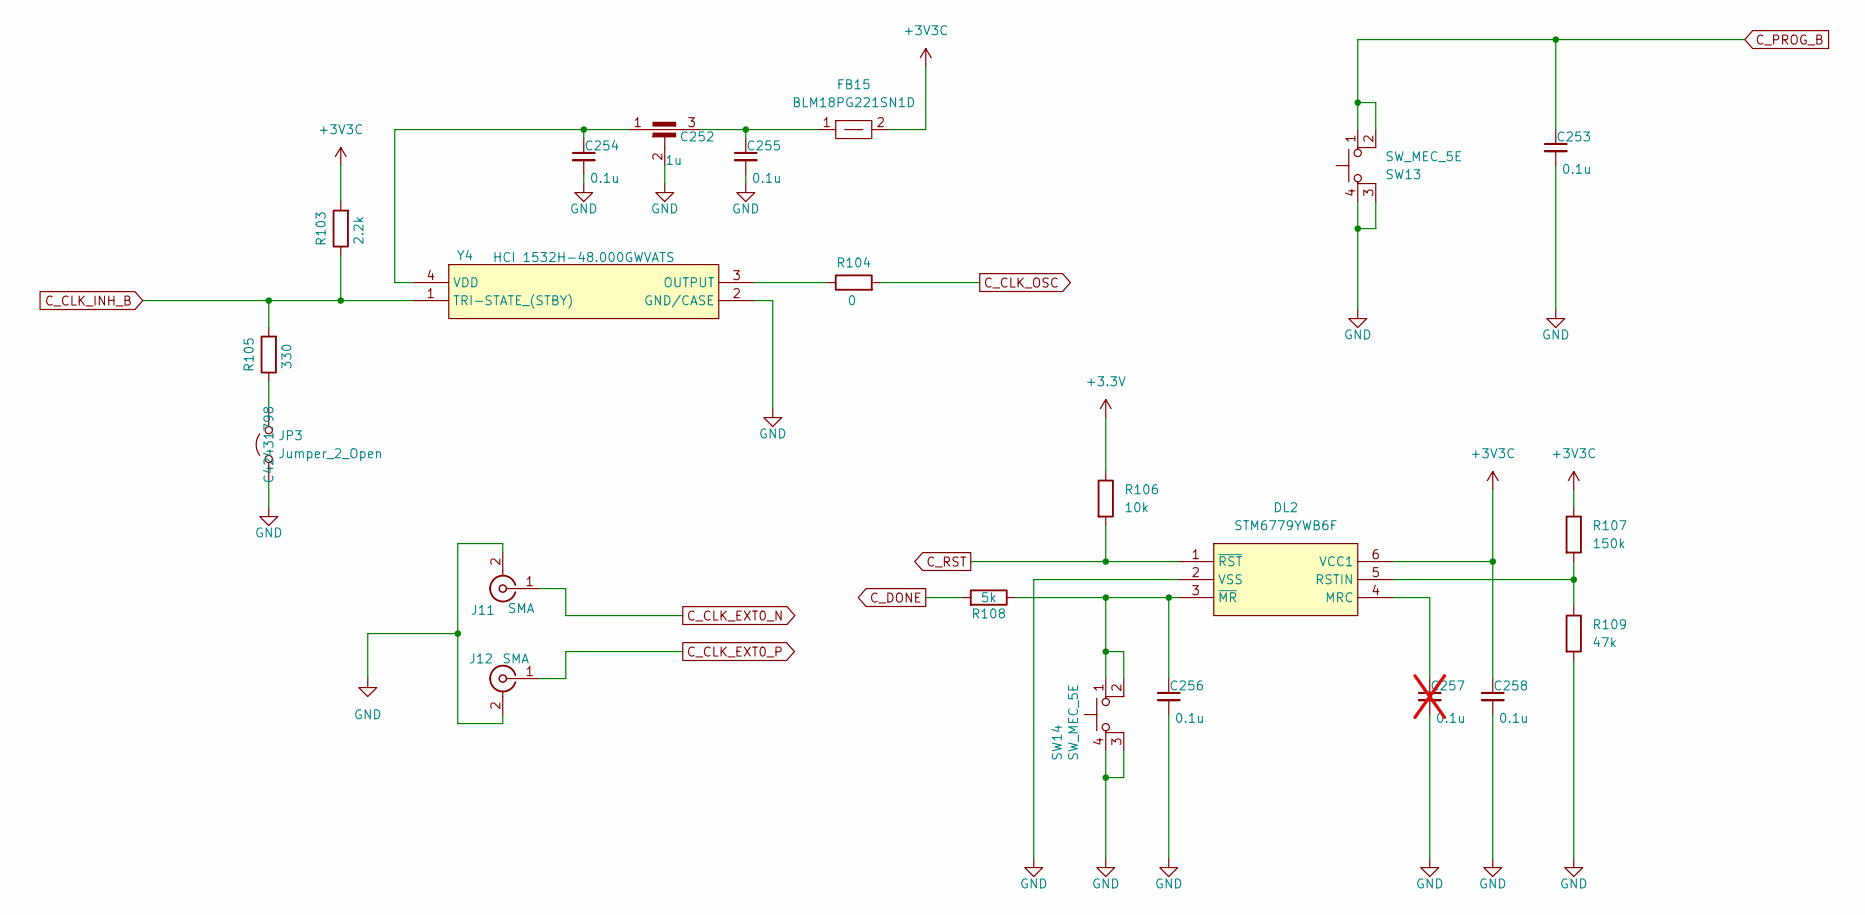
[picture p36: schematic ControlFPGASv.kicad_sch]

Parts:
C252: 1u; NFM31HK103R1H3L; LCSC C92518
C253, C254, C255, C256, C258: 0.1u; C_0603_1608Metric; LCSC C77055
C257: 0.1u; C_0603_1608Metric; LCSC C77055; not fitted
DL2: STM6779YWB6F; TSOT-23-6; LCSC C2802536
FB15: BLM18PG221SN1D; BLM18SP221SN1B; LCSC C80165
J11, J12: SMA; SMA_Amphenol_132134-14_Vertical; LCSC C3174425
JP3: Jumper_2_Open; PinHeader_1x02_P2.54mm_Vertical; LCSC C42431798
R103: 2.2k; R_0603_1608Metric; LCSC C114662
R104: 0; R_0603_1608Metric; LCSC C100044
R105: 330; R_0603_1608Metric; LCSC C105881
R106: 10k; R_0603_1608Metric; LCSC C95204
R107: 150k; R_0603_1608Metric; LCSC C2906993
R108: 5k; R_0603_1608Metric; LCSC C862232
R109: 47k; R_0603_1608Metric; LCSC C105579
SW13, SW14: SW_MEC_5E; MySW_PUSH_6mm_H5mm; LCSC C393938
Y4: HCI 1532H-48.000GWVATS; 1532H-48_000GWVATS; LCSC C51822787

Connections:
+3.3V: R106.1; also elsewhere on the board
+3V3C: C258.1, DL2.6 (VCC1), FB15.2, R103.2, R107.1; also elsewhere on the board
C_CLK_EXT0_N: J11.1 (In); also elsewhere on the board
C_CLK_EXT0_P: J12.1 (In); also elsewhere on the board
C_CLK_INH_B: R103.1, R105.2, Y4.1 (TRI-STATE_(STBY)); also elsewhere on the board
C_CLK_OSC: R104.2; also elsewhere on the board
C_DONE: R108.2; also elsewhere on the board
C_PROG_B: C253.1, SW13.1, SW13.2; also elsewhere on the board
C_RST: DL2.1 (~RST), R106.2; also elsewhere on the board
GND: C252.2, C253.2, C254.2, C255.2, C256.2, C257.2, C258.2, DL2.2 (VSS), J11.2 (Ext), J12.2 (Ext), JP3.1 (A), R109.2, SW13.3 (K), SW13.4 (A), SW14.3 (K), SW14.4 (A), Y4.2 (GND/CASE); also elsewhere on the board
unnamed: C252.3, C255.1, FB15.1
unnamed: C257.1, DL2.4 (MRC)
unnamed: DL2.5 (RSTIN), R107.2, R109.1
unnamed: C256.1, DL2.3 (~MR), R108.1, SW14.1, SW14.2
unnamed: JP3.2 (B), R105.1
unnamed: R104.1, Y4.3 (OUTPUT)
unnamed: C252.1, C254.1, Y4.4 (VDD)

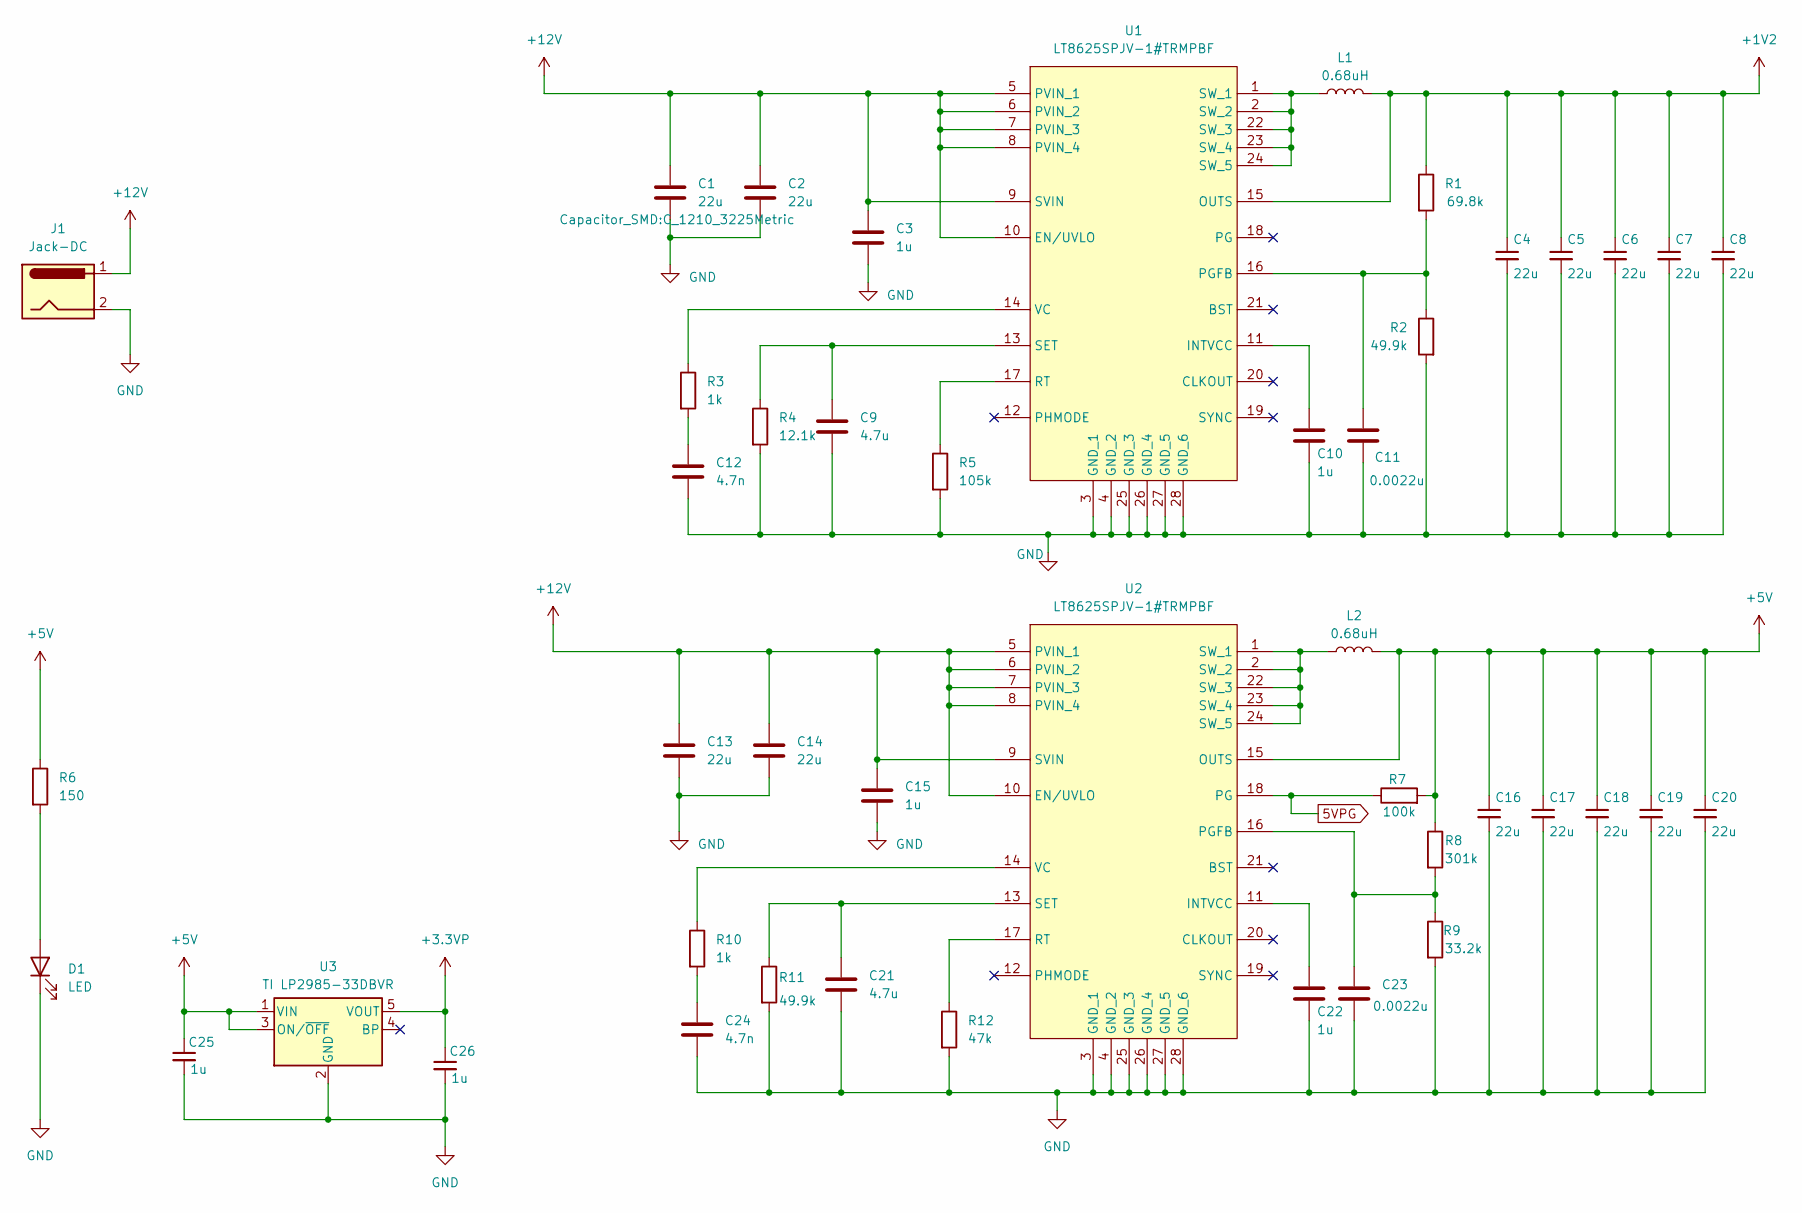
[picture p37: schematic Power_root.kicad_sch]

Parts:
C1, C2, C13, C14: 22u; C_1210_3225Metric; LCSC C309062
C3, C15: 1u; C_0805_2012Metric; LCSC C126592
C4, C5, C6, C7, C8, C16, C17, C18, C19, C20: 22u; C_1210_3225Metric; LCSC C21397
C9, C21: 4.7u; C_0603_1608Metric; LCSC C90057
C10, C22, C25, C26: 1u; C_0603_1608Metric; LCSC C77386
C11, C23: 0.0022u; C_0603_1608Metric; LCSC C77033
C12, C24: 4.7n; C_0603_1608Metric; LCSC C85980
D1: LED; LED_0603_1608Metric; LCSC C125103
J1: Jack-DC; CUI_PJ-002A; LCSC C3096082
L1, L2: 0.68uH; XRIM404030SR68MBCA; LCSC C39846865
R1: 69.8k; R_0603_1608Metric; LCSC C861526
R2, R11: 49.9k; R_0603_1608Metric; LCSC C705780
R3, R10: 1k; R_0603_1608Metric; LCSC C22548
R4: 12.1k; R_0603_1608Metric; LCSC C123417
R5: 105k; R_0603_1608Metric; LCSC C861072
R6: 150; R_0603_1608Metric; LCSC C227596
R7: 100k; R_0603_1608Metric; LCSC C25803
R8: 301k; R_0603_1608Metric; LCSC C861309
R9: 33.2k; R_0603_1608Metric; LCSC C2075328
R12: 47k; R_0603_1608Metric; LCSC C105579
U1, U2: LT8625SPJV-1#TRMPBF; LCSC C37130042
U3: TI LP2985-33DBVR; SOT-23-5; LCSC C95414

Connections:
5VPG: R7.1, U2.18 (PG); also elsewhere on the board
+1V2: C4.1, C5.1, C6.1, C7.1, C8.1, L1.2, R1.1, U1.15 (OUTS); also elsewhere on the board
+3.3VP: C26.1, U3.5 (VOUT); also elsewhere on the board
+5V: C16.1, C17.1, C18.1, C19.1, C20.1, C25.1, L2.2, R6.1, R7.2, R8.1, U2.15 (OUTS), U3.1 (VIN), U3.3 (ON/~OFF); also elsewhere on the board
+12V: C1.1, C2.1, C3.1, C13.1, C14.1, C15.1, J1.1, U1.5 (PVIN_1), U1.6 (PVIN_2), U1.7 (PVIN_3), U1.8 (PVIN_4), U1.9 (SVIN), U1.10 (EN/UVLO), U2.5 (PVIN_1), U2.6 (PVIN_2), U2.7 (PVIN_3), U2.8 (PVIN_4), U2.9 (SVIN), U2.10 (EN/UVLO); also elsewhere on the board
GND: C1.2, C2.2, C3.2, C4.2, C5.2, C6.2, C7.2, C8.2, C9.2, C10.2, C11.2, C12.2, C13.2, C14.2, C15.2, C16.2, C17.2, C18.2, C19.2, C20.2, C21.2, C22.2, C23.2, C24.2, C25.2, C26.2, D1.1 (K), J1.2, R2.2, R4.2, R5.2, R9.2, R11.2, R12.2, U1.3 (GND_1), U1.4 (GND_2), U1.25 (GND_3), U1.26 (GND_4), U1.27 (GND_5), U1.28 (GND_6), U2.3 (GND_1), U2.4 (GND_2), U2.25 (GND_3), U2.26 (GND_4), U2.27 (GND_5), U2.28 (GND_6), U3.2 (GND); also elsewhere on the board
unnamed: C12.1, R3.2
unnamed: C24.1, R10.2
unnamed: D1.2 (A), R6.2
unnamed: C10.1, U1.11 (INTVCC)
unnamed: C11.1, R1.2, R2.1, U1.16 (PGFB)
unnamed: R5.1, U1.17 (RT)
unnamed: C9.1, R4.1, U1.13 (SET)
unnamed: L1.1, U1.1 (SW_1), U1.2 (SW_2), U1.22 (SW_3), U1.23 (SW_4), U1.24 (SW_5)
unnamed: R3.1, U1.14 (VC)
unnamed: C22.1, U2.11 (INTVCC)
unnamed: C23.1, R8.2, R9.1, U2.16 (PGFB)
unnamed: R12.1, U2.17 (RT)
unnamed: C21.1, R11.1, U2.13 (SET)
unnamed: L2.1, U2.1 (SW_1), U2.2 (SW_2), U2.22 (SW_3), U2.23 (SW_4), U2.24 (SW_5)
unnamed: R10.1, U2.14 (VC)

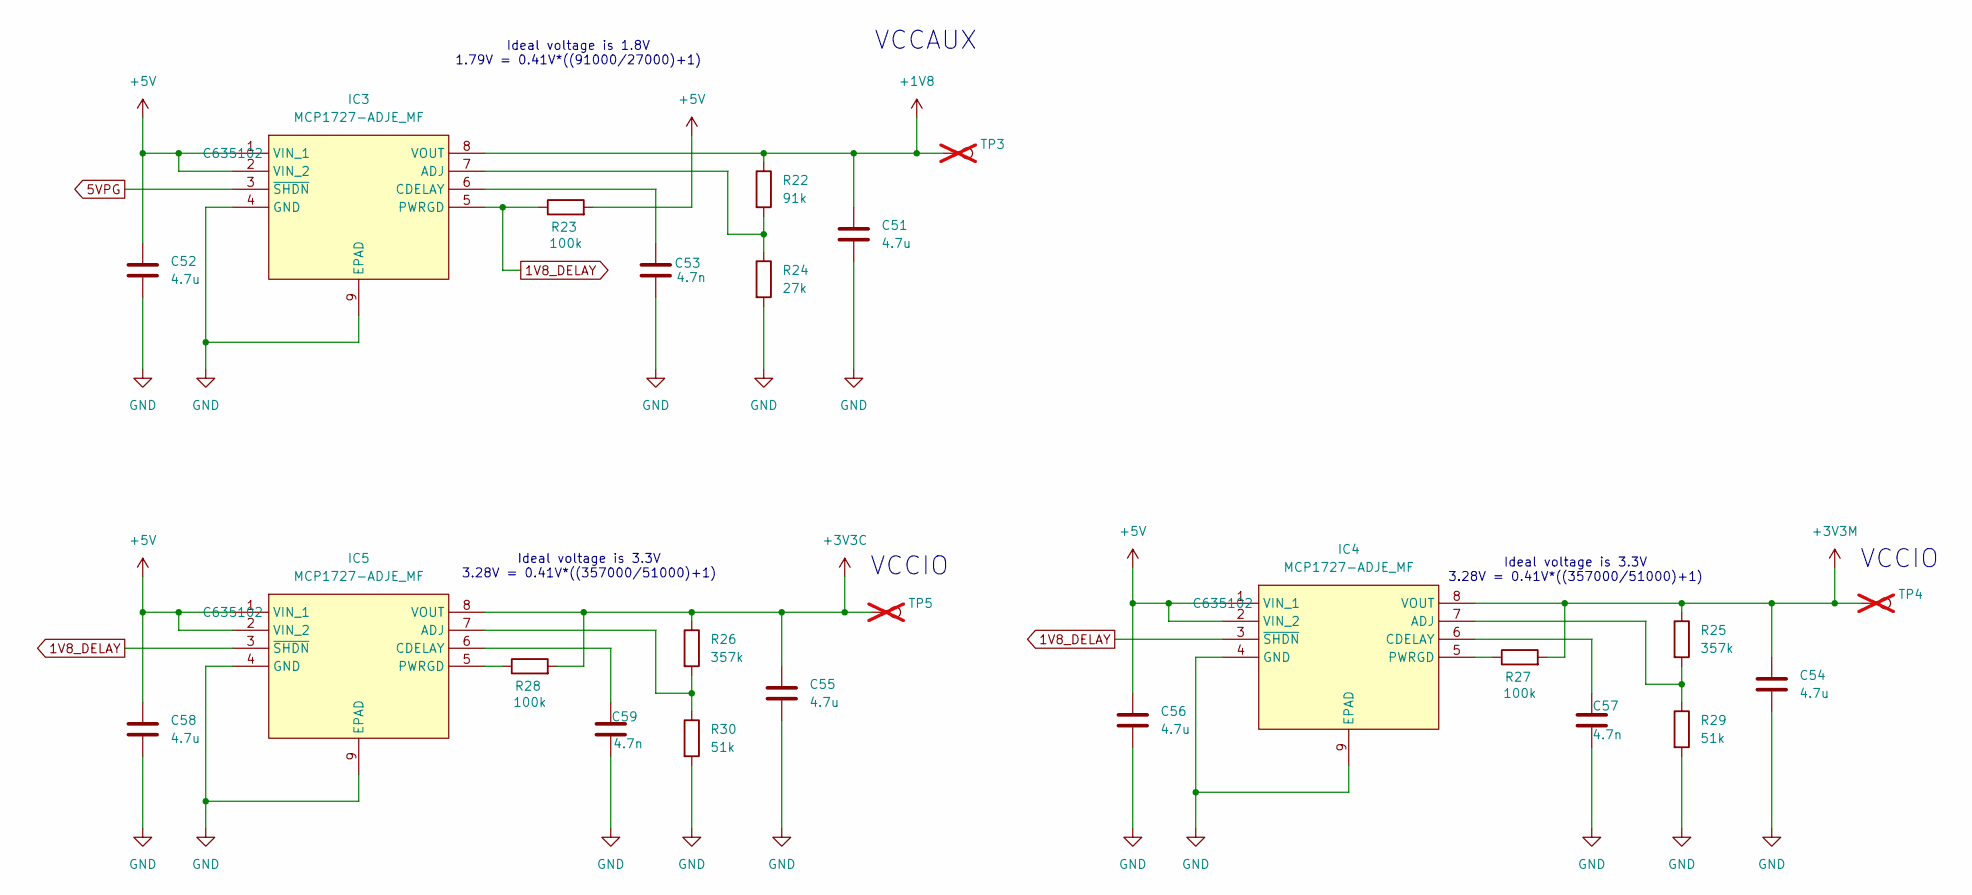
[picture p38: schematic Power(VCC1V2C,VCC2V5,VCC2V8).kicad_sch]

Parts:
C51, C52, C54, C55, C56, C58: 4.7u; C_0603_1608Metric; LCSC C90057
C53, C57, C59: 4.7n; C_0603_1608Metric; LCSC C85980
IC3, IC4, IC5: MCP1727-ADJE_MF; LCSC C635102
R22: 91k; R_0603_1608Metric; LCSC C326721
R23, R27, R28: 100k; R_0603_1608Metric; LCSC C25803
R24: 27k; R_0603_1608Metric; LCSC C309651
R25, R26: 357k; R_0603_1608Metric; LCSC C913223
R29, R30: 51k; R_0603_1608Metric; LCSC C861458
TP3, TP4, TP5: TestPoint; TestPoint_Pad_D1.0mm; LCSC None; not fitted

Connections:
1V8_DELAY: IC3.5 (PWRGD), IC4.3 (~SHDN), IC5.3 (~SHDN), R23.1
5VPG: IC3.3 (~SHDN); also elsewhere on the board
+1V8: C51.1, IC3.8 (VOUT), R22.1, TP3.1; also elsewhere on the board
+3V3C: C55.1, IC5.8 (VOUT), R26.1, R28.2, TP5.1; also elsewhere on the board
+3V3M: C54.1, IC4.8 (VOUT), R25.1, R27.2, TP4.1; also elsewhere on the board
+5V: C52.1, C56.1, C58.1, IC3.1 (VIN_1), IC3.2 (VIN_2), IC4.1 (VIN_1), IC4.2 (VIN_2), IC5.1 (VIN_1), IC5.2 (VIN_2), R23.2; also elsewhere on the board
GND: C51.2, C52.2, C53.2, C54.2, C55.2, C56.2, C57.2, C58.2, C59.2, IC3.4 (GND), IC3.9 (EPAD), IC4.4 (GND), IC4.9 (EPAD), IC5.4 (GND), IC5.9 (EPAD), R24.2, R29.2, R30.2; also elsewhere on the board
unnamed: IC3.7 (ADJ), R22.2, R24.1
unnamed: C53.1, IC3.6 (CDELAY)
unnamed: IC4.7 (ADJ), R25.2, R29.1
unnamed: C57.1, IC4.6 (CDELAY)
unnamed: IC4.5 (PWRGD), R27.1
unnamed: IC5.7 (ADJ), R26.2, R30.1
unnamed: C59.1, IC5.6 (CDELAY)
unnamed: IC5.5 (PWRGD), R28.1

Notes on the sheet:
VCCAUX
Ideal voltage is 1.8V 1.79V = 0.41V*((91000/27000)+1)
Ideal voltage is 3.3V 3.28V = 0.41V*((357000/51000)+1)
VCCIO

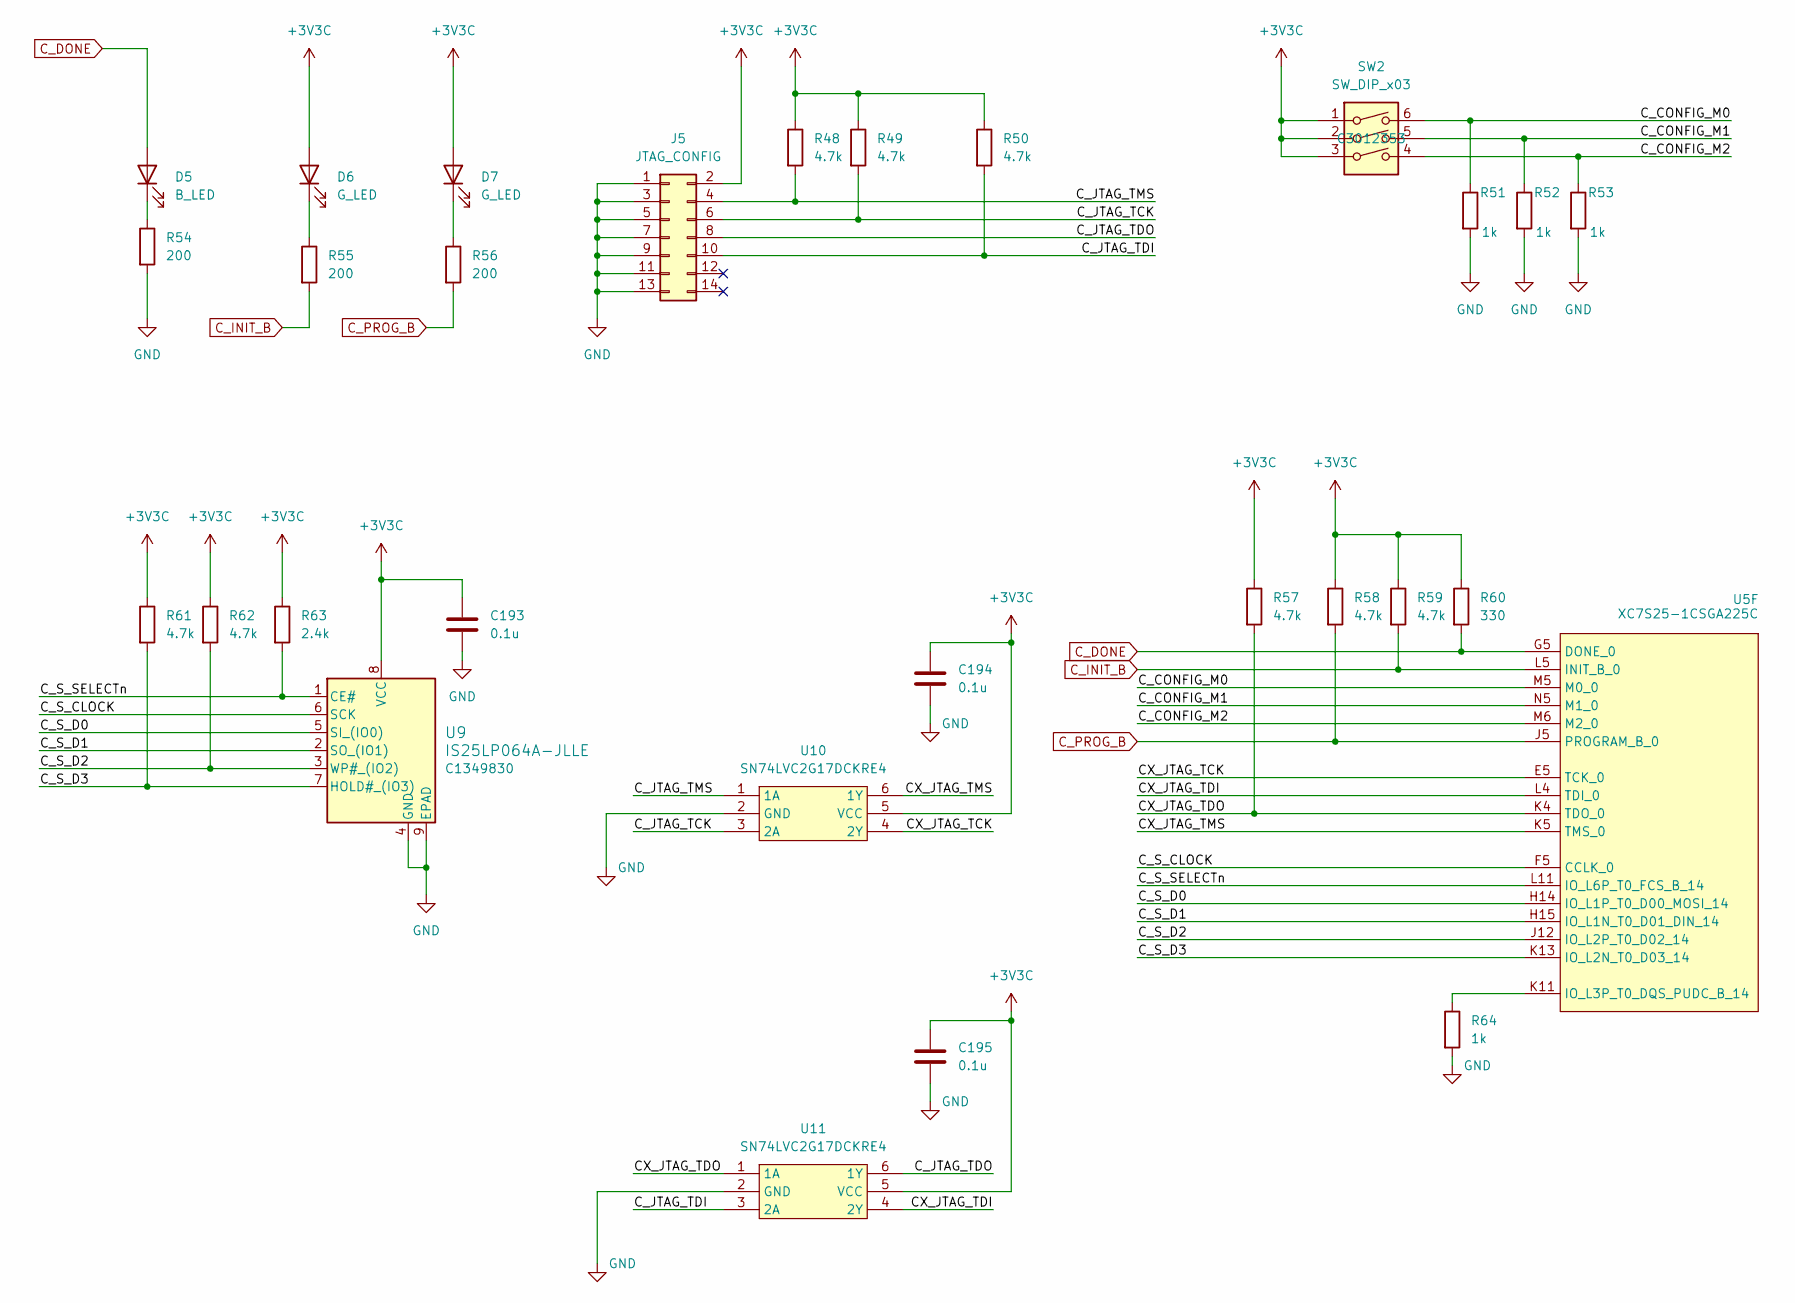
[picture p39: schematic ControlFPGAConfig.kicad_sch]

Parts:
C193, C194, C195: 0.1u; C_0603_1608Metric; LCSC C77055
D5: B_LED; LED_0603_1608Metric; LCSC C19171394
D6, D7: G_LED; LED_0603_1608Metric; LCSC C5342733
J5: JTAG_CONFIG; JTAG_2x7_P2.54mm; LCSC C240854
R48, R49, R50, R57, R58, R59, R61, R62: 4.7k; R_0603_1608Metric; LCSC C99782
R51, R52, R53, R64: 1k; R_0603_1608Metric; LCSC C22548
R54, R55, R56: 200; R_0603_1608Metric; LCSC C2907123
R60: 330; R_0603_1608Metric; LCSC C105881
R63: 2.4k; R_0603_1608Metric; LCSC C22940
SW2: SW_DIP_x03; SW_DIP_SPSTx03_Slide_9.78x9.8mm_W8.61mm_P2.54mm; LCSC C3012353
U5: XC7S25-1CSGA225C; LCSC C1521699
U9: IS25LP064A-JLLE; WSON-8-1EP_8x6mm_P1.27mm_EP3.4x4.3mm; LCSC C1349830
U10, U11: SN74LVC2G17DCKRE4; LCSC C50714

Connections:
+3V3C: C193.1, C194.1, C195.1, D6.2 (A), D7.2 (A), J5.2, R48.1, R49.1, R50.1, R57.1, R58.1, R59.1, R60.1, R61.1, R62.1, R63.1, SW2.1, SW2.2, SW2.3, U9.8 (VCC), U10.5 (VCC), U11.5 (VCC); also elsewhere on the board
/Control FPGA Configuration/CX_JTAG_TCK: U5.E5 (TCK_0), U10.4 (2Y)
/Control FPGA Configuration/CX_JTAG_TDI: U5.L4 (TDI_0), U11.4 (2Y)
/Control FPGA Configuration/CX_JTAG_TDO: R57.2, U5.K4 (TDO_0), U11.1 (1A)
/Control FPGA Configuration/CX_JTAG_TMS: U5.K5 (TMS_0), U10.6 (1Y)
/Control FPGA Configuration/C_CONFIG_M0: R51.1, SW2.6, U5.M5 (M0_0)
/Control FPGA Configuration/C_CONFIG_M1: R52.1, SW2.5, U5.N5 (M1_0)
/Control FPGA Configuration/C_CONFIG_M2: R53.1, SW2.4, U5.M6 (M2_0)
/Control FPGA Configuration/C_JTAG_TCK: J5.6, R49.2, U10.3 (2A)
/Control FPGA Configuration/C_JTAG_TDI: J5.10, R50.2, U11.3 (2A)
/Control FPGA Configuration/C_JTAG_TDO: J5.8, U11.6 (1Y)
/Control FPGA Configuration/C_JTAG_TMS: J5.4, R48.2, U10.1 (1A)
/Control FPGA Configuration/C_S_CLOCK: U5.F5 (CCLK_0), U9.6 (SCK)
/Control FPGA Configuration/C_S_D0: U5.H14 (IO_L1P_T0_D00_MOSI_14), U9.5 (SI_(IO0))
/Control FPGA Configuration/C_S_D1: U5.H15 (IO_L1N_T0_D01_DIN_14), U9.2 (SO_(IO1))
/Control FPGA Configuration/C_S_D2: R62.2, U5.J12 (IO_L2P_T0_D02_14), U9.3 (WP#_(IO2))
/Control FPGA Configuration/C_S_D3: R61.2, U5.K13 (IO_L2N_T0_D03_14), U9.7 (HOLD#_(IO3))
/Control FPGA Configuration/C_S_SELECTn: R63.2, U5.L11 (IO_L6P_T0_FCS_B_14), U9.1 (CE#)
C_DONE: D5.2 (A), R60.2, U5.G5 (DONE_0); also elsewhere on the board
C_INIT_B: R55.2, R59.2, U5.L5 (INIT_B_0)
C_PROG_B: R56.2, R58.2, U5.J5 (PROGRAM_B_0); also elsewhere on the board
GND: C193.2, C194.2, C195.2, J5.1, J5.3, J5.5, J5.7, J5.9, J5.11, J5.13, R51.2, R52.2, R53.2, R54.2, R64.2, U9.4 (GND), U9.9 (EPAD), U10.2 (GND), U11.2 (GND); also elsewhere on the board
unnamed: D5.1 (K), R54.1
unnamed: D6.1 (K), R55.1
unnamed: D7.1 (K), R56.1
unnamed: R64.1, U5.K11 (IO_L3P_T0_DQS_PUDC_B_14)

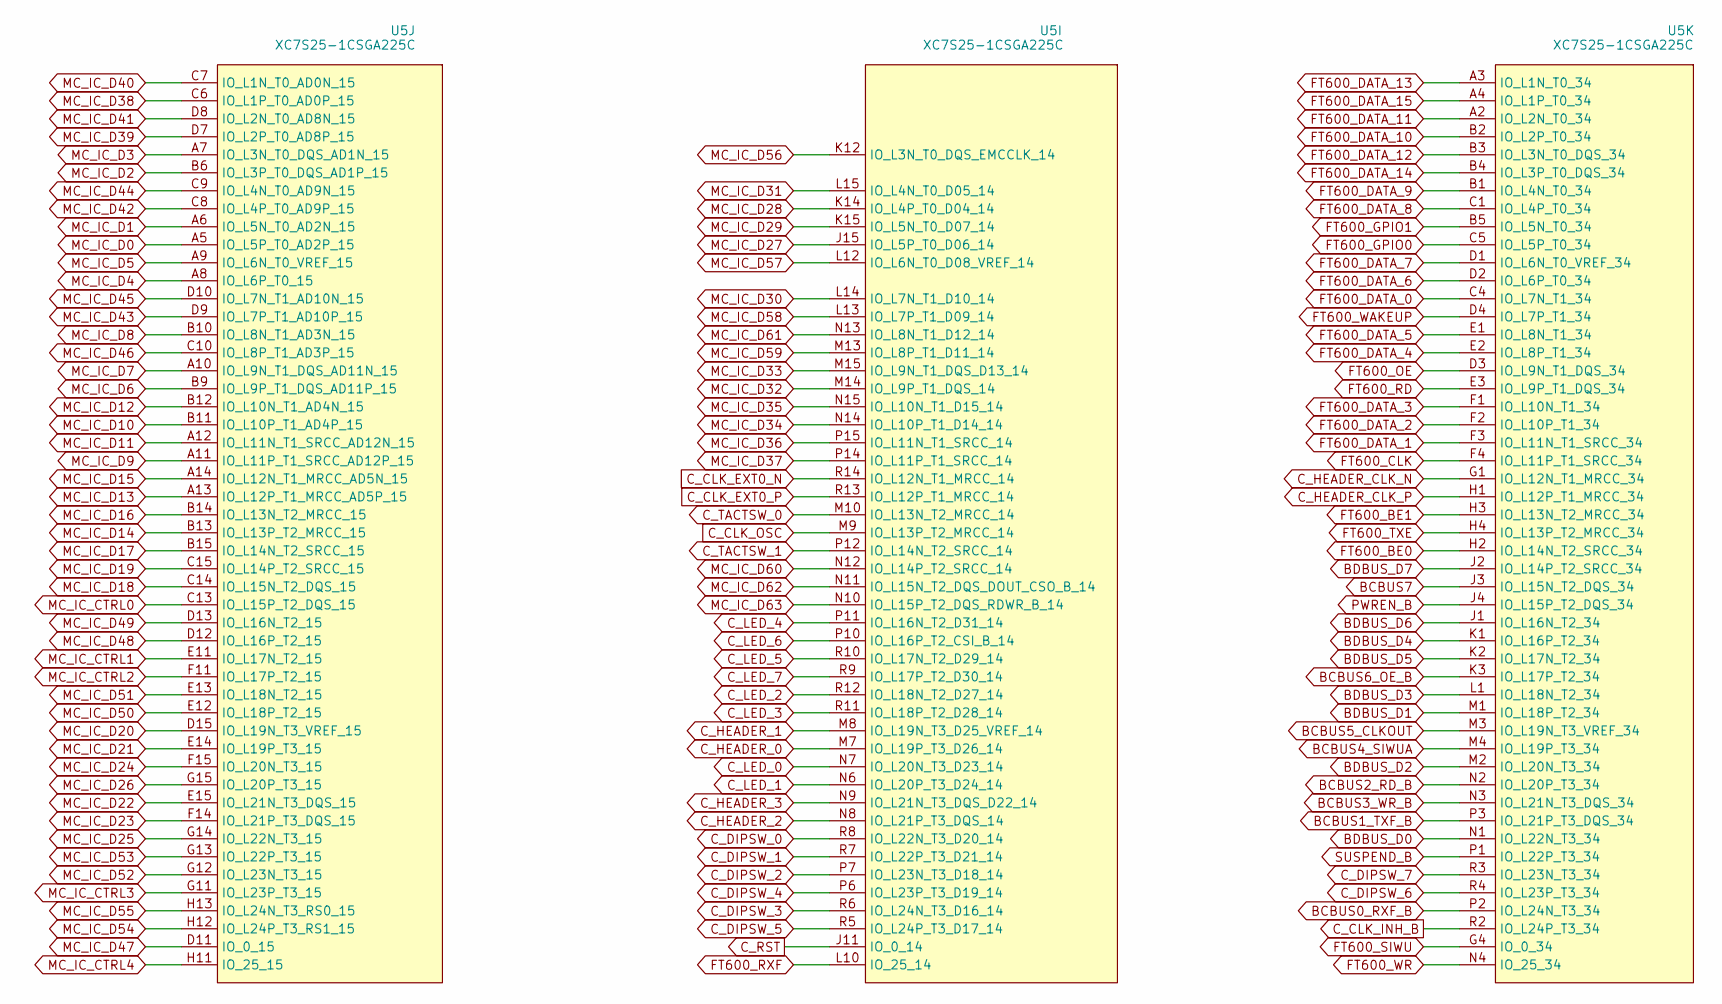
[picture p40: schematic ControllerFPGAIO.kicad_sch]

Parts:
U5: XC7S25-1CSGA225C; LCSC C1521699

Connections:
BCBUS0_RXF_B: U5.P2 (IO_L24N_T3_34); also elsewhere on the board
BCBUS1_TXF_B: U5.P3 (IO_L21P_T3_DQS_34); also elsewhere on the board
BCBUS2_RD_B: U5.N2 (IO_L20P_T3_34); also elsewhere on the board
BCBUS3_WR_B: U5.N3 (IO_L21N_T3_DQS_34); also elsewhere on the board
BCBUS4_SIWUA: U5.M4 (IO_L19P_T3_34); also elsewhere on the board
BCBUS5_CLKOUT: U5.M3 (IO_L19N_T3_VREF_34); also elsewhere on the board
BCBUS6_OE_B: U5.K3 (IO_L17P_T2_34); also elsewhere on the board
BCBUS7: U5.J3 (IO_L15N_T2_DQS_34); also elsewhere on the board
BDBUS_D0: U5.N1 (IO_L22N_T3_34); also elsewhere on the board
BDBUS_D1: U5.M1 (IO_L18P_T2_34); also elsewhere on the board
BDBUS_D2: U5.M2 (IO_L20N_T3_34); also elsewhere on the board
BDBUS_D3: U5.L1 (IO_L18N_T2_34); also elsewhere on the board
BDBUS_D4: U5.K1 (IO_L16P_T2_34); also elsewhere on the board
BDBUS_D5: U5.K2 (IO_L17N_T2_34); also elsewhere on the board
BDBUS_D6: U5.J1 (IO_L16N_T2_34); also elsewhere on the board
BDBUS_D7: U5.J2 (IO_L14P_T2_SRCC_34); also elsewhere on the board
C_CLK_EXT0_N: U5.R14 (IO_L12N_T1_MRCC_14); also elsewhere on the board
C_CLK_EXT0_P: U5.R13 (IO_L12P_T1_MRCC_14); also elsewhere on the board
C_CLK_INH_B: U5.R2 (IO_L24P_T3_34); also elsewhere on the board
C_CLK_OSC: U5.M9 (IO_L13P_T2_MRCC_14); also elsewhere on the board
C_DIPSW_0: U5.R8 (IO_L22N_T3_D20_14); also elsewhere on the board
C_DIPSW_1: U5.R7 (IO_L22P_T3_D21_14); also elsewhere on the board
C_DIPSW_2: U5.P7 (IO_L23N_T3_D18_14); also elsewhere on the board
C_DIPSW_3: U5.R6 (IO_L24N_T3_D16_14); also elsewhere on the board
C_DIPSW_4: U5.P6 (IO_L23P_T3_D19_14); also elsewhere on the board
C_DIPSW_5: U5.R5 (IO_L24P_T3_D17_14); also elsewhere on the board
C_DIPSW_6: U5.R4 (IO_L23P_T3_34); also elsewhere on the board
C_DIPSW_7: U5.R3 (IO_L23N_T3_34); also elsewhere on the board
C_HEADER_0: U5.M7 (IO_L19P_T3_D26_14); also elsewhere on the board
C_HEADER_1: U5.M8 (IO_L19N_T3_D25_VREF_14); also elsewhere on the board
C_HEADER_2: U5.N8 (IO_L21P_T3_DQS_14); also elsewhere on the board
C_HEADER_3: U5.N9 (IO_L21N_T3_DQS_D22_14); also elsewhere on the board
C_HEADER_CLK_N: U5.G1 (IO_L12N_T1_MRCC_34); also elsewhere on the board
C_HEADER_CLK_P: U5.H1 (IO_L12P_T1_MRCC_34); also elsewhere on the board
C_LED_0: U5.N7 (IO_L20N_T3_D23_14); also elsewhere on the board
C_LED_1: U5.N6 (IO_L20P_T3_D24_14); also elsewhere on the board
C_LED_2: U5.R12 (IO_L18N_T2_D27_14); also elsewhere on the board
C_LED_3: U5.R11 (IO_L18P_T2_D28_14); also elsewhere on the board
C_LED_4: U5.P11 (IO_L16N_T2_D31_14); also elsewhere on the board
C_LED_5: U5.R10 (IO_L17N_T2_D29_14); also elsewhere on the board
C_LED_6: U5.P10 (IO_L16P_T2_CSI_B_14); also elsewhere on the board
C_LED_7: U5.R9 (IO_L17P_T2_D30_14); also elsewhere on the board
C_RST: U5.J11 (IO_0_14); also elsewhere on the board
C_TACTSW_0: U5.M10 (IO_L13N_T2_MRCC_14); also elsewhere on the board
C_TACTSW_1: U5.P12 (IO_L14N_T2_SRCC_14); also elsewhere on the board
FT600_BE0: U5.H2 (IO_L14N_T2_SRCC_34); also elsewhere on the board
FT600_BE1: U5.H3 (IO_L13N_T2_MRCC_34); also elsewhere on the board
FT600_CLK: U5.F4 (IO_L11P_T1_SRCC_34); also elsewhere on the board
FT600_DATA_0: U5.C4 (IO_L7N_T1_34); also elsewhere on the board
FT600_DATA_1: U5.F3 (IO_L11N_T1_SRCC_34); also elsewhere on the board
FT600_DATA_2: U5.F2 (IO_L10P_T1_34); also elsewhere on the board
FT600_DATA_3: U5.F1 (IO_L10N_T1_34); also elsewhere on the board
FT600_DATA_4: U5.E2 (IO_L8P_T1_34); also elsewhere on the board
FT600_DATA_5: U5.E1 (IO_L8N_T1_34); also elsewhere on the board
FT600_DATA_6: U5.D2 (IO_L6P_T0_34); also elsewhere on the board
FT600_DATA_7: U5.D1 (IO_L6N_T0_VREF_34); also elsewhere on the board
FT600_DATA_8: U5.C1 (IO_L4P_T0_34); also elsewhere on the board
FT600_DATA_9: U5.B1 (IO_L4N_T0_34); also elsewhere on the board
FT600_DATA_10: U5.B2 (IO_L2P_T0_34); also elsewhere on the board
FT600_DATA_11: U5.A2 (IO_L2N_T0_34); also elsewhere on the board
FT600_DATA_12: U5.B3 (IO_L3N_T0_DQS_34); also elsewhere on the board
FT600_DATA_13: U5.A3 (IO_L1N_T0_34); also elsewhere on the board
FT600_DATA_14: U5.B4 (IO_L3P_T0_DQS_34); also elsewhere on the board
FT600_DATA_15: U5.A4 (IO_L1P_T0_34); also elsewhere on the board
FT600_GPIO0: U5.C5 (IO_L5P_T0_34); also elsewhere on the board
FT600_GPIO1: U5.B5 (IO_L5N_T0_34); also elsewhere on the board
FT600_OE: U5.D3 (IO_L9N_T1_DQS_34); also elsewhere on the board
FT600_RD: U5.E3 (IO_L9P_T1_DQS_34); also elsewhere on the board
FT600_RXF: U5.L10 (IO_25_14); also elsewhere on the board
FT600_SIWU: U5.G4 (IO_0_34); also elsewhere on the board
FT600_TXE: U5.H4 (IO_L13P_T2_MRCC_34); also elsewhere on the board
FT600_WAKEUP: U5.D4 (IO_L7P_T1_34); also elsewhere on the board
FT600_WR: U5.N4 (IO_25_34); also elsewhere on the board
MC_IC_CTRL0: U5.C13 (IO_L15P_T2_DQS_15); also elsewhere on the board
MC_IC_CTRL1: U5.E11 (IO_L17N_T2_15); also elsewhere on the board
MC_IC_CTRL2: U5.F11 (IO_L17P_T2_15); also elsewhere on the board
MC_IC_CTRL3: U5.G11 (IO_L23P_T3_15); also elsewhere on the board
MC_IC_CTRL4: U5.H11 (IO_25_15); also elsewhere on the board
MC_IC_D0: U5.A5 (IO_L5P_T0_AD2P_15); also elsewhere on the board
MC_IC_D1: U5.A6 (IO_L5N_T0_AD2N_15); also elsewhere on the board
MC_IC_D2: U5.B6 (IO_L3P_T0_DQS_AD1P_15); also elsewhere on the board
MC_IC_D3: U5.A7 (IO_L3N_T0_DQS_AD1N_15); also elsewhere on the board
MC_IC_D4: U5.A8 (IO_L6P_T0_15); also elsewhere on the board
MC_IC_D5: U5.A9 (IO_L6N_T0_VREF_15); also elsewhere on the board
MC_IC_D6: U5.B9 (IO_L9P_T1_DQS_AD11P_15); also elsewhere on the board
MC_IC_D7: U5.A10 (IO_L9N_T1_DQS_AD11N_15); also elsewhere on the board
MC_IC_D8: U5.B10 (IO_L8N_T1_AD3N_15); also elsewhere on the board
MC_IC_D9: U5.A11 (IO_L11P_T1_SRCC_AD12P_15); also elsewhere on the board
MC_IC_D10: U5.B11 (IO_L10P_T1_AD4P_15); also elsewhere on the board
MC_IC_D11: U5.A12 (IO_L11N_T1_SRCC_AD12N_15); also elsewhere on the board
MC_IC_D12: U5.B12 (IO_L10N_T1_AD4N_15); also elsewhere on the board
MC_IC_D13: U5.A13 (IO_L12P_T1_MRCC_AD5P_15); also elsewhere on the board
MC_IC_D14: U5.B13 (IO_L13P_T2_MRCC_15); also elsewhere on the board
MC_IC_D15: U5.A14 (IO_L12N_T1_MRCC_AD5N_15); also elsewhere on the board
MC_IC_D16: U5.B14 (IO_L13N_T2_MRCC_15); also elsewhere on the board
MC_IC_D17: U5.B15 (IO_L14N_T2_SRCC_15); also elsewhere on the board
MC_IC_D18: U5.C14 (IO_L15N_T2_DQS_15); also elsewhere on the board
MC_IC_D19: U5.C15 (IO_L14P_T2_SRCC_15); also elsewhere on the board
MC_IC_D20: U5.D15 (IO_L19N_T3_VREF_15); also elsewhere on the board
MC_IC_D21: U5.E14 (IO_L19P_T3_15); also elsewhere on the board
MC_IC_D22: U5.E15 (IO_L21N_T3_DQS_15); also elsewhere on the board
MC_IC_D23: U5.F14 (IO_L21P_T3_DQS_15); also elsewhere on the board
MC_IC_D24: U5.F15 (IO_L20N_T3_15); also elsewhere on the board
MC_IC_D25: U5.G14 (IO_L22N_T3_15); also elsewhere on the board
MC_IC_D26: U5.G15 (IO_L20P_T3_15); also elsewhere on the board
MC_IC_D27: U5.J15 (IO_L5P_T0_D06_14); also elsewhere on the board
MC_IC_D28: U5.K14 (IO_L4P_T0_D04_14); also elsewhere on the board
MC_IC_D29: U5.K15 (IO_L5N_T0_D07_14); also elsewhere on the board
MC_IC_D30: U5.L14 (IO_L7N_T1_D10_14); also elsewhere on the board
MC_IC_D31: U5.L15 (IO_L4N_T0_D05_14); also elsewhere on the board
MC_IC_D32: U5.M14 (IO_L9P_T1_DQS_14); also elsewhere on the board
MC_IC_D33: U5.M15 (IO_L9N_T1_DQS_D13_14); also elsewhere on the board
MC_IC_D34: U5.N14 (IO_L10P_T1_D14_14); also elsewhere on the board
MC_IC_D35: U5.N15 (IO_L10N_T1_D15_14); also elsewhere on the board
MC_IC_D36: U5.P15 (IO_L11N_T1_SRCC_14); also elsewhere on the board
MC_IC_D37: U5.P14 (IO_L11P_T1_SRCC_14); also elsewhere on the board
MC_IC_D38: U5.C6 (IO_L1P_T0_AD0P_15); also elsewhere on the board
MC_IC_D39: U5.D7 (IO_L2P_T0_AD8P_15); also elsewhere on the board
MC_IC_D40: U5.C7 (IO_L1N_T0_AD0N_15); also elsewhere on the board
MC_IC_D41: U5.D8 (IO_L2N_T0_AD8N_15); also elsewhere on the board
MC_IC_D42: U5.C8 (IO_L4P_T0_AD9P_15); also elsewhere on the board
MC_IC_D43: U5.D9 (IO_L7P_T1_AD10P_15); also elsewhere on the board
MC_IC_D44: U5.C9 (IO_L4N_T0_AD9N_15); also elsewhere on the board
MC_IC_D45: U5.D10 (IO_L7N_T1_AD10N_15); also elsewhere on the board
MC_IC_D46: U5.C10 (IO_L8P_T1_AD3P_15); also elsewhere on the board
MC_IC_D47: U5.D11 (IO_0_15); also elsewhere on the board
MC_IC_D48: U5.D12 (IO_L16P_T2_15); also elsewhere on the board
MC_IC_D49: U5.D13 (IO_L16N_T2_15); also elsewhere on the board
MC_IC_D50: U5.E12 (IO_L18P_T2_15); also elsewhere on the board
MC_IC_D51: U5.E13 (IO_L18N_T2_15); also elsewhere on the board
MC_IC_D52: U5.G12 (IO_L23N_T3_15); also elsewhere on the board
MC_IC_D53: U5.G13 (IO_L22P_T3_15); also elsewhere on the board
MC_IC_D54: U5.H12 (IO_L24P_T3_RS1_15); also elsewhere on the board
MC_IC_D55: U5.H13 (IO_L24N_T3_RS0_15); also elsewhere on the board
MC_IC_D56: U5.K12 (IO_L3N_T0_DQS_EMCCLK_14); also elsewhere on the board
MC_IC_D57: U5.L12 (IO_L6N_T0_D08_VREF_14); also elsewhere on the board
MC_IC_D58: U5.L13 (IO_L7P_T1_D09_14); also elsewhere on the board
MC_IC_D59: U5.M13 (IO_L8P_T1_D11_14); also elsewhere on the board
MC_IC_D60: U5.N12 (IO_L14P_T2_SRCC_14); also elsewhere on the board
MC_IC_D61: U5.N13 (IO_L8N_T1_D12_14); also elsewhere on the board
MC_IC_D62: U5.N11 (IO_L15N_T2_DQS_DOUT_CSO_B_14); also elsewhere on the board
MC_IC_D63: U5.N10 (IO_L15P_T2_DQS_RDWR_B_14); also elsewhere on the board
PWREN_B: U5.J4 (IO_L15P_T2_DQS_34); also elsewhere on the board
SUSPEND_B: U5.P1 (IO_L22P_T3_34); also elsewhere on the board
