SHAMIKO-project/SHAMIKO-board/hardware/shamiko.kicad_pcb

## KiCad design hardware/shamiko.kicad_pcb (continued)

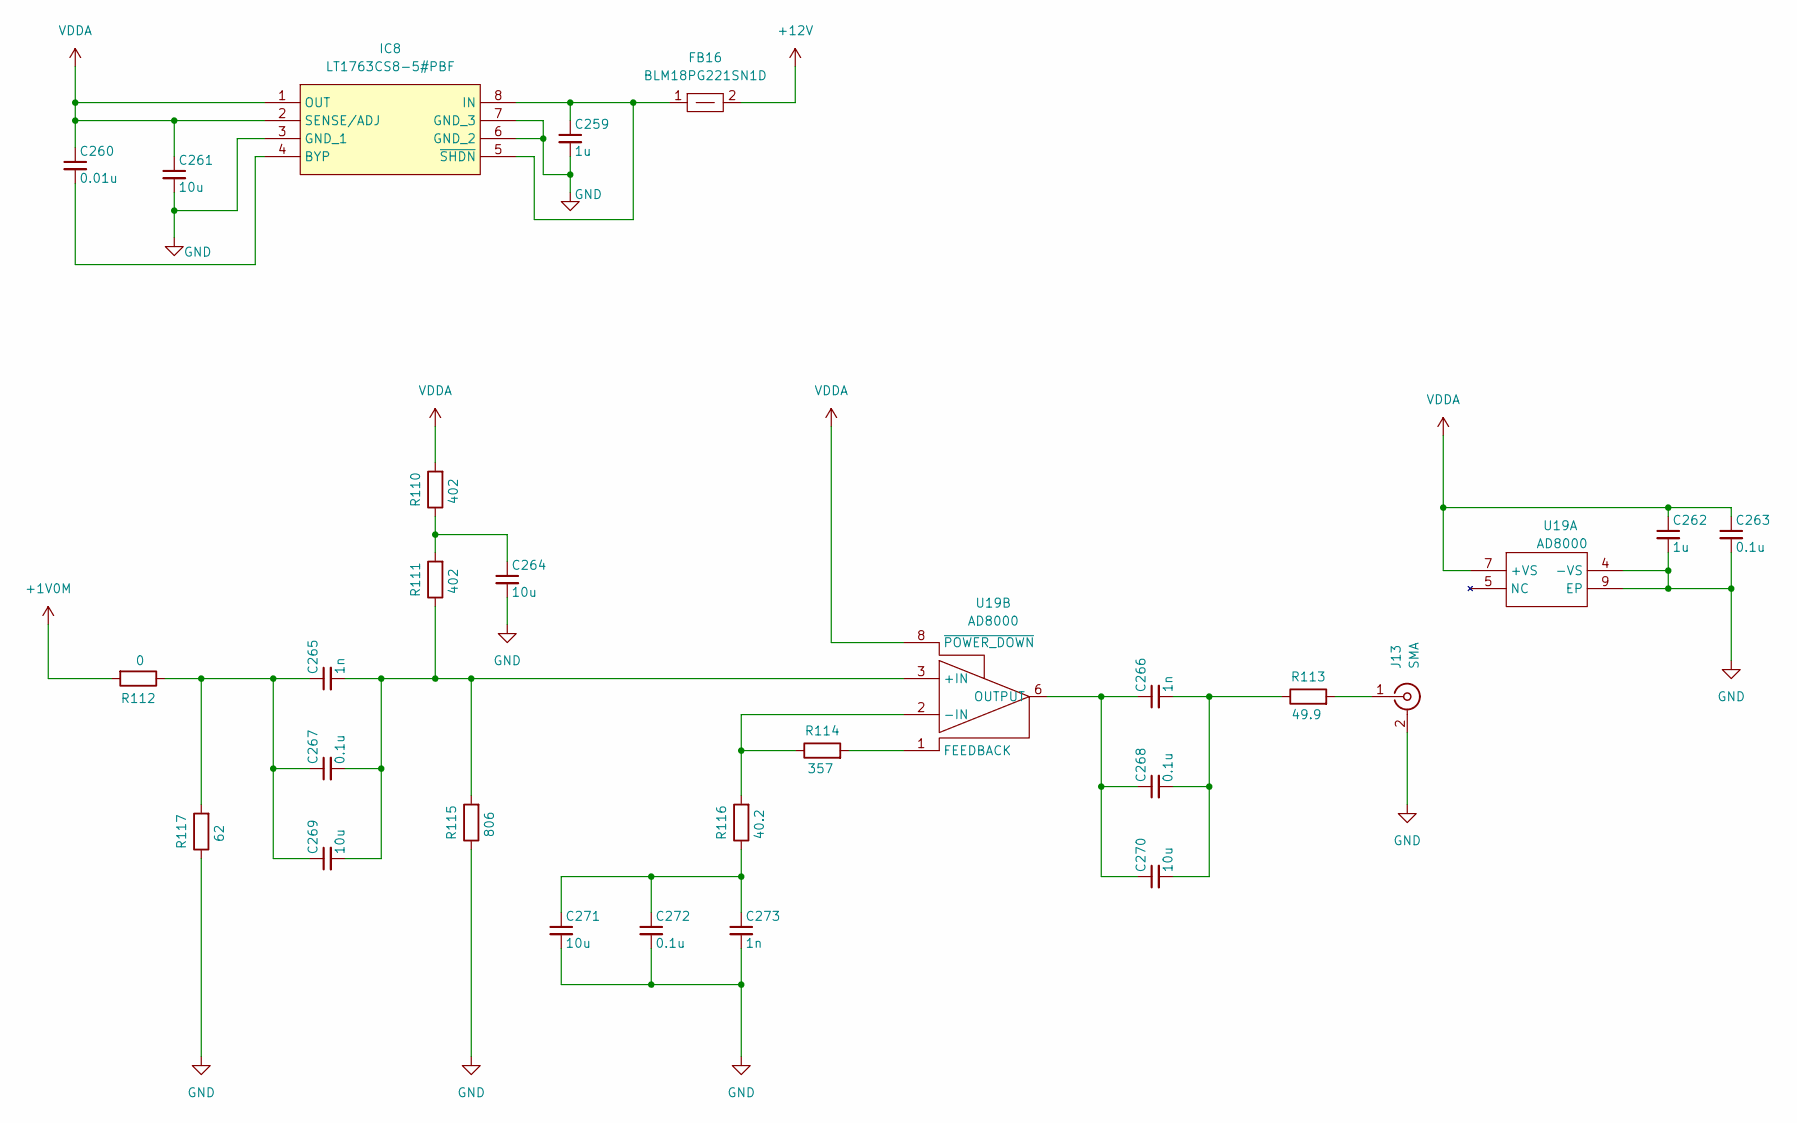
[picture p41: schematic CurrentSensAmplifer.kicad_sch]

Parts:
C259: 1u; C_0805_2012Metric; LCSC C126592
C260: 0.01u; C_0603_1608Metric; LCSC C85973
C261: 10u; C_0805_2012Metric; LCSC C126586
C262: 1u; C_0603_1608Metric; LCSC C77386
C263, C267, C268, C272: 0.1u; C_0603_1608Metric; LCSC C77055
C264, C269, C270, C271: 10u; C_0805_2012Metric; LCSC C440198
C265, C266, C273: 1n; C_0603_1608Metric; LCSC C77026
FB16: BLM18PG221SN1D; BLM18SP221SN1B; LCSC C80165
IC8: LT1763CS8-5#PBF; SSOP-8_3.95x5.21x3.27mm_P1.27mm; LCSC C117275
J13: SMA; SMA_Amphenol_132134-14_Vertical; LCSC C3174425
R110, R111: 402; R_0603_1608Metric; LCSC C666875
R112: 0; R_0603_1608Metric; LCSC C100044
R113: 49.9; R_0603_1608Metric; LCSC C861434
R114: 357; R_0603_1608Metric; LCSC C23028
R115: 806; R_0603_1608Metric; LCSC C2692785
R116: 40.2; R_0603_1608Metric; LCSC C2999484
R117: 62; R_1210_3225Metric; LCSC C230313
U19: AD8000; AD8000YRDZ; LCSC C652140

Connections:
+1V0M: R112.2; also elsewhere on the board
+12V: FB16.2; also elsewhere on the board
GND: C259.2, C261.2, C262.2, C263.2, C264.2, C271.2, C272.2, C273.2, IC8.3 (GND_1), IC8.6 (GND_2), IC8.7 (GND_3), J13.2 (Ext), R115.1, R117.1, U19.4 (-VS), U19.9 (EP); also elsewhere on the board
unnamed: C264.1, R110.1, R111.2
unnamed: C265.1, C267.1, C269.1, R112.1, R117.2
unnamed: C266.2, C268.2, C270.2, R113.1
unnamed: C271.1, C272.1, C273.1, R116.1
unnamed: C260.2, IC8.4 (BYP)
unnamed: C259.1, FB16.1, IC8.5 (~SHDN), IC8.8 (IN)
unnamed: J13.1 (In), R113.2
unnamed: C265.2, C267.2, C269.2, R111.1, R115.2, U19.3 (+IN)
unnamed: R114.1, R116.2, U19.2 (-IN)
unnamed: R114.2, U19.1 (FEEDBACK)
unnamed: C266.1, C268.1, C270.1, U19.6 (OUTPUT)
VDDA: C260.1, C261.1, C262.1, C263.1, IC8.1 (OUT), IC8.2 (SENSE/ADJ), R110.2, U19.7 (+VS), U19.8 (~POWER_DOWN)

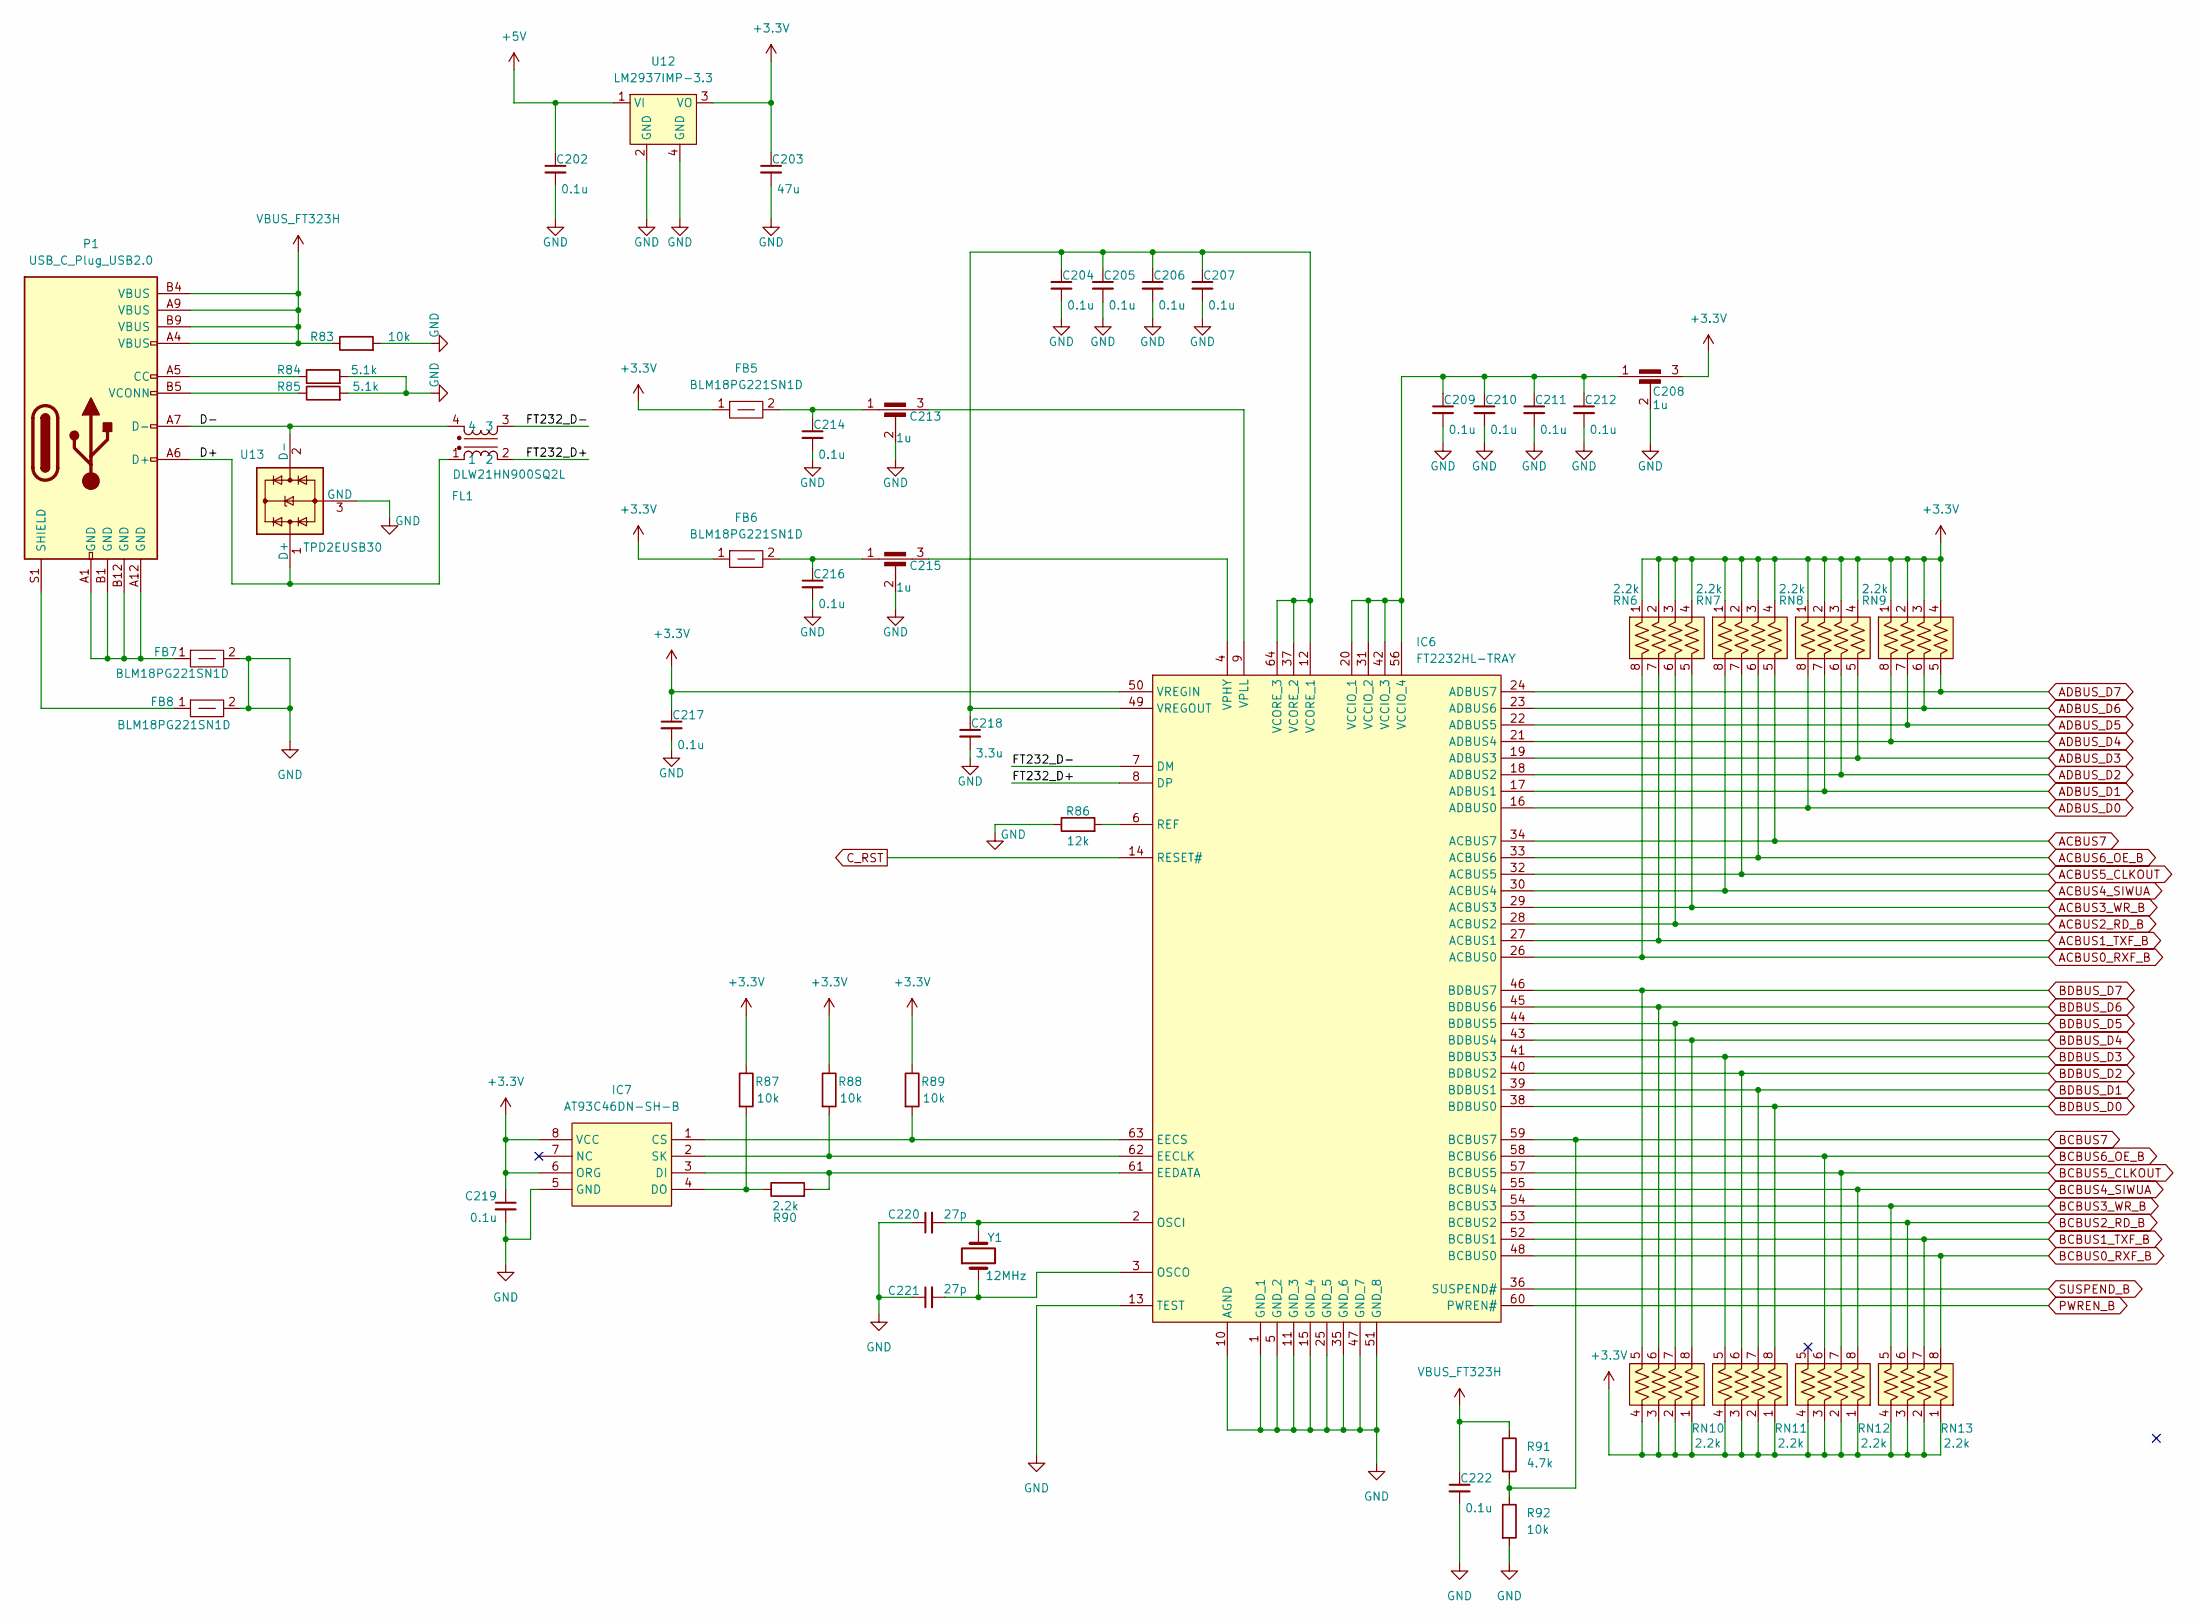
[picture p42: schematic FT2232HL.kicad_sch]

Parts:
C202, C204, C205, C206, C207, C209, C210, C211, C212, C214, C216, C217, C219, C222: 0.1u; C_0603_1608Metric; LCSC C77055
C203: 47u; C_0805_2012Metric; LCSC C76636
C208, C213, C215: 1u; NFM31HK103R1H3L; LCSC C92518
C218: 3.3u; C_0603_1608Metric; LCSC C5360803
C220, C221: 27p; C_0603_1608Metric; LCSC C107045
FB5, FB6, FB7, FB8: BLM18PG221SN1D; BLM18SP221SN1B; LCSC C80165
FL1: DLW21HN900SQ2L; LCSC C80529
IC6: FT2232HL-TRAY; LQFP-64_10x10mm_P0.5mm; LCSC C27882
IC7: AT93C46DN-SH-B; SSOP-8_3.9x5.05mm_P1.27mm; LCSC C6499
P1: USB_C_Plug_USB2.0; USB_C_Receptacle_G-Switch_GT-USB-7010ASV; LCSC C2988369
R83, R87, R88, R89, R92: 10k; R_0603_1608Metric; LCSC C95204
R84, R85: 5.1k; R_0603_1608Metric; LCSC C23186
R86: 12k; R_0603_1608Metric; LCSC C705807
R90: 2.2k; R_0603_1608Metric; LCSC C114662
R91: 4.7k; R_0603_1608Metric; LCSC C99782
RN6, RN7, RN8, RN9, RN10, RN11, RN12, RN13: 2.2k; YAGEO_R_network; LCSC C136829
U12: LM2937IMP-3.3; SOT-223; LCSC C140265
U13: TPD2EUSB30; Texas_DRT-3; LCSC C97502
Y1: 12MHz; Crystal_SMD_5032-2Pin_5.0x3.2mm; LCSC C112573

Connections:
+3.3V: C203.1, C208.3, C217.1, C219.1, FB5.1, FB6.1, IC6.50 (VREGIN), IC7.6 (ORG), IC7.8 (VCC), R87.1, R88.1, R89.1, RN6.1, RN6.2, RN6.3, RN6.4, RN7.1, RN7.2, RN7.3, RN7.4, RN8.1, RN8.2, RN8.3, RN8.4, RN9.1, RN9.2, RN9.3, RN9.4, RN10.1, RN10.2, RN10.3, RN10.4, RN11.1, RN11.2, RN11.3, RN11.4, RN12.1, RN12.2, RN12.3, RN12.4, RN13.1, RN13.2, RN13.3, RN13.4, U12.3 (VO); also elsewhere on the board
+5V: C202.1, U12.1 (VI); also elsewhere on the board
/FT2232HL/D+: FL1.1, P1.A6 (D+), U13.1 (D+)
/FT2232HL/D-: FL1.4, P1.A7 (D-), U13.2 (D-)
/FT2232HL/FT232_D+: FL1.2, IC6.8 (DP)
/FT2232HL/FT232_D-: FL1.3, IC6.7 (DM)
ACBUS0_RXF_B: IC6.26 (ACBUS0), RN6.8; also elsewhere on the board
ACBUS1_TXF_B: IC6.27 (ACBUS1), RN6.7; also elsewhere on the board
ACBUS2_RD_B: IC6.28 (ACBUS2), RN6.6; also elsewhere on the board
ACBUS3_WR_B: IC6.29 (ACBUS3), RN6.5; also elsewhere on the board
ACBUS4_SIWUA: IC6.30 (ACBUS4), RN7.8; also elsewhere on the board
ACBUS5_CLKOUT: IC6.32 (ACBUS5), RN7.7; also elsewhere on the board
ACBUS6_OE_B: IC6.33 (ACBUS6), RN7.6; also elsewhere on the board
ACBUS7: IC6.34 (ACBUS7), RN7.5; also elsewhere on the board
ADBUS_D0: IC6.16 (ADBUS0), RN8.8; also elsewhere on the board
ADBUS_D1: IC6.17 (ADBUS1), RN8.7; also elsewhere on the board
ADBUS_D2: IC6.18 (ADBUS2), RN8.6; also elsewhere on the board
ADBUS_D3: IC6.19 (ADBUS3), RN8.5; also elsewhere on the board
ADBUS_D4: IC6.21 (ADBUS4), RN9.8; also elsewhere on the board
ADBUS_D5: IC6.22 (ADBUS5), RN9.7; also elsewhere on the board
ADBUS_D6: IC6.23 (ADBUS6), RN9.6; also elsewhere on the board
ADBUS_D7: IC6.24 (ADBUS7), RN9.5; also elsewhere on the board
BCBUS0_RXF_B: IC6.48 (BCBUS0), RN13.8; also elsewhere on the board
BCBUS1_TXF_B: IC6.52 (BCBUS1), RN13.7; also elsewhere on the board
BCBUS2_RD_B: IC6.53 (BCBUS2), RN13.6; also elsewhere on the board
BCBUS3_WR_B: IC6.54 (BCBUS3), RN13.5; also elsewhere on the board
BCBUS4_SIWUA: IC6.55 (BCBUS4), RN12.8; also elsewhere on the board
BCBUS5_CLKOUT: IC6.57 (BCBUS5), RN12.7; also elsewhere on the board
BCBUS6_OE_B: IC6.58 (BCBUS6), RN12.6; also elsewhere on the board
BCBUS7: IC6.59 (BCBUS7), R91.2, R92.1; also elsewhere on the board
BDBUS_D0: IC6.38 (BDBUS0), RN11.8; also elsewhere on the board
BDBUS_D1: IC6.39 (BDBUS1), RN11.7; also elsewhere on the board
BDBUS_D2: IC6.40 (BDBUS2), RN11.6; also elsewhere on the board
BDBUS_D3: IC6.41 (BDBUS3), RN11.5; also elsewhere on the board
BDBUS_D4: IC6.43 (BDBUS4), RN10.8; also elsewhere on the board
BDBUS_D5: IC6.44 (BDBUS5), RN10.7; also elsewhere on the board
BDBUS_D6: IC6.45 (BDBUS6), RN10.6; also elsewhere on the board
BDBUS_D7: IC6.46 (BDBUS7), RN10.5; also elsewhere on the board
C_RST: IC6.14 (RESET#); also elsewhere on the board
GND: C202.2, C203.2, C204.2, C205.2, C206.2, C207.2, C208.2, C209.2, C210.2, C211.2, C212.2, C213.2, C214.2, C215.2, C216.2, C217.2, C218.2, C219.2, C220.1, C221.1, C222.2, FB7.2, FB8.2, IC6.1 (GND_1), IC6.5 (GND_2), IC6.10 (AGND), IC6.11 (GND_3), IC6.13 (TEST), IC6.15 (GND_4), IC6.25 (GND_5), IC6.35 (GND_6), IC6.47 (GND_7), IC6.51 (GND_8), IC7.5 (GND), R83.2, R84.2, R85.2, R86.1, R92.2, U12.2 (GND), U12.4 (GND), U13.3 (GND); also elsewhere on the board
unnamed: C213.1, C214.1, FB5.2
unnamed: C215.1, C216.1, FB6.2
unnamed: FB7.1, P1.A1 (GND), P1.A12 (GND), P1.B1 (GND), P1.B12 (GND)
unnamed: IC6.62 (EECLK), IC7.2 (SK), R88.2
unnamed: IC6.63 (EECS), IC7.1 (CS), R89.2
unnamed: IC6.61 (EEDATA), IC7.3 (DI), R90.2
unnamed: C220.2, IC6.2 (OSCI), Y1.2
unnamed: C221.2, IC6.3 (OSCO), Y1.1
unnamed: IC6.6 (REF), R86.2
unnamed: C208.1, C209.1, C210.1, C211.1, C212.1, IC6.20 (VCCIO_1), IC6.31 (VCCIO_2), IC6.42 (VCCIO_3), IC6.56 (VCCIO_4)
unnamed: C204.1, C205.1, C206.1, C207.1, C218.1, IC6.12 (VCORE_1), IC6.37 (VCORE_2), IC6.49 (VREGOUT), IC6.64 (VCORE_3)
unnamed: C215.3, IC6.4 (VPHY)
unnamed: C213.3, IC6.9 (VPLL)
unnamed: IC7.4 (DO), R87.2, R90.1
unnamed: P1.A5 (CC), R84.1
unnamed: FB8.1, P1.S1 (SHIELD)
unnamed: P1.B5 (VCONN), R85.1
PWREN_B: IC6.60 (PWREN#); also elsewhere on the board
SUSPEND_B: IC6.36 (SUSPEND#); also elsewhere on the board
VBUS_FT323H: C222.1, P1.A4 (VBUS), P1.A9 (VBUS), P1.B4 (VBUS), P1.B9 (VBUS), R83.1, R91.1

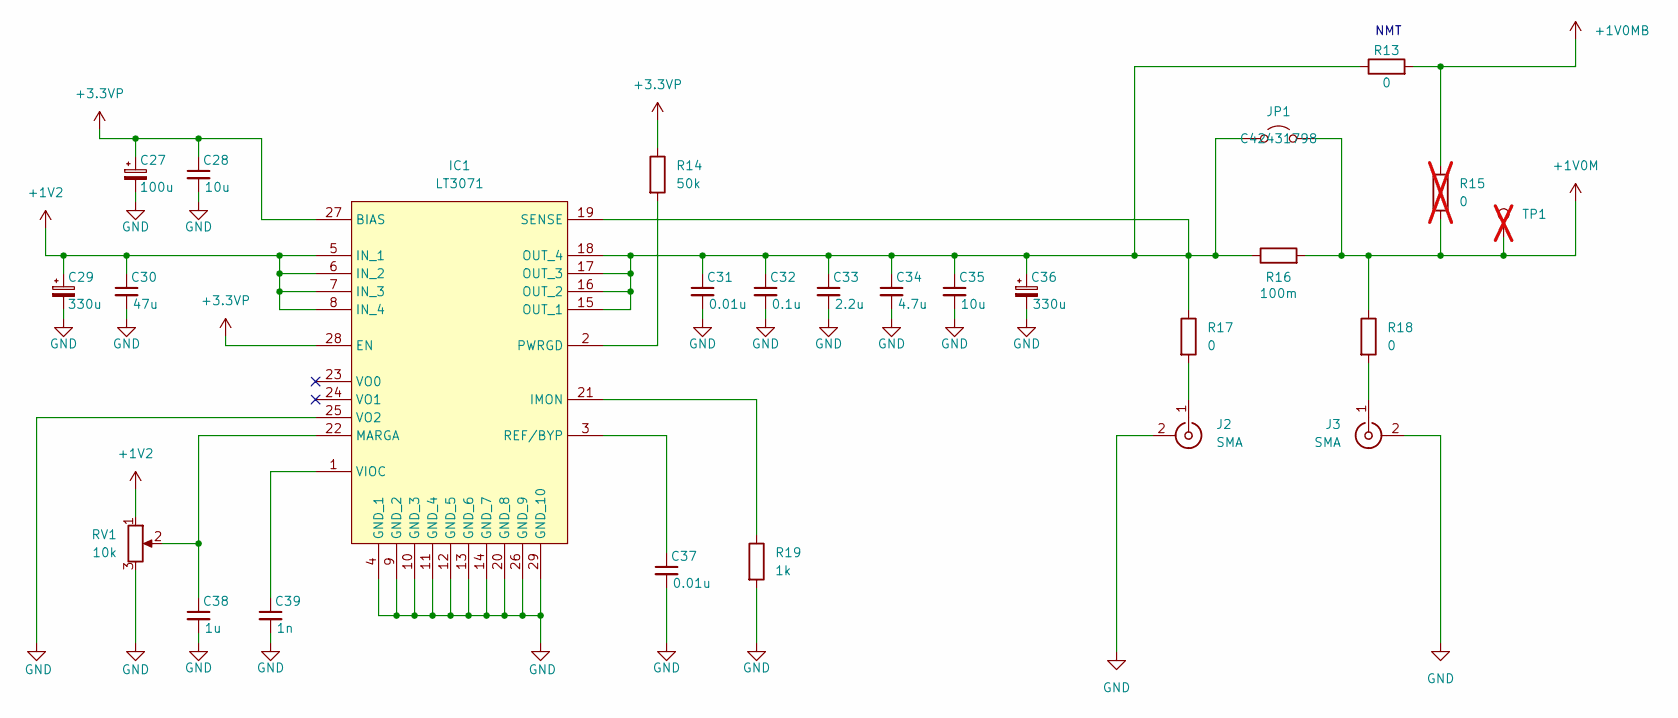
[picture p43: schematic Power(VCC1V0M).kicad_sch]

Parts:
C27: 100u; CP_Elec_6.3x7.7; LCSC C48587228
C28, C35: 10u; C_0805_2012Metric; LCSC C440198
C29, C36: 330u; CP_Elec_6.3x7.7; LCSC C48587229
C30: 47u; C_0805_2012Metric; LCSC C124129
C31, C37: 0.01u; C_0603_1608Metric; LCSC C85973
C32: 0.1u; C_0603_1608Metric; LCSC C77055
C33: 2.2u; C_0805_2012Metric; LCSC C117966
C34: 4.7u; C_0805_2012Metric; LCSC C408144
C38: 1u; C_0603_1608Metric; LCSC C77386
C39: 1n; C_0603_1608Metric; LCSC C77026
IC1: LT3071; LT3071EUFD#PBF; LCSC C117304
J2, J3: SMA; SMA_Amphenol_132134-14_Vertical; LCSC C3174425
JP1: Jumper_2_Open; PinHeader_1x02_P2.54mm_Vertical; LCSC C42431798
R13: 0; R_2512_6332Metric_Pad1.40x3.35mm_HandSolder; LCSC C5204052
R14: 50k; R_0603_1608Metric; LCSC C861451
R15: 0; R_2512_6332Metric; LCSC C5204052; not fitted
R16: 100m; R_2512_6332Metric_Pad1.40x3.35mm_HandSolder; LCSC C840616
R17, R18: 0; R_1206_3216Metric; LCSC C137394
R19: 1k; R_0603_1608Metric; LCSC C22548
RV1: 10k; Potentiometer_Bourns_3296W_Vertical; LCSC C34846
TP1: TestPoint; TestPoint_Pad_D1.0mm; LCSC None; not fitted

Connections:
+1V0M: JP1.2 (B), R15.2, R16.2, R18.1, TP1.1; also elsewhere on the board
+1V0MB: R13.2, R15.1; also elsewhere on the board
+1V2: C29.1, C30.1, IC1.5 (IN_1), IC1.6 (IN_2), IC1.7 (IN_3), IC1.8 (IN_4), RV1.1; also elsewhere on the board
+3.3VP: C27.1, C28.1, IC1.27 (BIAS), IC1.28 (EN), R14.1; also elsewhere on the board
GND: C27.2, C28.2, C29.2, C30.2, C31.2, C32.2, C33.2, C34.2, C35.2, C36.2, C37.2, C38.2, C39.2, IC1.4 (GND_1), IC1.9 (GND_2), IC1.10 (GND_3), IC1.11 (GND_4), IC1.12 (GND_5), IC1.13 (GND_6), IC1.14 (GND_7), IC1.20 (GND_8), IC1.25 (VO2), IC1.26 (GND_9), IC1.29 (GND_10), J2.2 (Ext), J3.2 (Ext), R19.2, RV1.3; also elsewhere on the board
unnamed: IC1.21 (IMON), R19.1
unnamed: C38.1, IC1.22 (MARGA), RV1.2
unnamed: C31.1, C32.1, C33.1, C34.1, C35.1, C36.1, IC1.15 (OUT_1), IC1.16 (OUT_2), IC1.17 (OUT_3), IC1.18 (OUT_4), IC1.19 (SENSE), JP1.1 (A), R13.1, R16.1, R17.1
unnamed: IC1.2 (PWRGD), R14.2
unnamed: C37.1, IC1.3 (REF/BYP)
unnamed: C39.1, IC1.1 (VIOC)
unnamed: J2.1 (In), R17.2
unnamed: J3.1 (In), R18.2

Notes on the sheet:
NMT

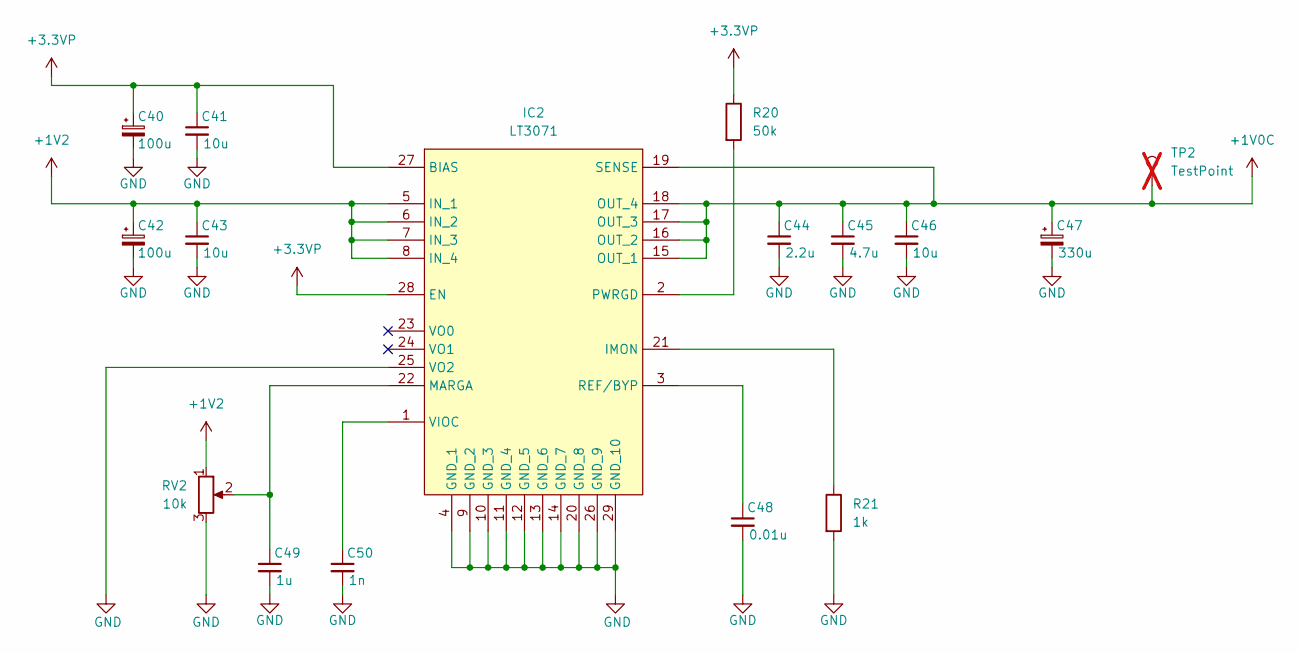
[picture p44: schematic Power(VCC1V0C).kicad_sch]

Parts:
C40, C42: 100u; CP_Elec_6.3x7.7; LCSC C48587228
C41, C43, C46: 10u; C_0805_2012Metric; LCSC C440198
C44: 2.2u; C_0603_1608Metric; LCSC C77047
C45: 4.7u; C_0603_1608Metric; LCSC C90057
C47: 330u; CP_Elec_6.3x7.7; LCSC C48587229
C48: 0.01u; C_0603_1608Metric; LCSC C85973
C49: 1u; C_0603_1608Metric; LCSC C77386
C50: 1n; C_0603_1608Metric; LCSC C77026
IC2: LT3071; LT3071EUFD#PBF; LCSC C117304
R20: 50k; R_0603_1608Metric; LCSC C861451
R21: 1k; R_0603_1608Metric; LCSC C22548
RV2: 10k; Potentiometer_Bourns_3296W_Vertical; LCSC C34846
TP2: TestPoint; TestPoint_Pad_D1.0mm; LCSC None; not fitted

Connections:
+1V0C: C44.1, C45.1, C46.1, C47.1, IC2.15 (OUT_1), IC2.16 (OUT_2), IC2.17 (OUT_3), IC2.18 (OUT_4), IC2.19 (SENSE), TP2.1; also elsewhere on the board
+1V2: C42.1, C43.1, IC2.5 (IN_1), IC2.6 (IN_2), IC2.7 (IN_3), IC2.8 (IN_4), RV2.1; also elsewhere on the board
+3.3VP: C40.1, C41.1, IC2.27 (BIAS), IC2.28 (EN), R20.1; also elsewhere on the board
GND: C40.2, C41.2, C42.2, C43.2, C44.2, C45.2, C46.2, C47.2, C48.2, C49.2, C50.2, IC2.4 (GND_1), IC2.9 (GND_2), IC2.10 (GND_3), IC2.11 (GND_4), IC2.12 (GND_5), IC2.13 (GND_6), IC2.14 (GND_7), IC2.20 (GND_8), IC2.25 (VO2), IC2.26 (GND_9), IC2.29 (GND_10), R21.2, RV2.3; also elsewhere on the board
unnamed: IC2.21 (IMON), R21.1
unnamed: C49.1, IC2.22 (MARGA), RV2.2
unnamed: IC2.2 (PWRGD), R20.2
unnamed: C48.1, IC2.3 (REF/BYP)
unnamed: C50.1, IC2.1 (VIOC)

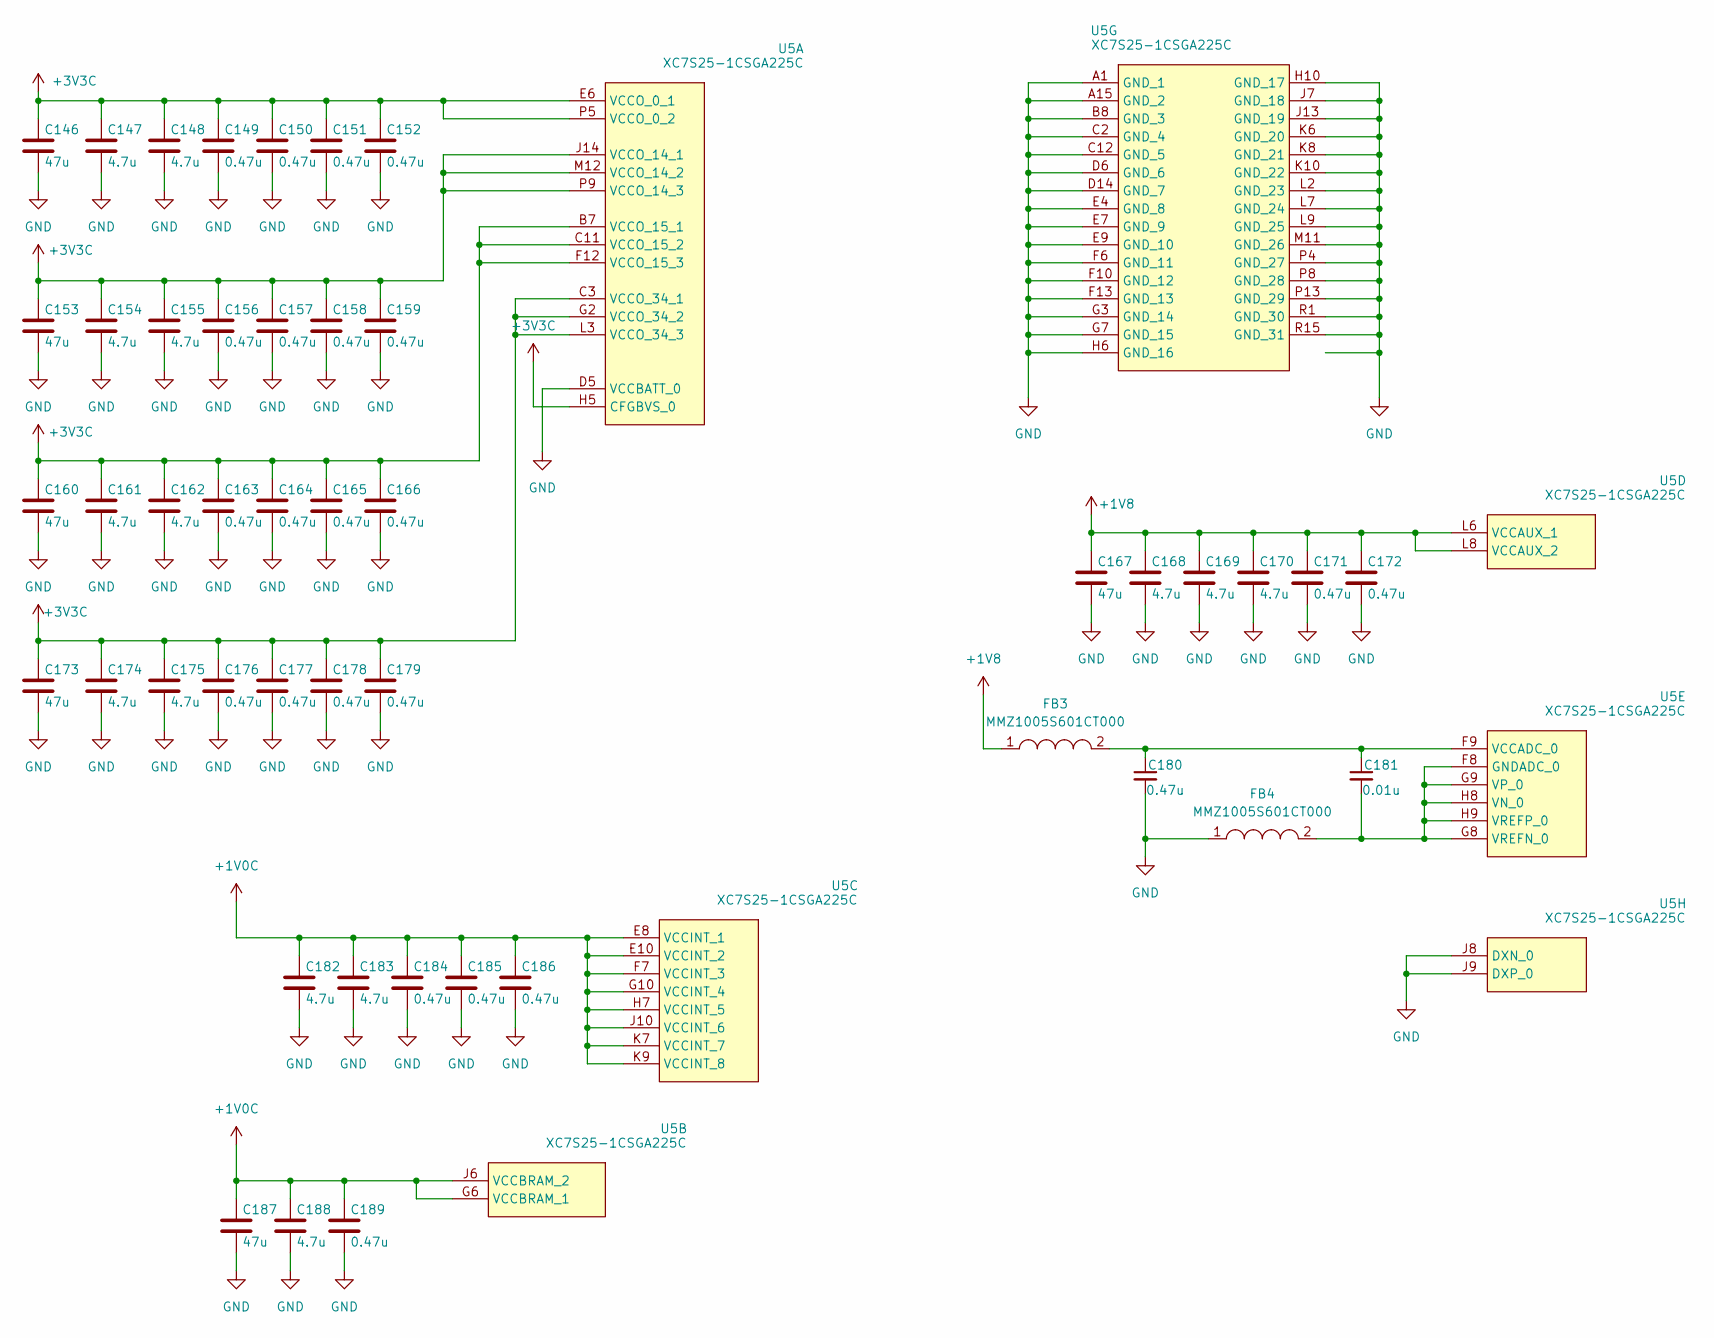
[picture p45: schematic ControllerFPGAPower.kicad_sch]

Parts:
C146, C153, C160, C167, C173, C187: 47u; C_0805_2012Metric; LCSC C124129
C147, C148, C154, C155, C161, C162, C168, C169, C170, C174, C175, C182, C183, C188: 4.7u; C_0603_1608Metric; LCSC C90057
C149, C150, C151, C152, C156, C157, C158, C159, C163, C164, C165, C166, C171, C172, C176, C177, C178, C179, C180, C184, C185, C186, C189: 0.47u; C_0402_1005Metric; LCSC C77003
C181: 0.01u; C_0402_1005Metric; LCSC C15195
FB3, FB4: MMZ1005S601CT000; LCSC C76804
U5: XC7S25-1CSGA225C; LCSC C1521699

Connections:
+1V0C: C182.1, C183.1, C184.1, C185.1, C186.1, C187.1, C188.1, C189.1, U5.E8 (VCCINT_1), U5.E10 (VCCINT_2), U5.F7 (VCCINT_3), U5.G6 (VCCBRAM_1), U5.G10 (VCCINT_4), U5.H7 (VCCINT_5), U5.J6 (VCCBRAM_2), U5.J10 (VCCINT_6), U5.K7 (VCCINT_7), U5.K9 (VCCINT_8); also elsewhere on the board
+1V8: C167.1, C168.1, C169.1, C170.1, C171.1, C172.1, FB3.1, U5.L6 (VCCAUX_1), U5.L8 (VCCAUX_2); also elsewhere on the board
+3V3C: C146.1, C147.1, C148.1, C149.1, C150.1, C151.1, C152.1, C153.1, C154.1, C155.1, C156.1, C157.1, C158.1, C159.1, C160.1, C161.1, C162.1, C163.1, C164.1, C165.1, C166.1, C173.1, C174.1, C175.1, C176.1, C177.1, C178.1, C179.1, U5.B7 (VCCO_15_1), U5.C3 (VCCO_34_1), U5.C11 (VCCO_15_2), U5.E6 (VCCO_0_1), U5.F12 (VCCO_15_3), U5.G2 (VCCO_34_2), U5.H5 (CFGBVS_0), U5.J14 (VCCO_14_1), U5.L3 (VCCO_34_3), U5.M12 (VCCO_14_2), U5.P5 (VCCO_0_2), U5.P9 (VCCO_14_3); also elsewhere on the board
GND: C146.2, C147.2, C148.2, C149.2, C150.2, C151.2, C152.2, C153.2, C154.2, C155.2, C156.2, C157.2, C158.2, C159.2, C160.2, C161.2, C162.2, C163.2, C164.2, C165.2, C166.2, C167.2, C168.2, C169.2, C170.2, C171.2, C172.2, C173.2, C174.2, C175.2, C176.2, C177.2, C178.2, C179.2, C180.2, C182.2, C183.2, C184.2, C185.2, C186.2, C187.2, C188.2, C189.2, FB4.1, U5.A1 (GND_1), U5.A15 (GND_2), U5.B8 (GND_3), U5.C2 (GND_4), U5.C12 (GND_5), U5.D5 (VCCBATT_0), U5.D6 (GND_6), U5.D14 (GND_7), U5.E4 (GND_8), U5.E7 (GND_9), U5.E9 (GND_10), U5.F6 (GND_11), U5.F10 (GND_12), U5.F13 (GND_13), U5.G3 (GND_14), U5.G7 (GND_15), U5.H6 (GND_16), U5.H10 (GND_17), U5.J7 (GND_18), U5.J8 (DXN_0), U5.J9 (DXP_0), U5.J13 (GND_19), U5.K6 (GND_20), U5.K8 (GND_21), U5.K10 (GND_22), U5.L2 (GND_23), U5.L7 (GND_24), U5.L9 (GND_25), U5.M11 (GND_26), U5.P4 (GND_27), U5.P8 (GND_28), U5.P13 (GND_29), U5.R1 (GND_30), U5.R15 (GND_31); also elsewhere on the board
unnamed: C181.2, FB4.2, U5.F8 (GNDADC_0), U5.G8 (VREFN_0), U5.G9 (VP_0), U5.H8 (VN_0), U5.H9 (VREFP_0)
unnamed: C180.1, C181.1, FB3.2, U5.F9 (VCCADC_0)

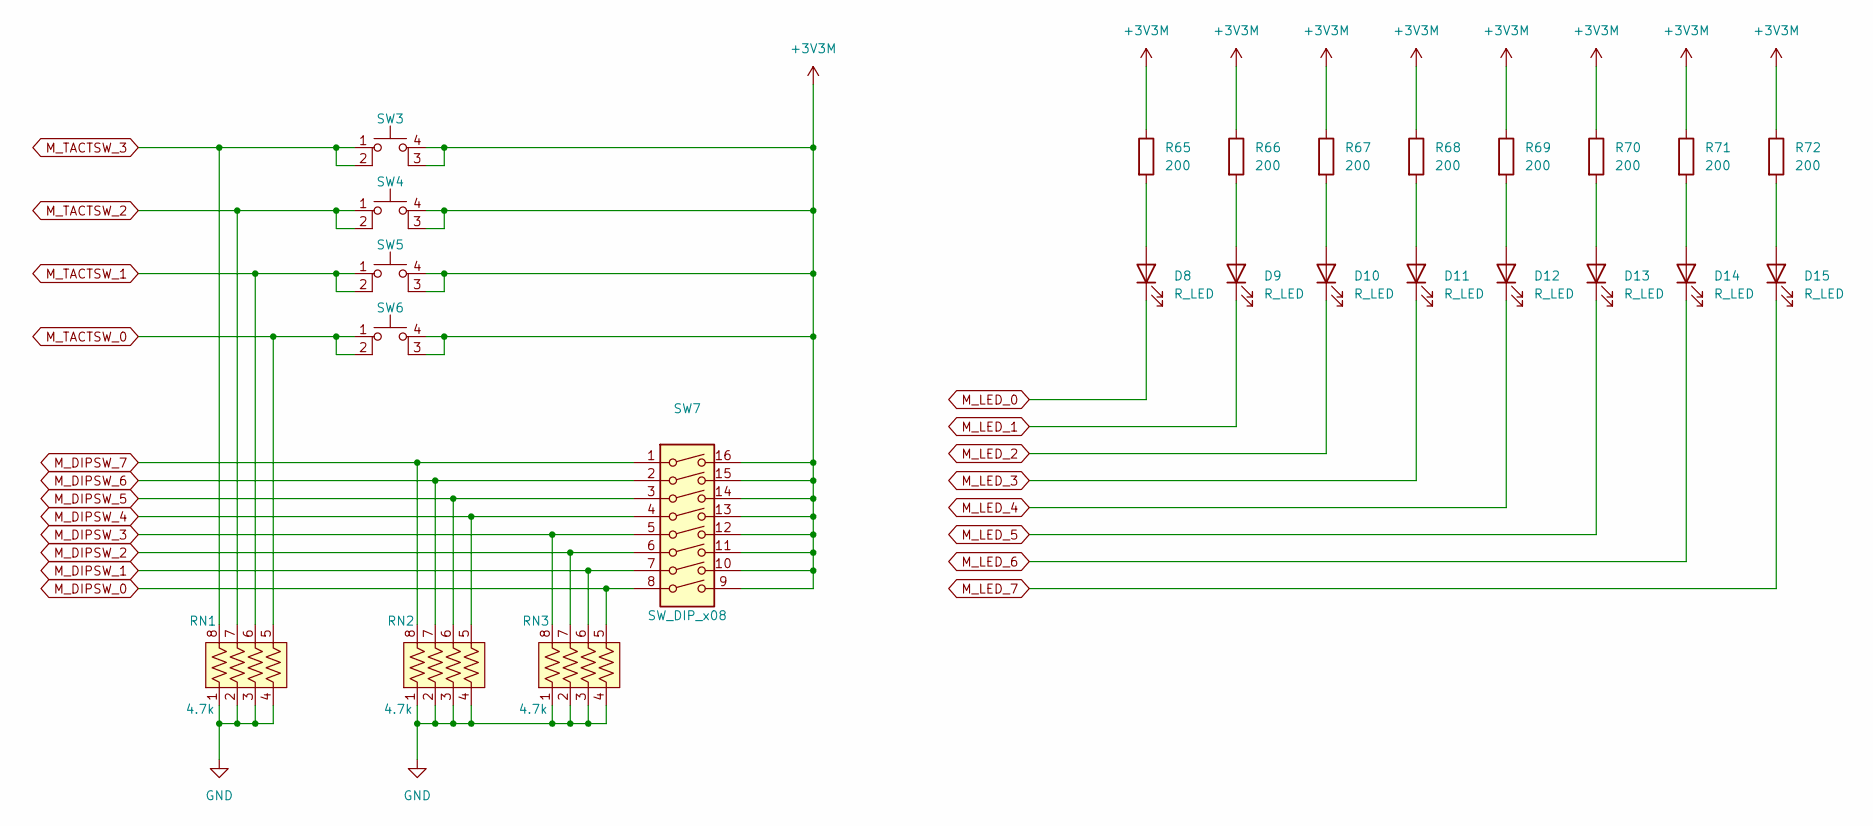
[picture p46: schematic MainFPGAPeripheral.kicad_sch]

Parts:
D8, D9, D10, D11, D12, D13, D14, D15: R_LED; LED_0603_1608Metric; LCSC C965798
R65, R66, R67, R68, R69, R70, R71, R72: 200; R_0603_1608Metric; LCSC C2907123
RN1, RN2, RN3: 4.7k; YAGEO_R_network; LCSC C327044
SW3, SW4, SW5, SW6: SW_MEC_5E; MySW_PUSH_6mm_H5mm; LCSC C393938
SW7: SW_DIP_x08; SW_DIP_SPSTx08_Slide_9.78x22.5mm_W8.61mm_P2.54mm; LCSC C2842674

Connections:
+3V3M: R65.1, R66.1, R67.1, R68.1, R69.1, R70.1, R71.1, R72.1, SW3.3 (K), SW3.4 (A), SW4.3 (K), SW4.4 (A), SW5.3 (K), SW5.4 (A), SW6.3 (K), SW6.4 (A), SW7.9, SW7.10, SW7.11, SW7.12, SW7.13, SW7.14, SW7.15, SW7.16; also elsewhere on the board
GND: RN1.1, RN1.2, RN1.3, RN1.4, RN2.1, RN2.2, RN2.3, RN2.4, RN3.1, RN3.2, RN3.3, RN3.4; also elsewhere on the board
M_DIPSW_0: RN3.5, SW7.8; also elsewhere on the board
M_DIPSW_1: RN3.6, SW7.7; also elsewhere on the board
M_DIPSW_2: RN3.7, SW7.6; also elsewhere on the board
M_DIPSW_3: RN3.8, SW7.5; also elsewhere on the board
M_DIPSW_4: RN2.5, SW7.4; also elsewhere on the board
M_DIPSW_5: RN2.6, SW7.3; also elsewhere on the board
M_DIPSW_6: RN2.7, SW7.2; also elsewhere on the board
M_DIPSW_7: RN2.8, SW7.1; also elsewhere on the board
M_LED_0: D8.1 (K); also elsewhere on the board
M_LED_1: D9.1 (K); also elsewhere on the board
M_LED_2: D10.1 (K); also elsewhere on the board
M_LED_3: D11.1 (K); also elsewhere on the board
M_LED_4: D12.1 (K); also elsewhere on the board
M_LED_5: D13.1 (K); also elsewhere on the board
M_LED_6: D14.1 (K); also elsewhere on the board
M_LED_7: D15.1 (K); also elsewhere on the board
M_TACTSW_0: RN1.5, SW6.1, SW6.2; also elsewhere on the board
M_TACTSW_1: RN1.6, SW5.1, SW5.2; also elsewhere on the board
M_TACTSW_2: RN1.7, SW4.1, SW4.2; also elsewhere on the board
M_TACTSW_3: RN1.8, SW3.1, SW3.2; also elsewhere on the board
unnamed: D8.2 (A), R65.2
unnamed: D9.2 (A), R66.2
unnamed: D10.2 (A), R67.2
unnamed: D11.2 (A), R68.2
unnamed: D12.2 (A), R69.2
unnamed: D13.2 (A), R70.2
unnamed: D14.2 (A), R71.2
unnamed: D15.2 (A), R72.2
