SHAMIKO-project/SHAMIKO-board/hardware/shamiko.kicad_pcb

## KiCad design hardware/shamiko.kicad_pcb (continued)

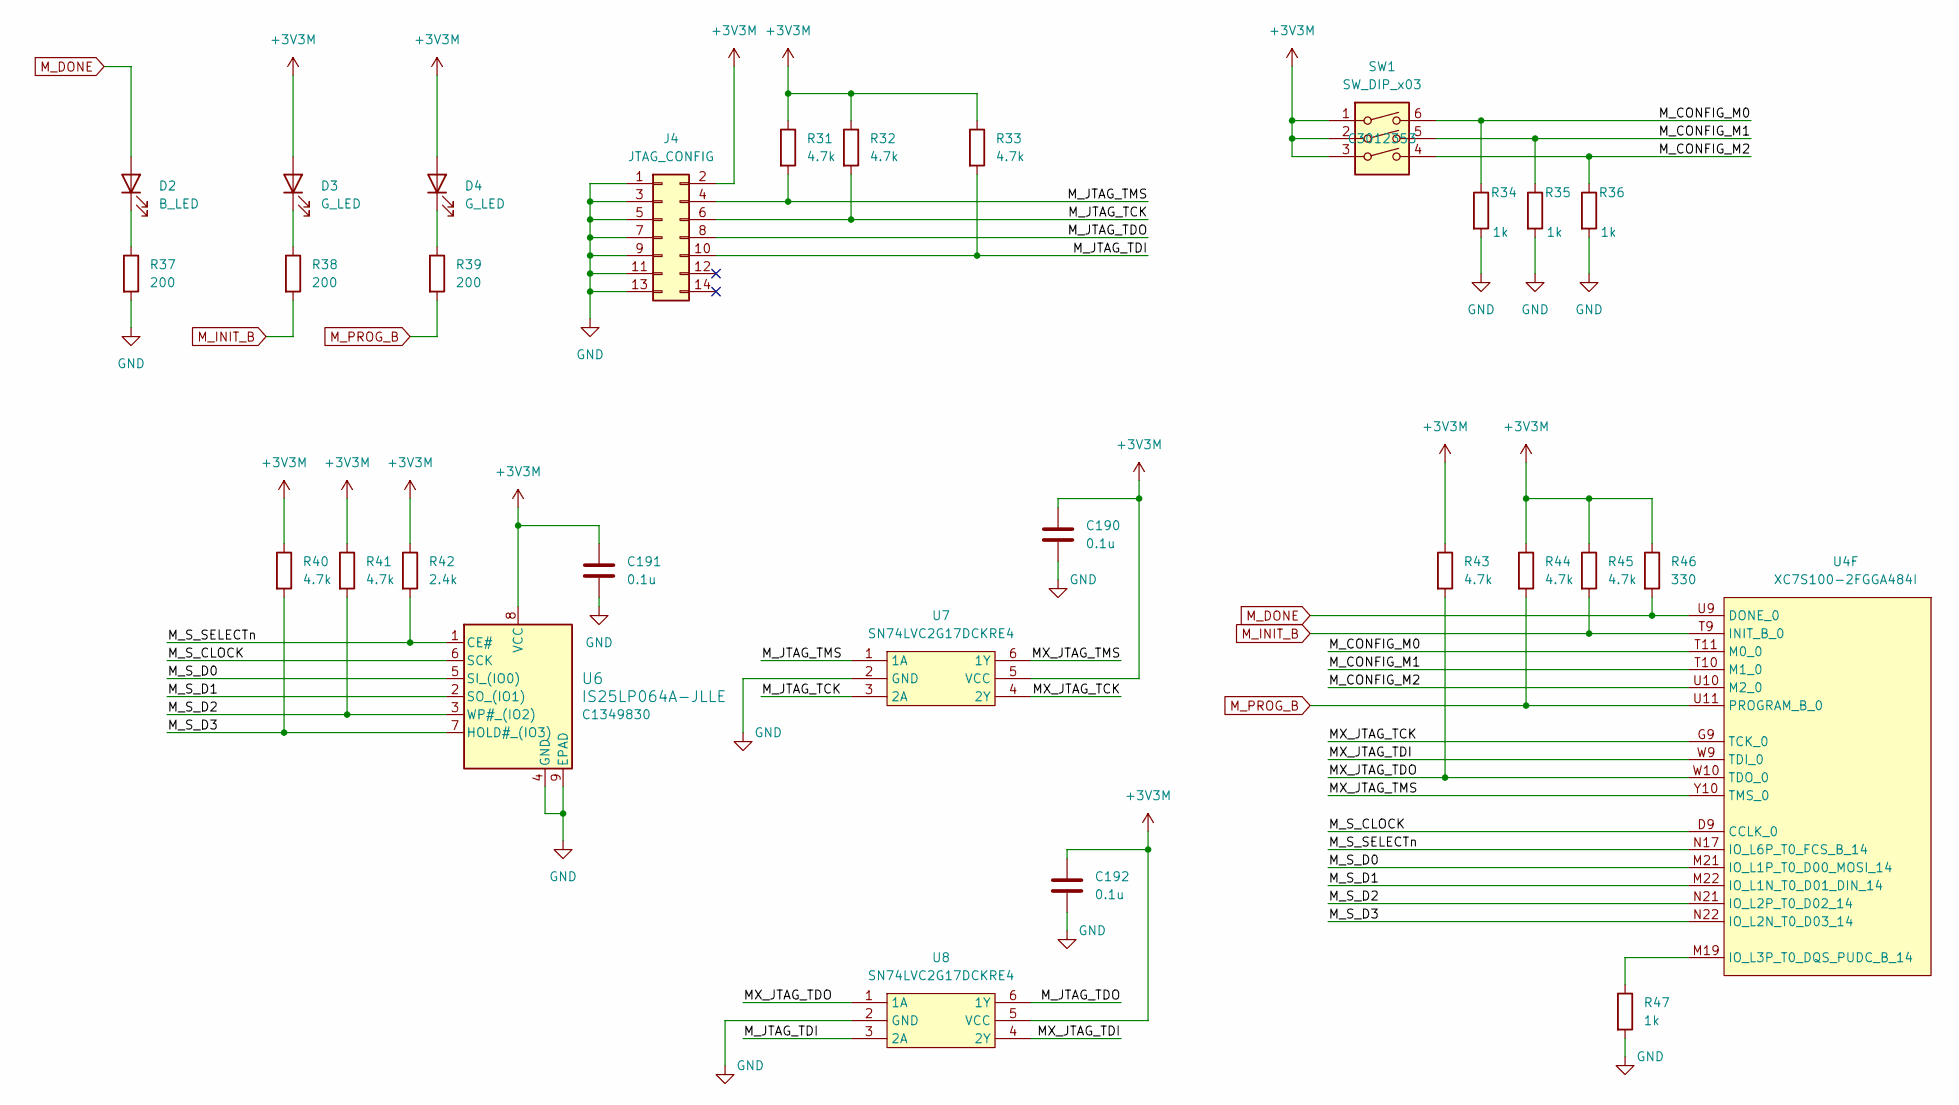
[picture p47: schematic MainFPGAConfig.kicad_sch]

Parts:
C190, C191, C192: 0.1u; C_0603_1608Metric; LCSC C77055
D2: B_LED; LED_0603_1608Metric; LCSC C19171394
D3, D4: G_LED; LED_0603_1608Metric; LCSC C5342733
J4: JTAG_CONFIG; JTAG_2x7_P2.54mm; LCSC C240854
R31, R32, R33, R40, R41, R43, R44, R45: 4.7k; R_0603_1608Metric; LCSC C99782
R34, R35, R36, R47: 1k; R_0603_1608Metric; LCSC C22548
R37, R38, R39: 200; R_0603_1608Metric; LCSC C2907123
R42: 2.4k; R_0603_1608Metric; LCSC C22940
R46: 330; R_0603_1608Metric; LCSC C105881
SW1: SW_DIP_x03; SW_DIP_SPSTx03_Slide_9.78x9.8mm_W8.61mm_P2.54mm; LCSC C3012353
U4: XC7S100-2FGGA484I; Xilinx_FBG484; LCSC C1521770
U6: IS25LP064A-JLLE; WSON-8-1EP_8x6mm_P1.27mm_EP3.4x4.3mm; LCSC C1349830
U7, U8: SN74LVC2G17DCKRE4; LCSC C50714

Connections:
+3V3M: C190.1, C191.1, C192.1, D3.2 (A), D4.2 (A), J4.2, R31.1, R32.1, R33.1, R40.1, R41.1, R42.1, R43.1, R44.1, R45.1, R46.1, SW1.1, SW1.2, SW1.3, U6.8 (VCC), U7.5 (VCC), U8.5 (VCC); also elsewhere on the board
/Main FPGA Configuration/MX_JTAG_TCK: U4.G9 (TCK_0), U7.4 (2Y)
/Main FPGA Configuration/MX_JTAG_TDI: U4.W9 (TDI_0), U8.4 (2Y)
/Main FPGA Configuration/MX_JTAG_TDO: R43.2, U4.W10 (TDO_0), U8.1 (1A)
/Main FPGA Configuration/MX_JTAG_TMS: U4.Y10 (TMS_0), U7.6 (1Y)
/Main FPGA Configuration/M_CONFIG_M0: R34.1, SW1.6, U4.T11 (M0_0)
/Main FPGA Configuration/M_CONFIG_M1: R35.1, SW1.5, U4.T10 (M1_0)
/Main FPGA Configuration/M_CONFIG_M2: R36.1, SW1.4, U4.U10 (M2_0)
/Main FPGA Configuration/M_JTAG_TCK: J4.6, R32.2, U7.3 (2A)
/Main FPGA Configuration/M_JTAG_TDI: J4.10, R33.2, U8.3 (2A)
/Main FPGA Configuration/M_JTAG_TDO: J4.8, U8.6 (1Y)
/Main FPGA Configuration/M_JTAG_TMS: J4.4, R31.2, U7.1 (1A)
/Main FPGA Configuration/M_S_CLOCK: U4.D9 (CCLK_0), U6.6 (SCK)
/Main FPGA Configuration/M_S_D0: U4.M21 (IO_L1P_T0_D00_MOSI_14), U6.5 (SI_(IO0))
/Main FPGA Configuration/M_S_D1: U4.M22 (IO_L1N_T0_D01_DIN_14), U6.2 (SO_(IO1))
/Main FPGA Configuration/M_S_D2: R41.2, U4.N21 (IO_L2P_T0_D02_14), U6.3 (WP#_(IO2))
/Main FPGA Configuration/M_S_D3: R40.2, U4.N22 (IO_L2N_T0_D03_14), U6.7 (HOLD#_(IO3))
/Main FPGA Configuration/M_S_SELECTn: R42.2, U4.N17 (IO_L6P_T0_FCS_B_14), U6.1 (CE#)
GND: C190.2, C191.2, C192.2, J4.1, J4.3, J4.5, J4.7, J4.9, J4.11, J4.13, R34.2, R35.2, R36.2, R37.2, R47.2, U6.4 (GND), U6.9 (EPAD), U7.2 (GND), U8.2 (GND); also elsewhere on the board
M_DONE: D2.2 (A), R46.2, U4.U9 (DONE_0); also elsewhere on the board
M_INIT_B: R38.2, R45.2, U4.T9 (INIT_B_0)
M_PROG_B: R39.2, R44.2, U4.U11 (PROGRAM_B_0); also elsewhere on the board
unnamed: D2.1 (K), R37.1
unnamed: D3.1 (K), R38.1
unnamed: D4.1 (K), R39.1
unnamed: R47.1, U4.M19 (IO_L3P_T0_DQS_PUDC_B_14)

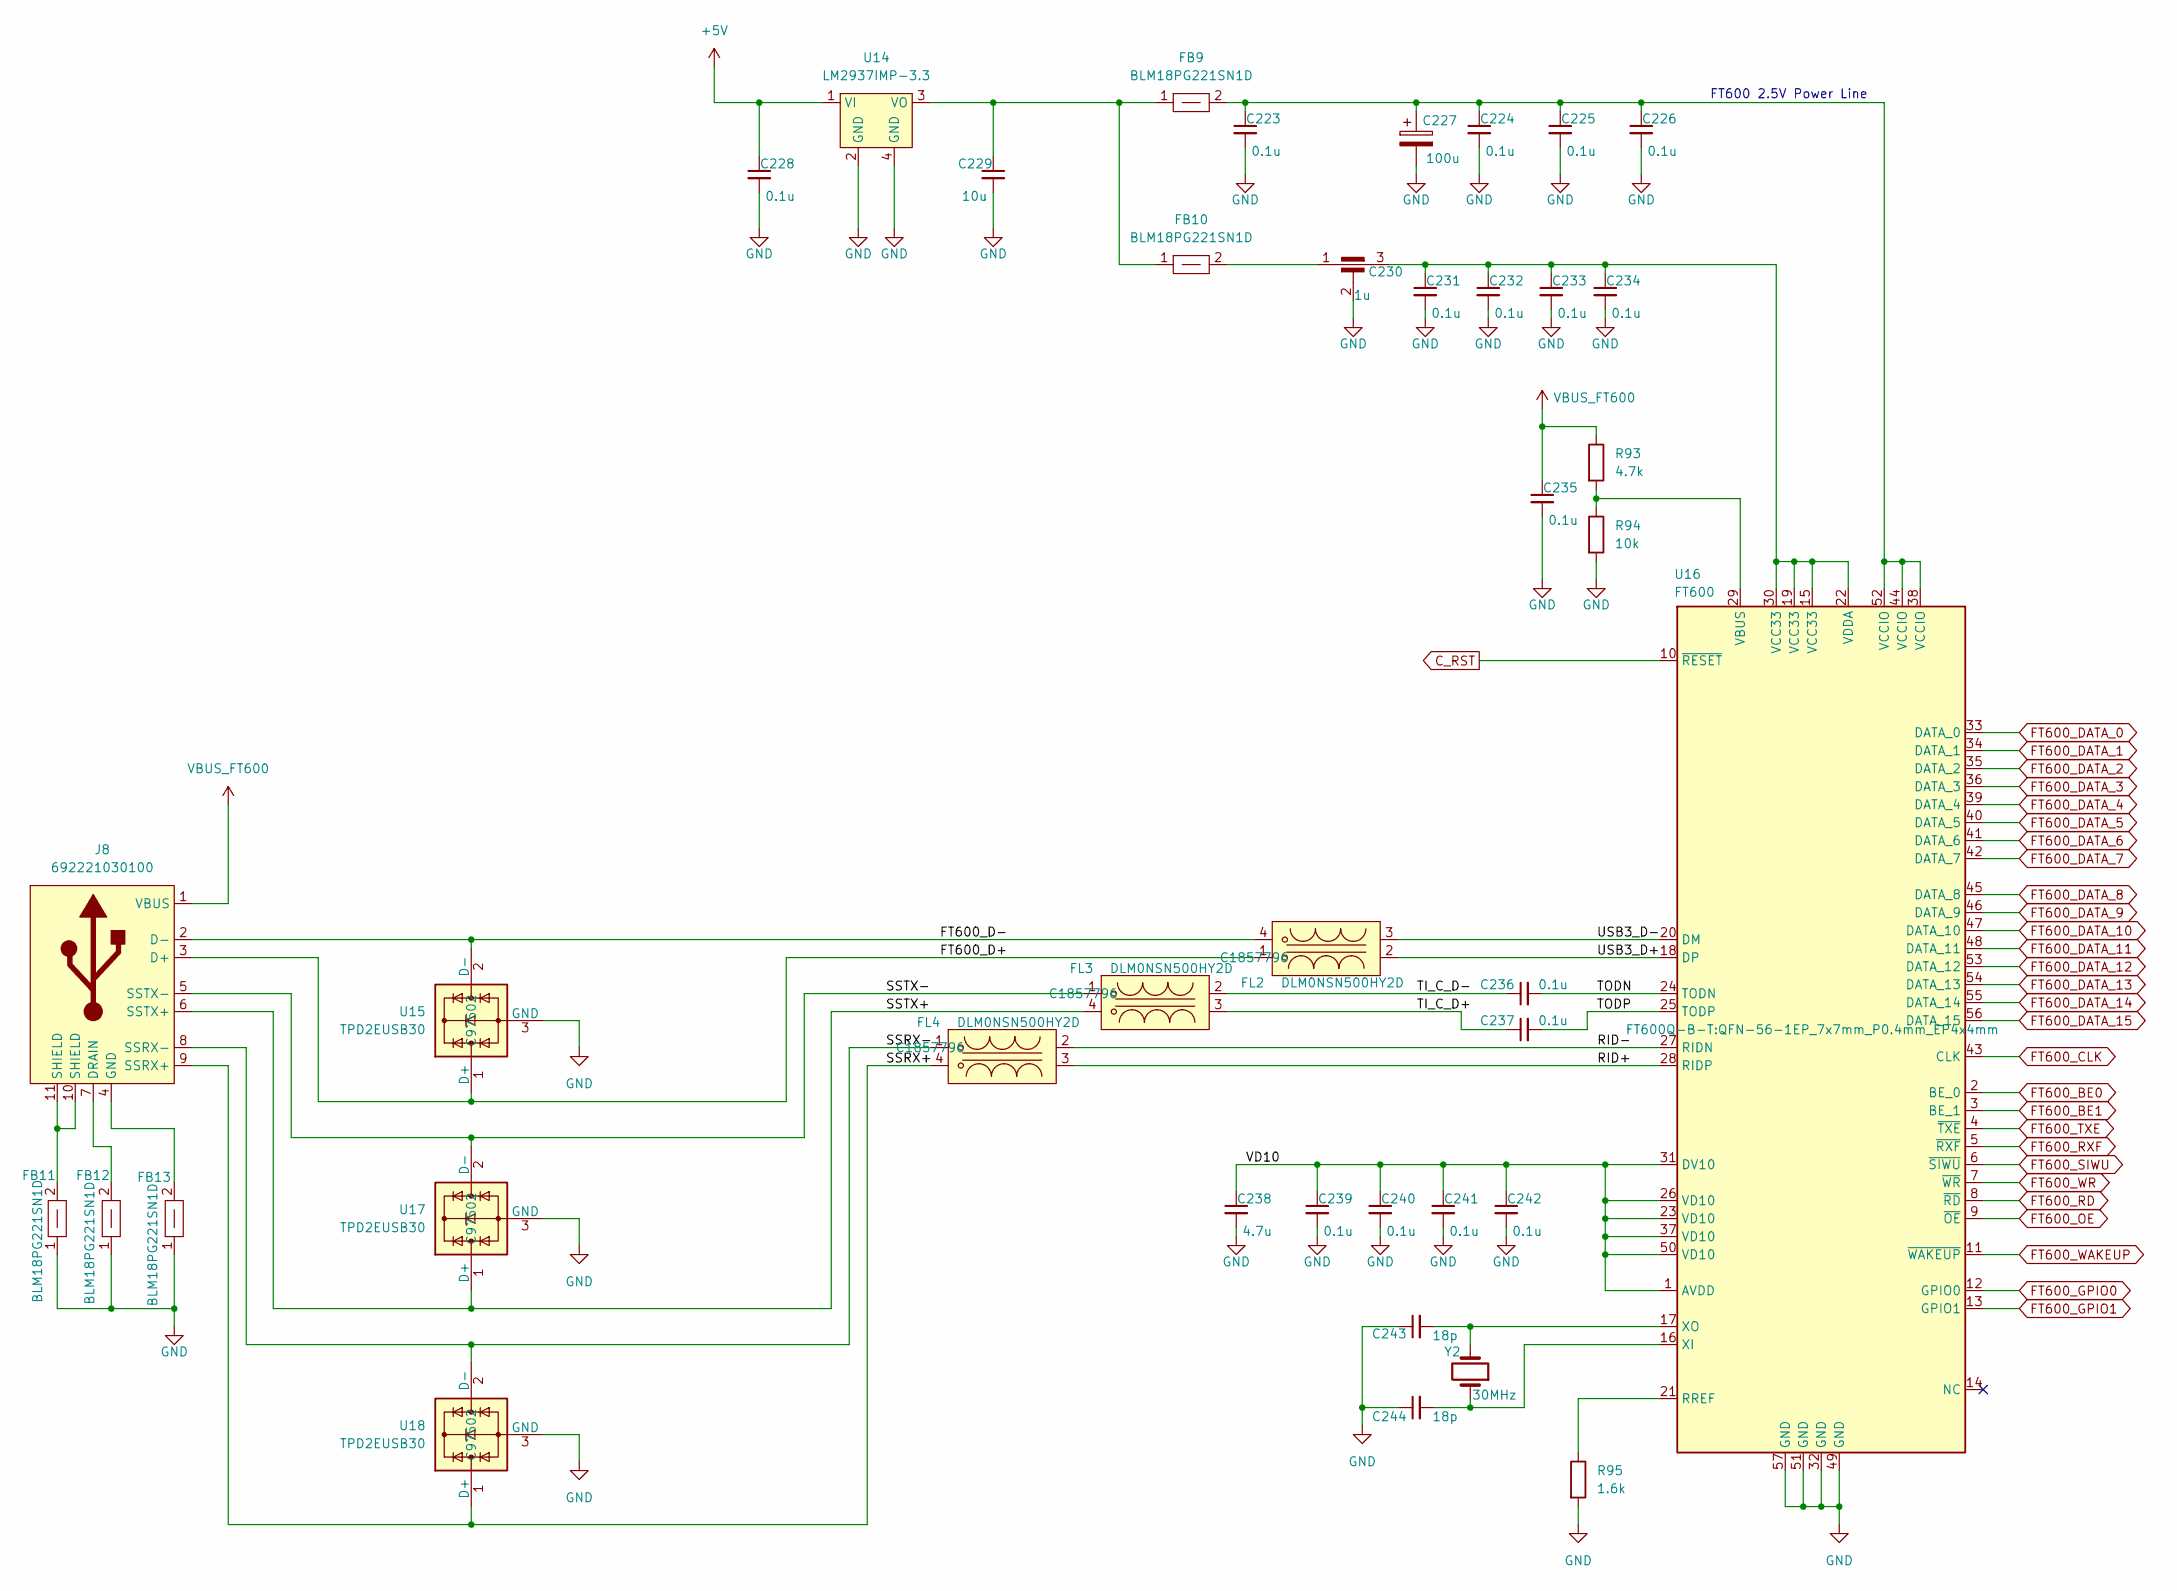
[picture p48: schematic FT600Q.kicad_sch]

Parts:
C223, C224, C225, C226, C228, C231, C232, C233, C234, C235, C236, C237, C239, C240, C241, C242: 0.1u; C_0603_1608Metric; LCSC C77055
C227: 100u; CP_Elec_6.3x7.7; LCSC C48587228
C229: 10u; C_0805_2012Metric; LCSC C440198
C230: 1u; NFM31HK103R1H3L; LCSC C92518
C238: 4.7u; C_0603_1608Metric; LCSC C90057
C243, C244: 18p; C_0603_1608Metric; LCSC C1647
FB9, FB10, FB11, FB12, FB13: BLM18PG221SN1D; BLM18SP221SN1B; LCSC C80165
FL2, FL3, FL4: DLM0NSN500HY2D; LCSC C1857796
J8: 692221030100; LCSC C5334230
R93: 4.7k; R_0603_1608Metric; LCSC C99782
R94: 10k; R_0603_1608Metric; LCSC C95204
R95: 1.6k; R_0603_1608Metric; LCSC C22847
U14: LM2937IMP-3.3; SOT-223; LCSC C140265
U15, U17, U18: TPD2EUSB30; Texas_DRT-3; LCSC C97502
U16: FT600; QFN-56-1EP_7x7mm_P0.4mm_EP4x4mm; LCSC C5252722
Y2: 30MHz; Crystal_SMD_5032-2Pin_5.0x3.2mm; LCSC C19272757

Connections:
+5V: C228.1, U14.1 (VI); also elsewhere on the board
/FT600Q/FT600_D+: FL2.1, J8.3 (D+), U15.1 (D+)
/FT600Q/FT600_D-: FL2.4, J8.2 (D-), U15.2 (D-)
/FT600Q/RID+: FL4.3, U16.28 (RIDP)
/FT600Q/RID-: FL4.2, U16.27 (RIDN)
/FT600Q/SSRX+: FL4.4, J8.9 (SSRX+), U18.1 (D+)
/FT600Q/SSRX-: FL4.1, J8.8 (SSRX-), U18.2 (D-)
/FT600Q/SSTX+: FL3.4, J8.6 (SSTX+), U17.1 (D+)
/FT600Q/SSTX-: FL3.1, J8.5 (SSTX-), U17.2 (D-)
/FT600Q/TI_C_D+: C237.1, FL3.3
/FT600Q/TI_C_D-: C236.1, FL3.2
/FT600Q/TODN: C236.2, U16.24 (TODN)
/FT600Q/TODP: C237.2, U16.25 (TODP)
/FT600Q/USB3_D+: FL2.2, U16.18 (DP)
/FT600Q/USB3_D-: FL2.3, U16.20 (DM)
/FT600Q/VD10: C238.1, C239.1, C240.1, C241.1, C242.1, U16.1 (AVDD), U16.23 (VD10), U16.26 (VD10), U16.31 (DV10), U16.37 (VD10), U16.50 (VD10)
C_RST: U16.10 (~RESET); also elsewhere on the board
FT600_BE0: U16.2 (BE_0); also elsewhere on the board
FT600_BE1: U16.3 (BE_1); also elsewhere on the board
FT600_CLK: U16.43 (CLK); also elsewhere on the board
FT600_DATA_0: U16.33 (DATA_0); also elsewhere on the board
FT600_DATA_1: U16.34 (DATA_1); also elsewhere on the board
FT600_DATA_2: U16.35 (DATA_2); also elsewhere on the board
FT600_DATA_3: U16.36 (DATA_3); also elsewhere on the board
FT600_DATA_4: U16.39 (DATA_4); also elsewhere on the board
FT600_DATA_5: U16.40 (DATA_5); also elsewhere on the board
FT600_DATA_6: U16.41 (DATA_6); also elsewhere on the board
FT600_DATA_7: U16.42 (DATA_7); also elsewhere on the board
FT600_DATA_8: U16.45 (DATA_8); also elsewhere on the board
FT600_DATA_9: U16.46 (DATA_9); also elsewhere on the board
FT600_DATA_10: U16.47 (DATA_10); also elsewhere on the board
FT600_DATA_11: U16.48 (DATA_11); also elsewhere on the board
FT600_DATA_12: U16.53 (DATA_12); also elsewhere on the board
FT600_DATA_13: U16.54 (DATA_13); also elsewhere on the board
FT600_DATA_14: U16.55 (DATA_14); also elsewhere on the board
FT600_DATA_15: U16.56 (DATA_15); also elsewhere on the board
FT600_GPIO0: U16.12 (GPIO0); also elsewhere on the board
FT600_GPIO1: U16.13 (GPIO1); also elsewhere on the board
FT600_OE: U16.9 (~OE); also elsewhere on the board
FT600_RD: U16.8 (~RD); also elsewhere on the board
FT600_RXF: U16.5 (~RXF); also elsewhere on the board
FT600_SIWU: U16.6 (~SIWU); also elsewhere on the board
FT600_TXE: U16.4 (~TXE); also elsewhere on the board
FT600_WAKEUP: U16.11 (~WAKEUP); also elsewhere on the board
FT600_WR: U16.7 (~WR); also elsewhere on the board
GND: C223.2, C224.2, C225.2, C226.2, C227.2, C228.2, C229.2, C230.2, C231.2, C232.2, C233.2, C234.2, C235.2, C238.2, C239.2, C240.2, C241.2, C242.2, C243.1, C244.1, FB11.1, FB12.1, FB13.1, R94.2, R95.2, U14.2 (GND), U14.4 (GND), U15.3 (GND), U16.32 (GND), U16.49 (GND), U16.51 (GND), U16.57 (GND), U17.3 (GND), U18.3 (GND); also elsewhere on the board
unnamed: C223.1, C224.1, C225.1, C226.1, C227.1, FB9.2, U16.38 (VCCIO), U16.44 (VCCIO), U16.52 (VCCIO)
unnamed: C230.1, FB10.2
unnamed: FB11.2, J8.10 (SHIELD), J8.11 (SHIELD)
unnamed: FB12.2, J8.7 (DRAIN)
unnamed: FB13.2, J8.4 (GND)
unnamed: C229.1, FB9.1, FB10.1, U14.3 (VO)
unnamed: R95.1, U16.21 (RREF)
unnamed: R93.2, R94.1, U16.29 (VBUS)
unnamed: C230.3, C231.1, C232.1, C233.1, C234.1, U16.15 (VCC33), U16.19 (VCC33), U16.22 (VDDA), U16.30 (VCC33)
unnamed: C244.2, U16.16 (XI), Y2.1
unnamed: C243.2, U16.17 (XO), Y2.2
VBUS_FT600: C235.1, J8.1 (VBUS), R93.1

Notes on the sheet:
FT600 2.5V Power Line

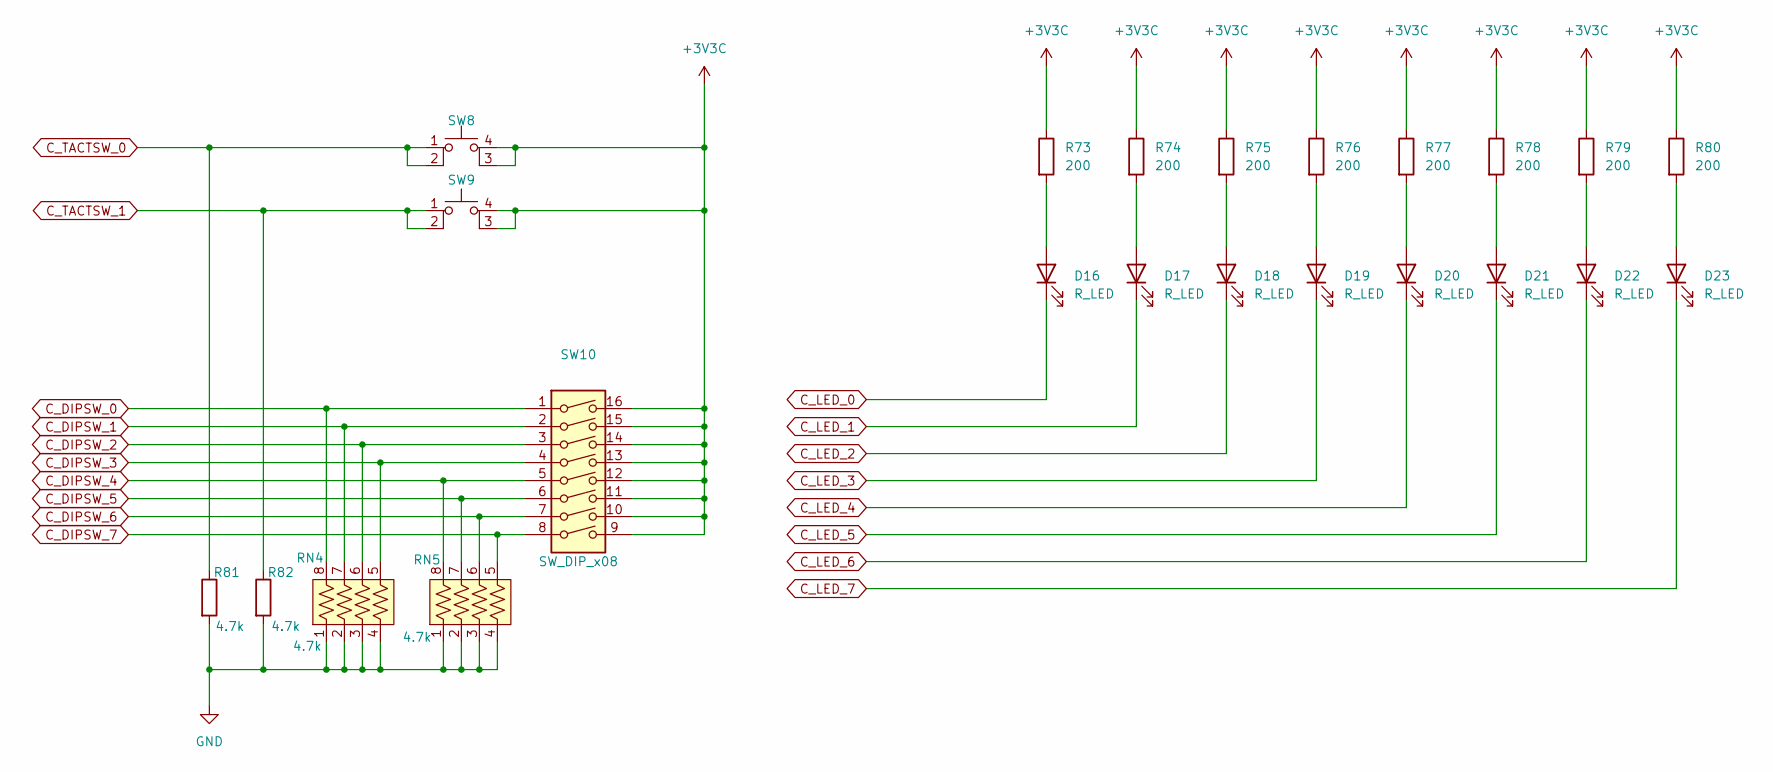
[picture p49: schematic ControlFPGAPeripheral.kicad_sch]

Parts:
D16, D17, D18, D19, D20, D21, D22, D23: R_LED; LED_0603_1608Metric; LCSC C965798
R73, R74, R75, R76, R77, R78, R79, R80: 200; R_0603_1608Metric; LCSC C2907123
R81, R82: 4.7k; R_0603_1608Metric; LCSC C99782
RN4, RN5: 4.7k; YAGEO_R_network; LCSC C327044
SW8, SW9: SW_MEC_5E; MySW_PUSH_6mm_H5mm; LCSC C393938
SW10: SW_DIP_x08; SW_DIP_SPSTx08_Slide_9.78x22.5mm_W8.61mm_P2.54mm; LCSC C2842674

Connections:
+3V3C: R73.1, R74.1, R75.1, R76.1, R77.1, R78.1, R79.1, R80.1, SW8.3 (K), SW8.4 (A), SW9.3 (K), SW9.4 (A), SW10.9, SW10.10, SW10.11, SW10.12, SW10.13, SW10.14, SW10.15, SW10.16; also elsewhere on the board
C_DIPSW_0: RN4.8, SW10.1; also elsewhere on the board
C_DIPSW_1: RN4.7, SW10.2; also elsewhere on the board
C_DIPSW_2: RN4.6, SW10.3; also elsewhere on the board
C_DIPSW_3: RN4.5, SW10.4; also elsewhere on the board
C_DIPSW_4: RN5.8, SW10.5; also elsewhere on the board
C_DIPSW_5: RN5.7, SW10.6; also elsewhere on the board
C_DIPSW_6: RN5.6, SW10.7; also elsewhere on the board
C_DIPSW_7: RN5.5, SW10.8; also elsewhere on the board
C_LED_0: D16.1 (K); also elsewhere on the board
C_LED_1: D17.1 (K); also elsewhere on the board
C_LED_2: D18.1 (K); also elsewhere on the board
C_LED_3: D19.1 (K); also elsewhere on the board
C_LED_4: D20.1 (K); also elsewhere on the board
C_LED_5: D21.1 (K); also elsewhere on the board
C_LED_6: D22.1 (K); also elsewhere on the board
C_LED_7: D23.1 (K); also elsewhere on the board
C_TACTSW_0: R81.1, SW8.1, SW8.2; also elsewhere on the board
C_TACTSW_1: R82.1, SW9.1, SW9.2; also elsewhere on the board
GND: R81.2, R82.2, RN4.1, RN4.2, RN4.3, RN4.4, RN5.1, RN5.2, RN5.3, RN5.4; also elsewhere on the board
unnamed: D16.2 (A), R73.2
unnamed: D17.2 (A), R74.2
unnamed: D18.2 (A), R75.2
unnamed: D19.2 (A), R76.2
unnamed: D20.2 (A), R77.2
unnamed: D21.2 (A), R78.2
unnamed: D22.2 (A), R79.2
unnamed: D23.2 (A), R80.2

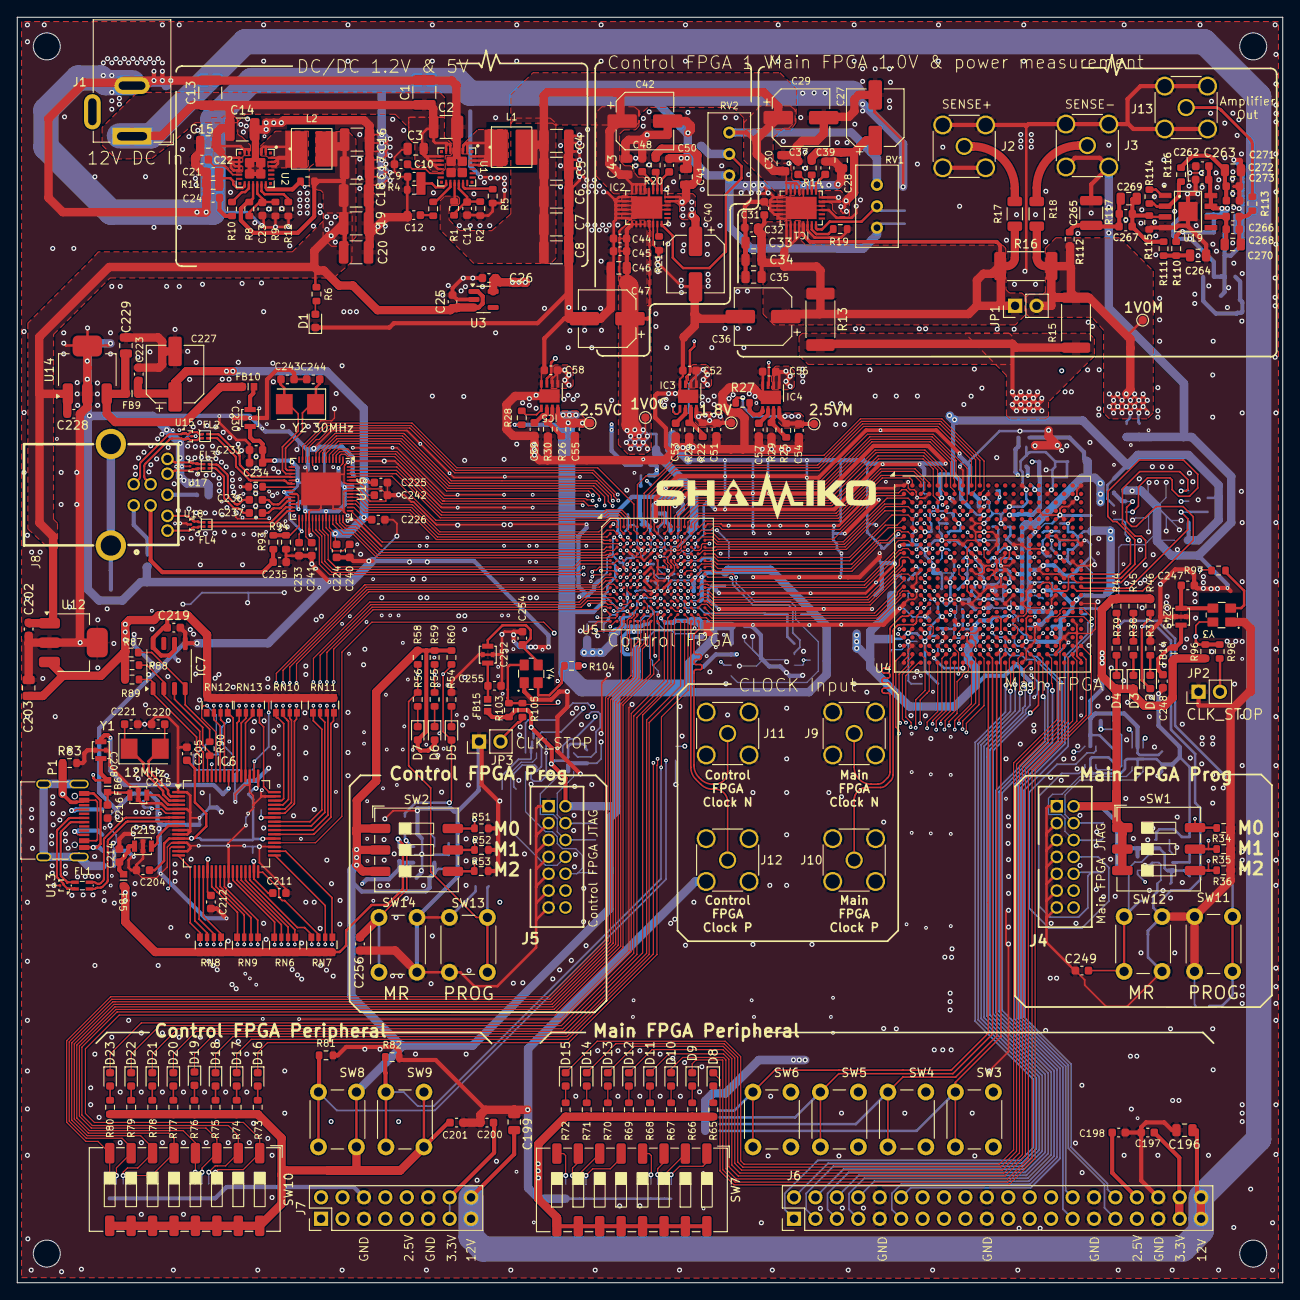
[picture p50: board shamiko.kicad_pcb from above]

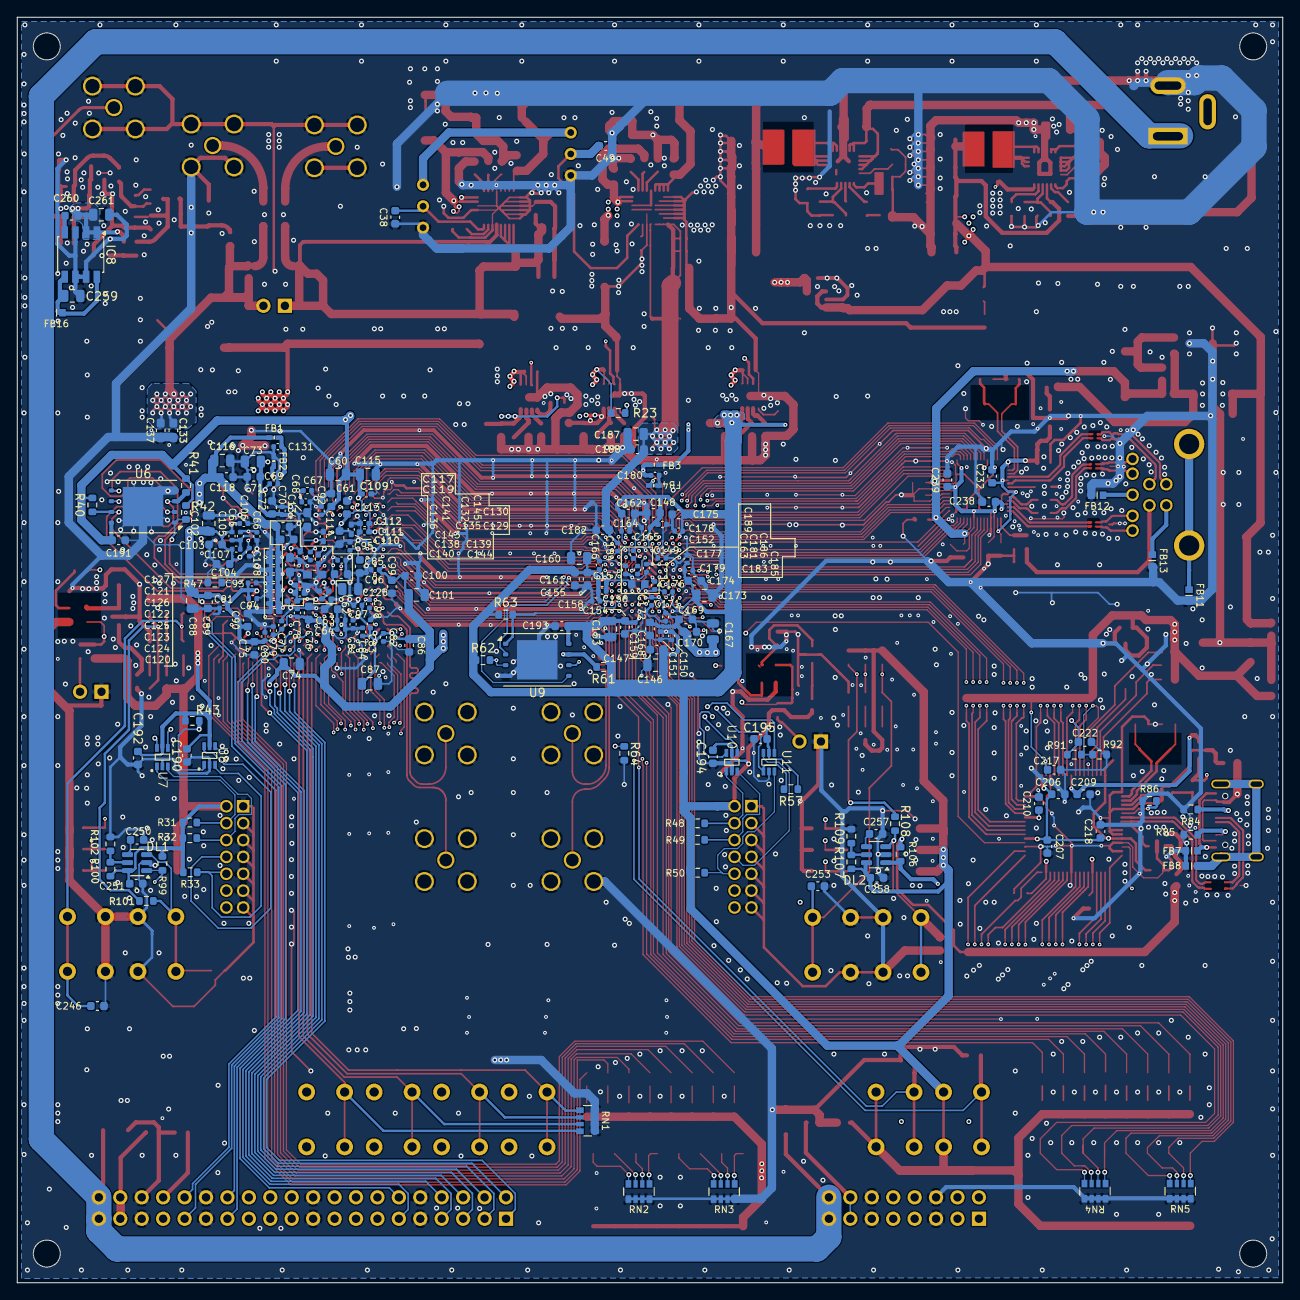
[picture p51: board shamiko.kicad_pcb from below]

Board: 6 copper layers, 150.0 x 150.0 mm, 523 parts (211 on the bottom side), 404 nets.
