SHAMIKO-project/SHAMIKO-board/(commit log)

2026-07-23 Add KiCad design data, docs, and license
    Populate the repository with the SHAMIKO board design per the structure
    described in README.md.
    - hardware/: KiCad project (20 schematic sheets, PCB, project-local
    PartsLib with 22 symbol / 28 footprint libraries)
    - docs/schematic.pdf: exported from the schematic
    - docs/manual/: LaTeX source for the manual
    - docs/images/RevAlphaPhoto.png: board photo referenced by the README
    - LICENSE: MIT
    - .gitignore: KiCad user-local files, LaTeX intermediates, release assets
    Fixed four footprint references that pointed at non-existent footprints,
    aligning them with what the PCB actually uses. Removed unused library
    entries and build-time intermediate files.
    C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
    [ControlFPGAConfig.kicad_sch, ControlFPGAPeripheral.kicad_sch, ControlFPGASv.kicad_sch, ControllerFPGAHeader.kicad_sch, ControllerFPGAIO.kicad_sch, ControllerFPGAPower.kicad_sch, CurrentSensAmplifer.kicad_sch, FT2232HL.kicad_sch]
2026-10-07 Update hardware design and include board logo
    Sync the saved schematics, PCB, project settings, and referenced custom
    libraries with the updated design. Include the LOGO footprint and register
    it in the project footprint table. The board now contains 524 footprints.
    Keep unused source libraries, autosaves, backups, analysis outputs, and
    manufacturing files out of the import. Point BOM exports to the existing
    ignored production directory instead of a workstation-specific location.
    Validation with KiCad 9.0.1:
    - Netlist export succeeds and referenced custom libraries resolve.
    - DRC: 0 errors, 40 warnings, 0 unconnected items, 0 schematic mismatches.
    - ERC: 27 errors and 71 warnings, identica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
    [ControlFPGAConfig.kicad_sch, ControlFPGAPeripheral.kicad_sch, ControlFPGASv.kicad_sch, ControllerFPGAHeader.kicad_sch, ControllerFPGAIO.kicad_sch, ControllerFPGAPower.kicad_sch, CurrentSensAmplifer.kicad_sch, FT2232HL.kicad_sch]
